filippvizvary/sub-mission/docs/quadchart/quad_chart.pdf

FESTIVAL VEDY A TECHNIKY AMAVET 2026 · ROBOTIKA A INTELIGENTNÉ STROJE | CELOŠTÁTNE KOLO · BRATISLAVA, 16.–17. 11. 2026

# Sub-Mission

Filip Vizváry, Šimon Filus | Gymnázium Milana Rúfusa, Žiar nad Hronom

Vedecká otázka / Ciele

Dá sa stanica na monitorovanie kvality vody napájať výhradne z
kinetickej energie toku — bez batérie na výmenu, bez slnka a bez operátora?
Riešenie: sonda bez kábla, batérie aj slnka — energiu berie z prúdiacej vody, dáta posiela rádiom.
Štátna sieť vzorkuje kvalitu vody približne raz za mesiac; hydrologické stanice chémiu nezachytia.
Budča 26. 7. 2021: 500 m³ digestátu, 37 km Hrona, 27 t rýb (25 druhov); nahlásili to rybári o 6:30, nie meracia sieť.
Ciele: sebestačnosť, 96 meraní denne namiesto 12 za rok, nasadenie bez zásuvky a signálu; kritériá: energia >10×, spojka >2,5×.

Dáta a výsledky

Výpočet (BEM model rotora + MPPT): výkon na hriadeli a z generátora proti rýchlosti toku. Spotreba 0,32 mW je o 2–3 rády nižšia.

Výpočet (magnetostatický
model): sklzový moment
spojky proti vzduchovej
medzere, proti záťaži rotora 0,16 N·m.

Metodológia / Návrh projektu

Bez otvoru pre hriadeľ: moment prenáša magnetická spojka (8 × N52 Ø10×5) cez pevnú 4 mm stenu podu.
Reťaz: BLDC generátor → usmerňovač → 2× superkondenzátor → regulátor 3,3 V.
Meranie: pH, TDS, turbidita, teplota, prietok z otáčok generátora; ESP32 s LoRa 868 MHz, dosah desiatky až stovky metrov bez výkonných antén.
Návrh overený výpočtom: BEM model rotora, model spojky, energetický model (Python, verejné repo).

Interpretácia a závery

Sebestačnosť je dosiahnuteľná: pri 0,5 m/s dáva generátor 25 mW (2 156 J/deň) proti 28 J/deň spotreby — rezerva 77×. Superkondenzátor drží 134 J použiteľnej energie = 4,8 dňa bez toku.
Spojka má pri 4–5 mm stene rezervu 4,9–6,5×, takže pod je utesnený bez pohyblivého tesnenia.
Obmedzenia, pomenované vopred: prototyp je doteraz na USB a generátor nikdy nenapájal dosku; test v rieke neprebehol; dosah LoRa overený len v interiéri; moment zubov nemeraný, rýchlosť rozbehu neznáma; pH je servisná veličina (14–30 dní).
Ďalej: spojenie harvestora s doskou, terénny test toku a dosahu, kalibrácia pH, nasadenie na lokalite.
Grafy a čísla sú výpočtom z modelov vo verejnom repe sub-mission (BEM, MPPT, magnetostatický model); meranie v rieke zatiaľ neprebehlo. | 2026
