filippvizvary/sub-mission/docs/quadchart/charts/energia.png

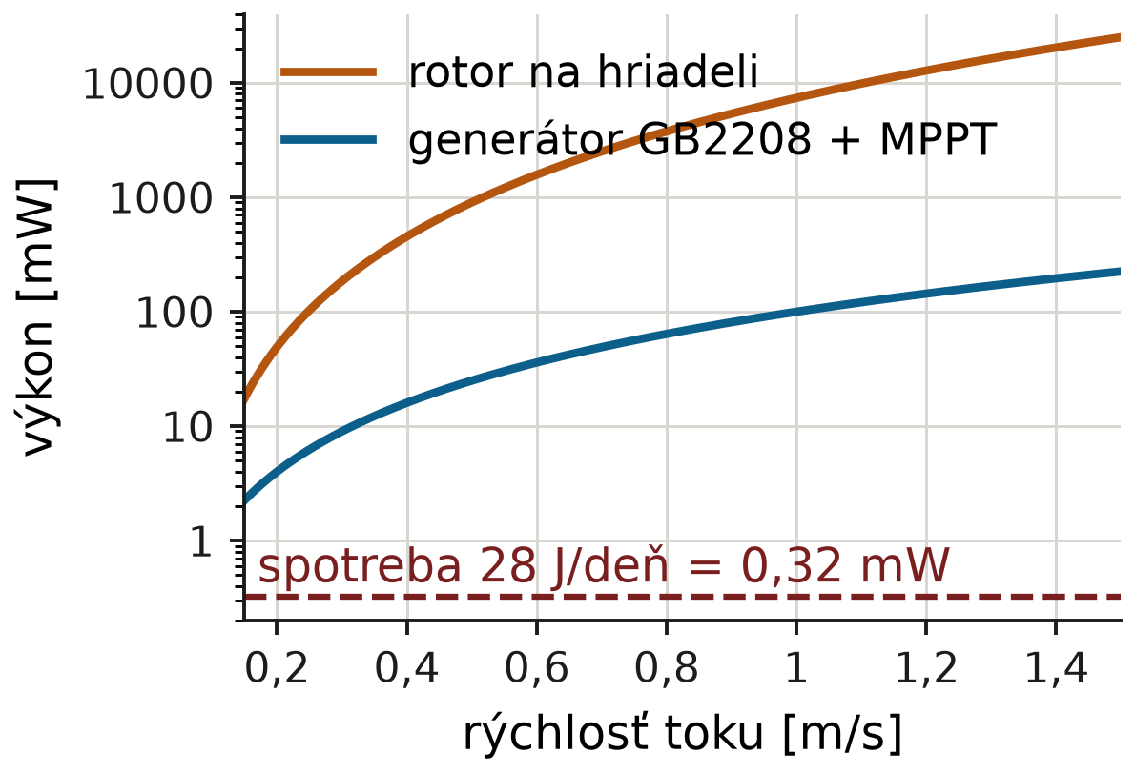
docs/quadchart/charts/energia.png
