filippvizvary/sub-mission/docs/quadchart/charts/schema.png

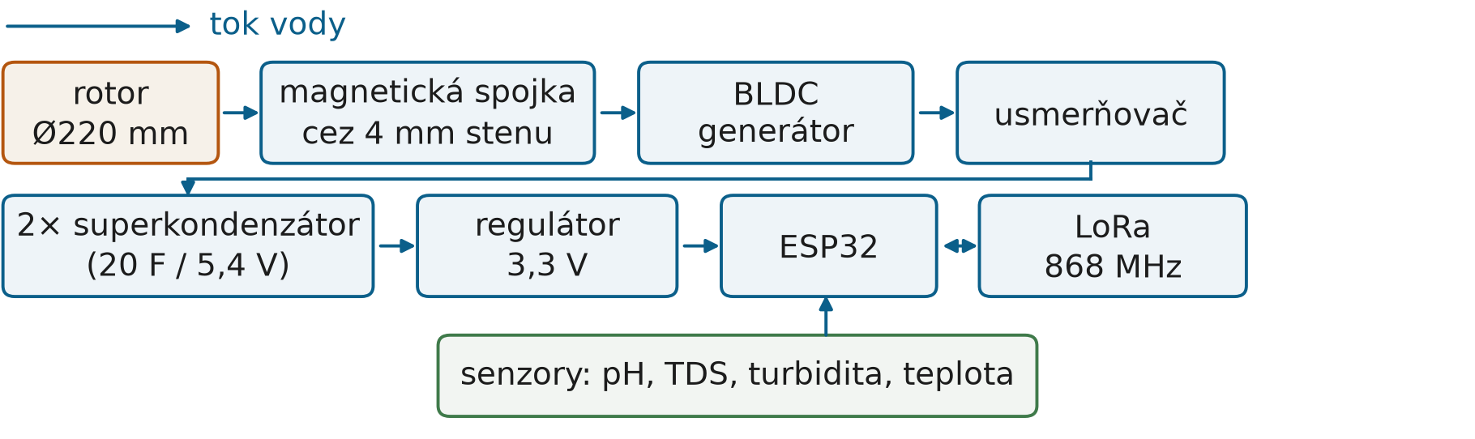
docs/quadchart/charts/schema.png
