filippvizvary/sub-mission/docs/quadchart/charts/spojka.png

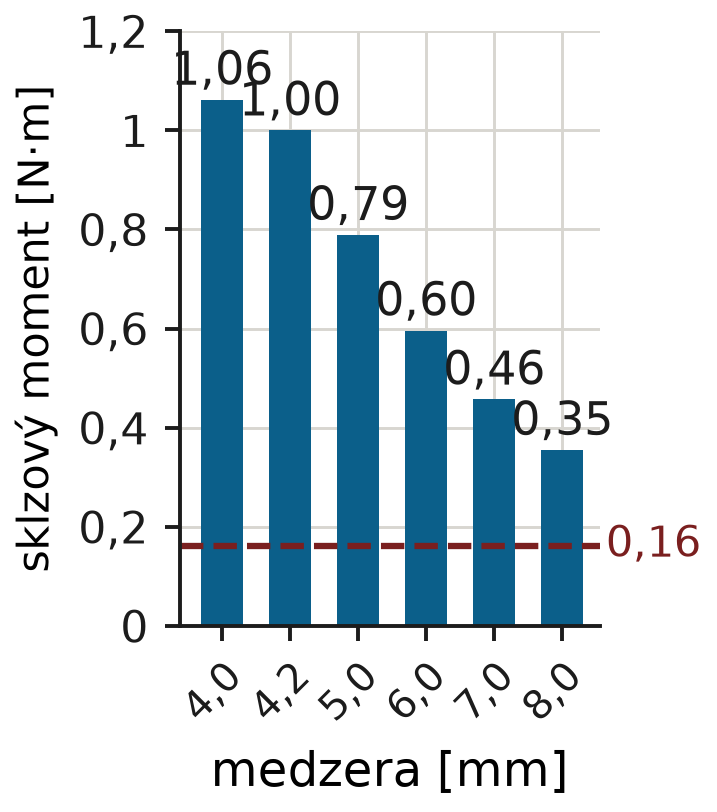
docs/quadchart/charts/spojka.png
