filippvizvary/sub-mission/docs/quadchart/prev2-1.jpg

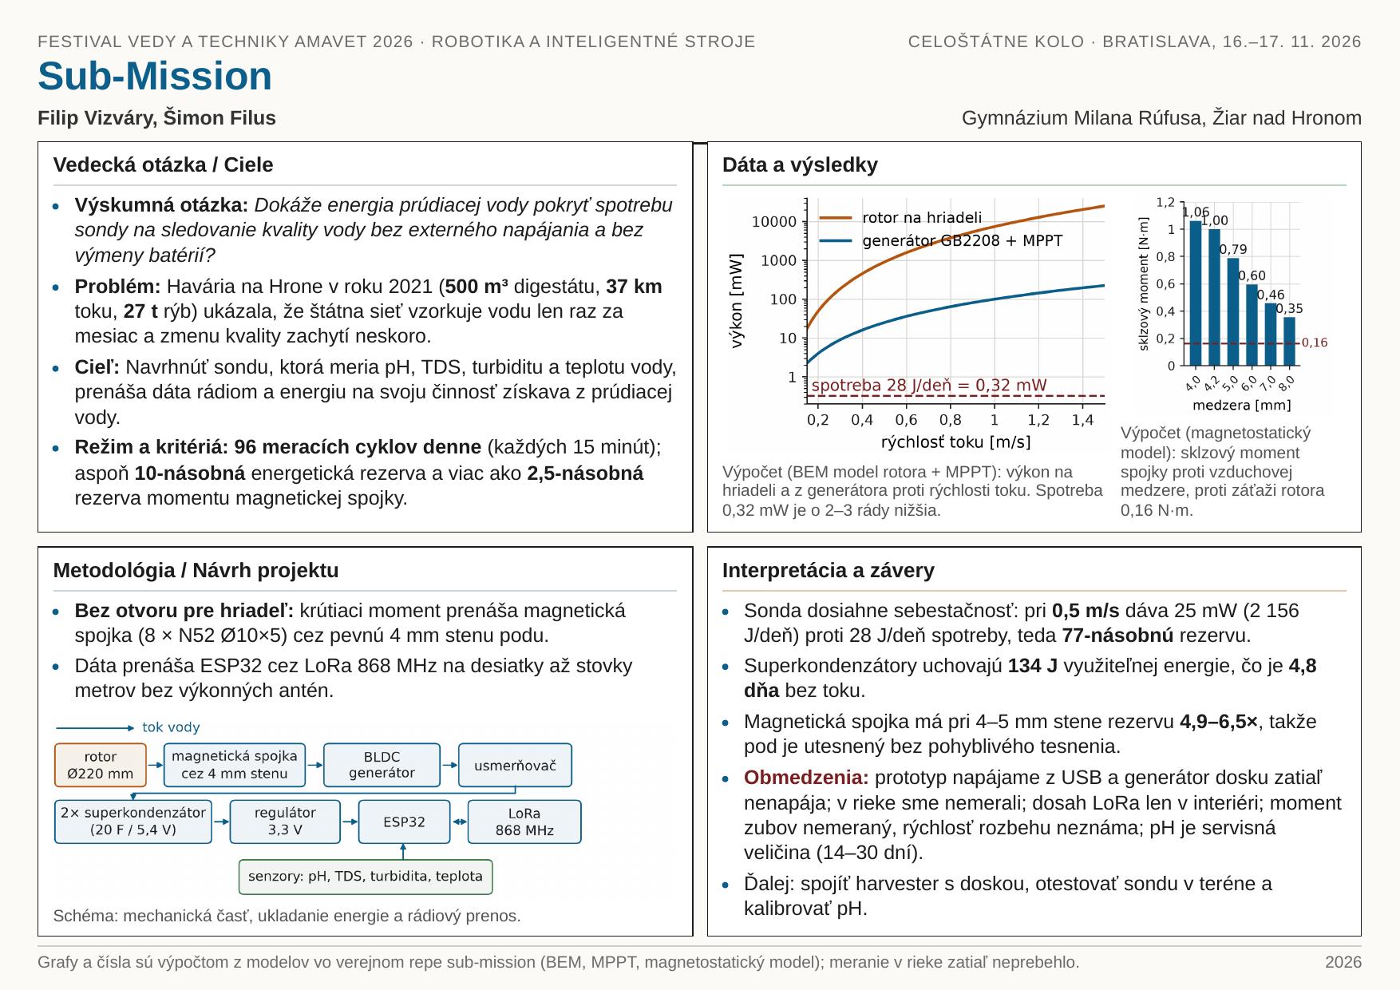
docs/quadchart/prev2-1.jpg
