filippvizvary/sub-mission/docs/PARTS_LIST.csv

id | subsystem | part | spec | qty_probe | qty_site | qty_gateway | source | price_eur | status | notes | phase | owned | link
A01 | rotor | Blade | triple-blade rotor, NACA 4-digit m4% t/c20%, D220, TSR5 alpha5: pitch 38.7->12.6 deg, chords 34.8->8.3 mm, TE 0.5 mm blunt, nose cone integrated | 3 | 0 | 0 | printed in-house | - | printed | t/c 12% gave 44 mm of tip sag at 8 N/blade; 20% gives 9.3 mm and drops the root stress to 7.1 MPa. Blade is the designed fuse - carry 2 spares | 1 | NO
A02 | rotor | Hub | Ø64x46mm, D-bore keyed on the shaft flat; NO inserts, NO set screws | 1 | 0 | 0 | printed in-house | - | printed | keyed by the flat (form drive, 4.2 MPa in ABS) and epoxied to the shaft for axial retention. A screw cannot cross the 29.5 mm wall from the Ø64 OD to the Ø5 shaft, and M4x30 was not available | 1 | NO
A03 | rotor | Wet shaft | 316L Ø5 h9 x 78mm drawn, PLAIN ROUND - no flat | 1 | 0 | 0 | nerezmaterial.cz | 2.6 | verified | The flat is gone: the hub, both cups and the old stop collars all used it and all three are replaced by the two-piece bolted clamps. Nothing to file. The shaft is located and driven by the clamps alone (friction: 0.9 N*m against 0.164). | 1 | NO
A04 | rotor | Wet bearing | igus iglidur J plain bearing JSM-0507-05 5x7x5mm | 2 | 0 | 0 | tme.eu | 1.18 | verified | 83 pcs in stock; JFM-0507-05 flanged 1.48 USD alt | 1 | NO | https://www.tme.eu/sk/details/jsm-0507-05/klzne-loziska/igus/
A05 | rotor | Bearing carrier tube | 316L Ø12xØ8x55mm | 1 | 0 | 0 | nerezmaterial.cz | 1.2 | quote | CUT: superseded - the bearing carrier is the printed spider (wet_carrier) | cut | NO
A06 | rotor | Hub cap screws | M4 x 30 socket head DIN 912, 2 pcs, tip on a 0.5 mm shaft flat | 2 | 0 | 0 | tme.eu | 0.4 | cut | CUT: no set screws anywhere in the drivetrain. Do not order M4x30. | 1 | NO | https://www.tme.eu/sk/katalog/?search=ISO%204029%20M4x8
A07 | rotor | Weed guard ring | Ø250 printed ring + 3 struts 40mm upstream of blade plane | 1 | 0 | 0 | printed in-house | - | printed | CUT: killed by design - replaced by the nose cone D64->D12; a ring on struts upstream is an algae scythe | cut | NO
A08 | rotor | Blade safety retainer | 3mm stainless lanyard + crimp ferrule | 3 | 0 | 0 | tme.eu | 2.0 | verified | CUT: killed by design - a tether on a 110 mm blade is a flail, and the hole is a stress riser at the root | cut | NO
A09 | rotor | Shaft collar Ø5 | Ø5 shaft collar, M3 grub screw, 4mm wide (axial stop between spider boss and wet cup) | 1 | 0 | 0 | local / TME | 1.5 | cut | CUT: the cup's 10 mm boss butts the static spider boss face at 61, so the cup cannot slide upstream. No bought collar. | 1 | NO
A10 | rotor | Dry shaft | 316L Ø5 h9 x 37mm, from the same 3m bar as A03 | 1 | 0 | 0 | nerezmaterial.cz | 0.3 | verified | 85..122 in the assembly: runs through the 695ZZ, gripped by the dry cup clamp at 93..105, and its end sits at the Oldham hub A slot floor | 1 | NO
A11 | rotor | Dry bearing | 695ZZ 5x13x4, 2Z metal shield (never 2RS - rubber seal drag is visible at 100mW) | 1 | 0 | 0 | eshop.valiveloziska.sk / loziskaelm.sk | 5.0 | todo | was missing from this list entirely; presses into the Ø13 H7 seat in the barrel's dry bearing boss | 1 | NO
A12 | coupling | Cup drive pin | Ø2 x 12 dowel pin, 2 pcs (wet cup + dry cup) | 2 | 0 | 0 | local / TME | 0.3 | cut | CUT: the cup is driven by a D-bore on the shaft flat. No Ø2 cross pin, no drilling a Ø2 hole through Ø5 stainless. | 1 | NO
B01 | coupling | Magnet | N52 D10x5 axially magnetised, canned 316L or epoxy potted | 24 | 0 | 0 | supermagnete.cz | 0.55 | verified | 24x N52 D10x5 (S-10-05-N52N, 3.3 kg) - 12 per cup, all of them; Filip has exactly 24 | 1 | NO | https://www.supermagnete.cz/kotoucove-magnety-neodymove/kotoucovy-magnet-10mm-5mm_S-10-05-N52N
B02 | coupling | Magnet cup | D70 x 5.65, 12 pockets D10.2x5.2 from the BACK, printed ASA | 2 | 0 | 0 | printed in-house |  | printed | ONE part for both cups, print twice. 0.45 mm membrane at the face (3 layers, printed on the bed); magnets go in from behind and the cover 14 closes them - no glue relied on | 1 | NO
B03 | coupling | Separation wall | D106 x 4 mm - RECOMMENDED integral with the pod bulkhead (no separate part) | 1 | 0 | 0 | nerezmaterial.cz / printed |  | cut | CUT: the 4mm bulkhead is printed as part of the barrel (cad/probe_cq.py make_pod) - nothing pierces the barrier, so there is no separate wall to seal | 1 | NO
B04 | coupling | Potting compound | 3M Scotch-Weld DP270 black 25ml | 1 | 0 | 0 | techfun.sk | 14.0 | verified | techfun nema DP270; silikonova zalievacia hmota staci na test, epoxid je tuhsi | 1 | NO | https://techfun.sk/produkt/ag-termopasty-priehladna-silikonova-zalievacia-hmota-037-100g/
B05 | coupling | Cup thrust washer (printed) | ABS ring Ø24/Ø8 x 1 mm, printed (r 4..12), sits in a 1 mm recess in the bulkhead's wet face | 1 | 0 | 0 | printed in-house | 0 | printed | printed ABS, 0.4 cm3, 4 min. GREASE IT with Molykote 111 (J05) - it is the same material as the barrel face, so the ring only lowers pressure and speed, the grease is what lowers friction. | 1 | NO
C01 | pod | Pod barrel | Ø110x120mm printed ASA wall 2.4mm + epoxy barrier | 1 | 0 | 0 | printed in-house | - | printed | one print: barrel + 4mm bulkhead + dry bearing boss (Ø13H7 seat for 695ZZ) + 4 spider bosses + O-ring groove + 6 clamp lugs | 1 | NO
C02 | pod | Tail cone | printed integral | 1 | 0 | 0 | printed in-house | - | printed |  | 1 | NO
C03 | pod | Pod O-ring | NBR 70 Ø100x2.5 | 1 | 0 | 0 | tme.eu | 3.0 | verified | NBR70 Ø100x2.5 (mars.sk code 879) seals the adapter joint at the barrel's downstream face | 1 | NO | https://www.tme.eu/sk/katalog/?search=O-krouzek%20100x2.5
C04 | pod | O-ring groove | 2.2mm wide x 1.8mm deep machined/printed into pod rim | 1 | 0 | 0 | in CAD | - | printed | groove is modelled in the barrel's downstream face: r 50.8-53.0, 2.2 x 1.8, printed on a flat top face | 1 | NO
C05 | pod | Pod clamp screws | M4x30 A4 + washers | 1 | 0 | 0 | tme.eu | 3.0 | verified | drzi zadny spoj; integralny bulkhead riesi len prednu stranu | 1 | NO | https://www.tme.eu/sk/katalog/?search=sroub%20M4x30%20A4
C06 | pod | Desiccant | 5g silica gel with indicator | 2 | 0 | 0 | local shop | 2.0 | verified | replace at service | 1 | NO | https://www.hornbach.sk/
C07 | pod | Cable gland wet side | Lapp Skintop MS-M 12x1.5 + Scotchcast 2131 | 1 | 0 | 0 | tme.eu | 12.0 | verified | NOT YET IN MODEL - add boss | 1 | NO | https://www.tme.eu/sk/katalog/?search=Skintop%20M12
C08 | pod | Generator | T-Motor GB2208 KV128 or X-TEAM XTG3506 (24N22P 6ohm w/ AS5048A encoder) | 1 | 0 | 0 | sk.x-teamrc.com / tmotor | 26.0 | verified | TEST BEZ GENERATORA: klietka + senzory stacia, generator je dalsi nakup; XTG3506 preferred: encoder = free RPM/flow | 1 | NO | https://www.x-teamrc.com/product/x-team-3506-gimbal-brushless-motor/
C09 | pod | Generator mount | printed cradle + 4x M3x8 A4 | 1 | 0 | 0 | printed in-house | 1.0 | printed | GB2208 cradle: bolts to the motor's own base bolt circle - measure the pattern on arrival; Oldham hub B on the bell's 4x M3 face | 1 | NO
D01 | sensors | pH electrode | DFRobot SEN0161-V2 Gravity pH kit + E201 BNC probe | 1 | 0 | 0 | techfun.sk | 39.0 | verified | pH kit: 39 EUR, 14-30 dni servis | OPTIONAL per site; 14-30 day service; +-0.1 pH after 2-pt cal | 2 | NO
D02 | sensors | pH spare electrode | E201-C BNC | 2 | 0 | 0 | techfun.sk | 9.0 | verified | pH spare electrodes: 18 EUR | consumable | 2 | NO
D03 | sensors | pH buffer | 2x250ml pH7 + pH10 | 1 | 0 | 0 | techfun.sk | 12.0 | verified | pH buffers: 12 EUR | consumable | 2 | NO
D04 | sensors | Temperature | DS18B20 waterproof 1m cable | 1 | 0 | 0 | techfun.sk | 5.0 | verified | in model as sensor_ntc | 1 | NO | https://techfun.sk/produkt/dfrobot-vodeodolny-senzor-teploty-ds18b20/
D05 | sensors | Level / stage probe | Submersible IP68 316L, 0-1 mH2O, 0.5-4.5V out, 5m cable, permanent immersion rated | 1 | 0 | 0 | TME / sensorsone (quote) | 110.0 | quote | level: 110 EUR, quote; bez varovania pred povodnou | MS5837-30BA REJECTED: gel element must be dried daily, 24h max submersion | 2 | NO
D06 | sensors | EC/TDS | DFRobot SEN0244 Gravity analog TDS module + probe | 1 | 0 | 0 | tme.eu | 14.0 | verified | +-10% FS is the weakest sensor; use as trend indicator, site-calibrate | 1 | NO | https://www.tme.eu/sk/katalog/?search=SEN0244
D07 | sensors | Turbidity | DFRobot SEN0189 (0-4.5V analog) | 1 | 0 | 0 | techfun.sk | 12.45 | verified | 6 in stock; in model as sensor_turb | 1 | NO | https://techfun.sk/produkt/dfrobot-turbidity-senzor-zakalu-vody/
D08 | sensors | Sensor cable | 4x2x0.5mm shielded PUR outdoor | 1 | 0 | 0 | tme.eu | 20.0 | verified | sensor cable 20 EUR - F01 8-zilovy to unesie | | 2 | NO
D09 | sensors | Dissolved oxygen kit | DFRobot SEN0237-A Gravity analog DO, 0-20 mg/L, BNC probe, 2m cable | 1 | 0 | 0 | global-ic.sk / botland.cz | 175.0 | verified | DO: 175 EUR, membrana 1-2 mesiace - prvy kandidat | HIGHEST-VALUE channel (Budca = hypoxia); membrane 1-2 months in muddy water; 0.5M NaOH filling solution NOT shipped by air - source locally | 2 | NO
E01 | cage | Sensor cage | Ø130x150 printed ASA 12 slots | 1 | 0 | 0 | printed in-house | - | printed | in model as cage | 1 | NO
E02 | cage | Cage fasteners | M3x10 A4 + nylok | 1 | 0 | 0 | tme.eu | 6.0 | verified |  | 1 | NO | https://www.tme.eu/sk/katalog/?search=sroub%20M3x10%20A4
E03 | cage | Sensor holders | printed clips for pH/TDS/turbidity/NTC/MS5837 | 5 | 0 | 0 | printed in-house | - | printed | in model as sensor bodies | 1 | NO
F01 | interface | Cable | 8x0.5mm2 PUR jacket submersible 6m | 1 | 0 | 0 | tme.eu | 35.0 | verified |  | 1 | NO | https://www.tme.eu/sk/katalog/?search=kabel%20PUR%208x0.5
F02 | interface | Bulkhead connector | potted gland entry (NOT SubConn) | 1 | 0 | 0 | tme.eu | 12.0 | verified | cost cut from 85 EUR wet-mate | 1 | NO | https://www.tme.eu/sk/katalog/?search=priechodka%20M12%20IP68
G01 | drybox | Enclosure | IP68 ready-made 190x130x80mm | 1 | 0 | 0 | tme.eu | 22.0 | verified | vynechane: vodotesna krabica na brehu - nie je sucastou stavby | in model as site_box | 2 | NO | https://www.tme.eu/sk/katalog/?search=box%20IP68
G02 | drybox | MCU (NOT USED in simple build) | LaskaKit ESP32-S3-DEVKit | 1 | 0 | 0 | laskakit.cz | 0.0 | verified | DROPPED: Wio-E5 mini is the single brain (MCU+LoRa). Bring back only if we need more GPIO/dual-core. | cut | NO
G03 | drybox | MCU + radio (single board) | Seeed XIAO nRF52840 + Wio-SX1262 kit (Meshtastic), SEE336 - nRF52840 + SX1262 | 1 | 0 | 0 | rpishop.cz | 14.00 | verified | 349 Kc, skladom 5+; nahradza Wio-E5, ktory v CZ/SK nie je; antena je v kite | 1 | NO | https://rpishop.cz/694263/seeed-studio-xiao-nrf52840-wio-sx1262-kit-pro-meshtastic/
G04 | drybox | Antenna probe | 868MHz 5dBi SMA-M omni 195mm | 0 | 0 | 1 | techfun.sk | 6.00 | verified | jedna 5 dBi na gateway; sonde staci bicik z kitu | 1 | NO | https://www.tme.eu/sk/katalog/?search=868%20MHz%20antena%20SMA
G05 | drybox | u.FL -> SMA pigtail | u.FL/IPEX female na SMA female bulkhead, 10-15 cm, RG178 | 1 | 0 | 1 | tme.eu | 3.00 | verified | KIT MA U.FL, NIE SMA: bez pigtailu na vacsiu antenu nepripojis; 1x sonda, 1x gateway | 1 | NO | https://www.tme.eu/sk/katalog/?search=u.FL%20SMA%20pigtail
G06 | drybox | Boost harvester | LTC3105EFE MPPT boost | 1 | 0 | 0 | tme.eu | 5.0 | verified | needed when EMF below bus | 1 | NO | https://www.tme.eu/sk/katalog/?search=LTC3105
G07 | drybox | Buck | TPS62A02DRC step-down | 1 | 0 | 0 | tme.eu | 2.5 | verified |  | 1 | NO | https://www.tme.eu/sk/katalog/?search=TPS62A02
G08 | drybox | Rectifier | Nexperia PMEG2010AEB 20V 1A SOD-523 | 6 | 0 | 0 | tme.eu | 0.15 | verified | 452k in stock | 1 | NO | https://www.tme.eu/sk/katalog/?search=PMEG2010AEB
G09 | drybox | Clamp | TL431LIAQ + MJD127T4G + PWR263S 3.3R dump | 1 | 0 | 0 | tme.eu | 4.0 | verified | overvoltage protection | 1 | NO | https://www.tme.eu/sk/katalog/?search=TL431
G10 | drybox | Supercap | Eaton XLR-4R0507 LIC 500F 4.0V | 1 | 0 | 0 | tme.eu | 11.0 | quote | NO coin-cell EDLC (50ohm ESR kills TX) | 1 | NO | https://www.tme.eu/sk/katalog/?search=XLR-4R0507
G11 | drybox | Voltage supervisor | TLV840 nanopower | 1 | 0 | 0 | tme.eu | 1.5 | verified | gates buck at 4.8V | 1 | NO | https://www.tme.eu/sk/katalog/?search=TLV840
G12 | drybox | Load switch | TPS22860 x2 for pH/EC sequencing | 2 | 0 | 0 | tme.eu | 1.0 | verified | removes ground-loop need | 1 | NO | https://www.tme.eu/sk/katalog/?search=TPS22860
G13 | drybox | Barometer | BME280 module outside potting in vented sub-box | 1 | 0 | 0 | laskakit.cz | 6.0 | verified | barometer 6 EUR - level sonda je gauge, netreba | pressure reference for MS5837 | 2 | NO
G14 | drybox | PCB | custom 2-layer 60x80mm | 1 | 0 | 0 | jlcpcb | 3.0 | quote | panel of 10 amortises | 1 | NO | https://jlcpcb.com/
G15 | drybox | Connectors | JST-PH/XH assortment + crimps | 1 | 0 | 0 | laskakit.cz | 10.0 | verified |  | 1 | NO | https://www.laskakit.cz/vyhledavani/?string=JST
G16 | drybox | Protection | Fuse 0.5A + TVS + ESD array | 1 | 0 | 0 | tme.eu | 6.0 | verified | NEMAM - poistka 0.5A + TVS SMBJ5.0A + ESD array (SOT-23-6) | 1 | NO | https://www.tme.eu/sk/katalog/?search=SMBJ5.0A
G17 | drybox | Cable glands | M12 IP68 potted x3 | 3 | 0 | 0 | tme.eu | 3.0 | verified |  | 1 | NO | https://www.tme.eu/sk/katalog/?search=priechodka%20M12%20IP68
H01 | site | Ground screw anchor | M68 x 800mm solar-fence ground screw | 0 | 1 | 0 | hornbach | 25.0 | verified | 1-2kN lateral - covers flood case | 1 | NO | https://www.hornbach.sk/
H02 | site | Pole | scaffold tube Ø48.3x3.2 x 3000mm galvanised | 0 | 1 | 0 | stavebniny | 18.0 | verified | removable mast pinned into receiver | 1 | NO | https://www.hornbach.sk/
H03 | site | Receiver sleeve | Ø52 tube 300mm + pin holes | 0 | 1 | 0 | metal shop | 8.0 | quote | receiver sleeve 8 EUR - pole sa da pripinacit priamo | pinned mast interface | 2 | NO
H04 | site | Arm tube | alu Ø28x1.5 x 1300mm | 0 | 1 | 0 | hornbach | 9.0 | verified |  | 1 | NO | https://www.hornbach.sk/
H05 | site | Drop tube | alu Ø22x1.5 x 900mm | 0 | 1 | 0 | hornbach | 6.0 | verified |  | 1 | NO | https://www.hornbach.sk/
H06 | site | Hinge collar | printed ASA + M8 A4 bolt | 0 | 1 | 0 | printed + tme | 3.0 | printed |  | 1 | NO
H07 | site | Shear pin | M4 316SS pin + 2 spares on pole collar | 0 | 1 | 0 | tme.eu | 1.0 | verified | releases pod on >150N debris hit | 1 | NO
H08 | site | Yaw strut | alu Ø22x600mm + 2 clamps | 0 | 1 | 0 | hornbach | 5.0 | verified | yaw strut 5 EUR - anti-flutter, vydrzi aj bez na test | anti-flutter | 2 | NO
H09 | site | Guy line | 3mm Dyneema 2x4m + turnbuckles | 0 | 1 | 0 | tme.eu | 9.0 | verified | 45deg up/downstream | 1 | NO | https://www.tme.eu/sk/katalog/?search=dyneema%203mm
H10 | site | Guy anchor | 300mm ground screw x2 | 0 | 1 | 0 | hornbach | 10.0 | verified |  | 1 | NO | https://www.hornbach.sk/
H11 | site | Safety cable | 3mm galv wire + ferrules tethering pod to pole | 0 | 1 | 0 | tme.eu | 4.0 | verified | theft/flood retention | 1 | NO | https://www.tme.eu/sk/katalog/?search=wire%20rope%203mm
H12 | site | Security fastener | one-way Torx M5 + steel band for box | 0 | 1 | 0 | tme.eu | 4.0 | verified | security fastener 4 EUR - az pri nasadeni | anti-theft | 2 | NO
H13 | site | Site label | engraved plate with project + contact | 0 | 1 | 0 | local print shop | 3.0 | verified | site label 3 EUR - az pri nasadeni | anti-theft by making it unsellable | 2 | NO
I01 | gateway | Gateway radio (single-channel) | Seeed XIAO nRF52840 + Wio-SX1262 kit (Meshtastic), SEE336 - nRF52840 + SX1262 | 0 | 0 | 1 | rpishop.cz | 14.00 | verified | 349 Kc, skladom 5+; nahradza Wio-E5, ktory v CZ/SK nie je; antena je v kite | 1 | NO | https://rpishop.cz/694263/seeed-studio-xiao-nrf52840-wio-sx1262-kit-pro-meshtastic/
I02 | gateway | Compute | Raspberry Pi 4 4GB + PSU + SD | 0 | 0 | 1 | local | 70.0 | verified | MAM - Raspberry Pi 4, staci mu USB napajanie | 1 | YES
I03 | gateway | Antenna | MikroTik 868_Omni 6.5dBi IP66 862-876MHz + mast kit | 0 | 0 | 1 | i4wifi.cz | 45.0 | quote | gateway antena 45 EUR - pouzijes svoju 868 + pigtail | range-critical: gateway antenna gain + mast height set the link | 2 | NO
I04 | gateway | Enclosure | IP65 box + PoE injector | 0 | 0 | 1 | tme.eu | 35.0 | verified | vynechane: krabica pre gateway na stozieri | | 2 | NO
I05 | gateway | Mast | 3m alu mast + wall bracket | 0 | 0 | 1 | hornbach | 30.0 | verified | 3 m stozier pre gateway - vyskou sa kupuje dosah | 1 | NO | https://www.hornbach.sk/
I06 | gateway | Concentrator upgrade (optional) | RAK2287 SX1302 mini-PCIe MODULE + RAK2287 Pi HAT (module alone is unusable - RPi has no mini-PCIe) | 0 | 0 | 1 | rakwireless reseller | 145.0 | quote | Only for multi-SF / multi-channel / public TTN. Single-channel Wio-E5 gateway is enough for our 20 nodes. | 2 | NO
J01 | consumable | Filament ASA | Prusament ASA 850g | 1 | 0 | 0 | prusa3d.com | 32.0 | verified | ABS z domaceho spoolu, nie ASA; UV je len na brehu | 1 | YES
J02 | consumable | Filament PC Blend | Prusament PC Blend 970g (for wall/structural) | 1 | 0 | 0 | prusa3d.com | 40.0 | verified | PC Blend 40 EUR - ABS staci, mas ho | | 2 | NO
J03 | consumable | Epoxy barrier | West System 105 + 206 | 1 | 0 | 0 | techfun.sk | 18.0 | verified |  | 1 | NO | https://www.hornbach.sk/
J04 | consumable | Conformal coat | Electrolube acrylic 200ml | 1 | 0 | 0 | tme.eu | 14.0 | verified | conformal coat 14 EUR - epoxid na DPS postaci | | 2 | NO
J05 | consumable | Silicone grease | Molykote 111 100g | 1 | 0 | 0 | tme.eu | 9.0 | verified | MAM - doma | 1 | YES
J06 | consumable | Threadlocker | Loctite 243 + 406 | 1 | 0 | 0 | tme.eu | 11.0 | verified | threadlocker 11 EUR - ak mas Loctite, usetri | | 2 | NO
J07 | consumable | Heat-set inserts | M3/M4 brass assortment | 1 | 0 | 0 | tme.eu | 6.0 | verified |  | 1 | NO | https://www.tme.eu/sk/katalog/?search=heat%20set%20insert%20M3
J08 | consumable | O-ring kit | NBR metric assortment | 1 | 0 | 0 | tme.eu | 12.0 | verified | O-ring kit 12 EUR - presny O-kruzok C03 uz v objednavke je | | 2 | NO
K01 | tooling | Vacuum chamber | Bel-Art F42025 + gauge + pump | 1 | 0 | 0 | tme.eu | 85.0 | verified | nastroj, nie suciastka - pozicat alebo kupit neskor | acceptance test rig (one-off) | 2 | NO
K02 | tooling | Torque driver | Wiha 28506 1.2Nm | 1 | 0 | 0 | tme.eu | 40.0 | verified | nastroj, nie diel | one-off | 2 | NO
K03 | tooling | Spring balance | 0-5N for coupling slip jig | 1 | 0 | 0 | local shop | 5.0 | verified | one-off | 1 | NO | https://www.hornbach.sk/
