filippvizvary/sub-mission/docs/sub-mission_parts.ods

Sheet: Order v1 (now)
sub-mission - phase 1 order
Grouped by shop, because that is how the order is placed. No spares added. Shipping is not in the parts list and is estimated at the bottom.
57 lines goods 402.11 EUR shipping est. 25.00 EUR LANDED 427.11 EUR
TME |  |  |  |  | 157.26
ID | Part | Specification / note | Qty | Unit EUR | Total EUR
F01 | Cable (https://www.tme.eu/sk/katalog/?search=kabel%20PUR%208x0.5) | 8x0.5mm2 PUR jacket submersible 6m | 1 | 35.00 | 35.00
D06 | EC/TDS (https://www.tme.eu/sk/katalog/?search=SEN0244) | DFRobot SEN0244 Gravity analog TDS module + probe - +-10% FS is the weakest sensor; use as trend indicator, site-calibrate | 1 | 14.00 | 14.00
C07 | Cable gland wet side (https://www.tme.eu/sk/katalog/?search=Skintop%20M12) | Lapp Skintop MS-M 12x1.5 + Scotchcast 2131 - NOT YET IN MODEL - add boss | 1 | 12.00 | 12.00
F02 | Bulkhead connector (https://www.tme.eu/sk/katalog/?search=priechodka%20M12%20IP68) | potted gland entry (NOT SubConn) - cost cut from 85 EUR wet-mate | 1 | 12.00 | 12.00
G10 | Supercap (https://www.tme.eu/sk/katalog/?search=XLR-4R0507) | Eaton XLR-4R0507 LIC 500F 4.0V - NO coin-cell EDLC (50ohm ESR kills TX) | 1 | 11.00 | 11.00
G17 | Cable glands (https://www.tme.eu/sk/katalog/?search=priechodka%20M12%20IP68) | M12 IP68 potted x3 | 3 | 3.00 | 9.00
H09 | Guy line (https://www.tme.eu/sk/katalog/?search=dyneema%203mm) | 3mm Dyneema 2x4m + turnbuckles - 45deg up/downstream | 1 | 9.00 | 9.00
E02 | Cage fasteners (https://www.tme.eu/sk/katalog/?search=sroub%20M3x10%20A4) | M3x10 A4 + nylok | 1 | 6.00 | 6.00
G05 | u.FL -> SMA pigtail (https://www.tme.eu/sk/katalog/?search=u.FL%20SMA%20pigtail) | u.FL/IPEX female na SMA female bulkhead, 10-15 cm, RG178 - KIT MA U.FL, NIE SMA: bez pigtailu na vacsiu antenu nepripojis; 1x sonda, 1x gateway | 2 | 3.00 | 6.00
G16 | Protection (https://www.tme.eu/sk/katalog/?search=SMBJ5.0A) | Fuse 0.5A + TVS + ESD array - NEMAM - poistka 0.5A + TVS SMBJ5.0A + ESD array (SOT-23-6) | 1 | 6.00 | 6.00
J07 | Heat-set inserts (https://www.tme.eu/sk/katalog/?search=heat%20set%20insert%20M3) | M3/M4 brass assortment | 1 | 6.00 | 6.00
G06 | Boost harvester (https://www.tme.eu/sk/katalog/?search=LTC3105) | LTC3105EFE MPPT boost - needed when EMF below bus | 1 | 5.00 | 5.00
G09 | Clamp (https://www.tme.eu/sk/katalog/?search=TL431) | TL431LIAQ + MJD127T4G + PWR263S 3.3R dump - overvoltage protection | 1 | 4.00 | 4.00
H11 | Safety cable (https://www.tme.eu/sk/katalog/?search=wire%20rope%203mm) | 3mm galv wire + ferrules tethering pod to pole - theft/flood retention | 1 | 4.00 | 4.00
C03 | Pod O-ring (https://www.tme.eu/sk/katalog/?search=O-krouzek%20100x2.5) | NBR 70 Ø100x2.5 - zadny spoj podu - bez neho sa pri ponoreni natecie | 1 | 3.00 | 3.00
C05 | Pod clamp screws (https://www.tme.eu/sk/katalog/?search=sroub%20M4x30%20A4) | M4x30 A4 + washers - drzi zadny spoj; integralny bulkhead riesi len prednu stranu | 1 | 3.00 | 3.00
G07 | Buck (https://www.tme.eu/sk/katalog/?search=TPS62A02) | TPS62A02DRC step-down | 1 | 2.50 | 2.50
A04 | Wet bearing (https://www.tme.eu/sk/details/jsm-0507-05/klzne-loziska/igus/) | igus iglidur J plain bearing JSM-0507-05 5x7x5mm - 83 pcs in stock; JFM-0507-05 flanged 1.48 USD alt | 2 | 1.18 | 2.36
A06 | Set screw (https://www.tme.eu/sk/katalog/?search=ISO%204029%20M4x8) | M4x8 316SS cup point ISO 4029 | 2 | 1.00 | 2.00
G12 | Load switch (https://www.tme.eu/sk/katalog/?search=TPS22860) | TPS22860 x2 for pH/EC sequencing - removes ground-loop need | 2 | 1.00 | 2.00
G11 | Voltage supervisor (https://www.tme.eu/sk/katalog/?search=TLV840) | TLV840 nanopower - gates buck at 4.8V | 1 | 1.50 | 1.50
H07 | Shear pin | M4 316SS pin + 2 spares on pole collar - releases pod on >150N debris hit | 1 | 1.00 | 1.00
G08 | Rectifier (https://www.tme.eu/sk/katalog/?search=PMEG2010AEB) | Nexperia PMEG2010AEB 20V 1A SOD-523 - 452k in stock | 6 | 0.15 | 0.90
J05 | Silicone grease | MAM | Molykote 111 100g - MAM - doma | 1 | 9.00 | 0.00
LOCAL / SHOP |  |  |  |  | 107.00
ID | Part | Specification / note | Qty | Unit EUR | Total EUR
I05 | Mast (https://www.hornbach.sk/) | 3m alu mast + wall bracket - 3 m stozier pre gateway - vyskou sa kupuje dosah | 1 | 30.00 | 30.00
H01 | Ground screw anchor (https://www.hornbach.sk/) | M68 x 800mm solar-fence ground screw - 1-2kN lateral - covers flood case | 1 | 25.00 | 25.00
H02 | Pole (https://www.hornbach.sk/) | scaffold tube Ø48.3x3.2 x 3000mm galvanised - removable mast pinned into receiver | 1 | 18.00 | 18.00
H10 | Guy anchor (https://www.hornbach.sk/) | 300mm ground screw x2 | 1 | 10.00 | 10.00
H04 | Arm tube (https://www.hornbach.sk/) | alu Ø28x1.5 x 1300mm | 1 | 9.00 | 9.00
H05 | Drop tube (https://www.hornbach.sk/) | alu Ø22x1.5 x 900mm | 1 | 6.00 | 6.00
K03 | Spring balance (https://www.hornbach.sk/) | 0-5N for coupling slip jig - one-off | 1 | 5.00 | 5.00
C06 | Desiccant (https://www.hornbach.sk/) | 5g silica gel with indicator - replace at service | 2 | 2.00 | 4.00
C04 | O-ring groove | 2.2mm wide x 1.8mm deep machined/printed into pod rim - NOT YET IN MODEL - add to pod | 1 | 0.00 | 0.00
I02 | Compute | MAM | Raspberry Pi 4 4GB + PSU + SD - MAM - Raspberry Pi 4, staci mu USB napajanie | 1 | 70.00 | 0.00
TECHFUN.SK |  |  |  |  | 55.45
ID | Part | Specification / note | Qty | Unit EUR | Total EUR
J03 | Epoxy barrier (https://www.hornbach.sk/) | West System 105 + 206 | 1 | 18.00 | 18.00
B04 | Potting compound (https://techfun.sk/produkt/ag-termopasty-priehladna-silikonova-zalievacia-hmota-037-100g/) | 3M Scotch-Weld DP270 black 25ml - techfun nema DP270; silikonova zalievacia hmota staci na test, epoxid je tuhsi | 1 | 14.00 | 14.00
D07 | Turbidity (https://techfun.sk/produkt/dfrobot-turbidity-senzor-zakalu-vody/) | DFRobot SEN0189 (0-4.5V analog) - 6 in stock; in model as sensor_turb | 1 | 12.45 | 12.45
G04 | Antenna probe (https://www.tme.eu/sk/katalog/?search=868%20MHz%20antena%20SMA) | 868MHz 5dBi SMA-M omni 195mm - jedna 5 dBi na gateway; sonde staci bicik z kitu | 1 | 6.00 | 6.00
D04 | Temperature (https://techfun.sk/produkt/dfrobot-vodeodolny-senzor-teploty-ds18b20/) | DS18B20 waterproof 1m cable - in model as sensor_ntc | 1 | 5.00 | 5.00
RPISHOP.CZ |  |  |  |  | 28.00
ID | Part | Specification / note | Qty | Unit EUR | Total EUR
G03 | MCU + radio (single board) (https://rpishop.cz/694263/seeed-studio-xiao-nrf52840-wio-sx1262-kit-pro-meshtastic/) | Seeed XIAO nRF52840 + Wio-SX1262 kit (Meshtastic), SEE336 - nRF52840 + SX1262 - 349 Kc, skladom 5+; nahradza Wio-E5, ktory v CZ/SK nie je; antena je v kite | 1 | 14.00 | 14.00
I01 | Gateway radio (single-channel) (https://rpishop.cz/694263/seeed-studio-xiao-nrf52840-wio-sx1262-kit-pro-meshtastic/) | Seeed XIAO nRF52840 + Wio-SX1262 kit (Meshtastic), SEE336 - nRF52840 + SX1262 - 349 Kc, skladom 5+; nahradza Wio-E5, ktory v CZ/SK nie je; antena je v kite | 1 | 14.00 | 14.00
X-TEAMRC.COM |  |  |  |  | 26.00
ID | Part | Specification / note | Qty | Unit EUR | Total EUR
C08 | Generator (https://www.x-teamrc.com/product/x-team-3506-gimbal-brushless-motor/) | T-Motor GB2208 KV128 or X-TEAM XTG3506 (24N22P 6ohm w/ AS5048A encoder) - TEST BEZ GENERATORA: klietka + senzory stacia, generator je dalsi nakup; XTG3506 preferred: encoder = free RPM/flow | 1 | 26.00 | 26.00
LASKAKIT.CZ |  |  |  |  | 10.00
ID | Part | Specification / note | Qty | Unit EUR | Total EUR
G15 | Connectors (https://www.laskakit.cz/vyhledavani/?string=JST) | JST-PH/XH assortment + crimps | 1 | 10.00 | 10.00
SUPERMAGNETICSHOP |  |  |  |  | 8.80
ID | Part | Specification / note | Qty | Unit EUR | Total EUR
B01 | Magnet (https://www.supermagnete.cz/kotoucove-magnety-neodymove/kotoucovy-magnet-10mm-5mm_S-10-05-N52N) | N52 D10x5 axially magnetised, canned 316L or epoxy potted - 16x N52 D10x5 (S-10-05-N52N, 3.3 kg); magsy 10x5 N52 nemá overený | 16 | 0.55 | 8.80
PRINTED IN-HOUSE |  |  |  |  | 4.00
ID | Part | Specification / note | Qty | Unit EUR | Total EUR
H06 | Hinge collar | printed ASA + M8 A4 bolt | 1 | 3.00 | 3.00
C09 | Generator mount | printed cradle + 4x M3x8 A4 | 1 | 1.00 | 1.00
A01 | Blade | triple-blade rotor blade NACA4412 D220mm root pitch 28deg tip 2deg - ASA or ASA-CF; 6 perimeters; epoxy coat; spare blade = fuse for branch strike | 3 | 0.00 | 0.00
A02 | Hub | Ø64x46mm with 2x M4 heat-set inserts and Ø5 H7 shaft bore - brass inserts M4 from TME | 1 | 0.00 | 0.00
B02 | Magnet cup | D70 rim, 8 pockets D10.2x5.2, printed ASA - pockets 10.2 dia (magnet 10 + 0.2 glue), 0.2 mm epoxy recess | 2 | 0.00 | 0.00
C01 | Pod barrel | Ø110x120mm printed ASA wall 2.4mm + epoxy barrier - in model as pod | 1 | 0.00 | 0.00
C02 | Tail cone | printed integral | 1 | 0.00 | 0.00
E01 | Sensor cage | Ø130x150 printed ASA 12 slots - in model as cage | 1 | 0.00 | 0.00
E03 | Sensor holders | printed clips for pH/TDS/turbidity/NTC/MS5837 - in model as sensor bodies | 5 | 0.00 | 0.00
JLCPCB |  |  |  |  | 3.00
ID | Part | Specification / note | Qty | Unit EUR | Total EUR
G14 | PCB (https://jlcpcb.com/) | custom 2-layer 60x80mm - panel of 10 amortises | 1 | 3.00 | 3.00
NEREZMATERIAL.CZ |  |  |  |  | 2.60
ID | Part | Specification / note | Qty | Unit EUR | Total EUR
A03 | Wet shaft | 316L Ø5 h6 x 115mm ground; 2 flats each end - lokalny zeleziar / Hornbach M5 A4 srob - 4. obchod sa nerata, nema postu; 3m bar 63.1 CZK makes ~26 shafts | 1 | 2.60 | 2.60
B03 | Separation wall | D106 x 4 mm - RECOMMENDED integral with the pod bulkhead (no separate part) - 4 mm per CAD, not 5; integral removes O-ring C03 and screws C05 | 1 | 0.00 | 0.00
PRUSA3D |  |  |  |  | 0.00
ID | Part | Specification / note | Qty | Unit EUR | Total EUR
J01 | Filament ASA | MAM | Prusament ASA 850g - ABS z domaceho spoolu, nie ASA; UV je len na brehu | 1 | 32.00 | 0.00
GOODS |  |  |  |  | 402.11
shipping, estimated |  |  |  |  | 25.00
LANDED TOTAL |  |  |  |  | 427.11
NOT IN THIS ORDER
PHASE 2 - BUY LATER
D01 | pH electrode | pH kit: 39 EUR, 14-30 dni servis | OPTIONAL per site; 14-30 day service; +-0.1 pH after 2-pt cal |  | 39.0
D02 | pH spare electrode | pH spare electrodes: 18 EUR | consumable |  | 9.0
D03 | pH buffer | pH buffers: 12 EUR | consumable |  | 12.0
D09 | Dissolved oxygen kit | DO: 175 EUR, membrana 1-2 mesiace - prvy kandidat | HIGHEST-VALUE channel (Budca = hypoxia); membrane 1-2 months in muddy water; 0.5M NaOH filling sol |  | 175.0
D05 | Level / stage probe | level: 110 EUR, quote; bez varovania pred povodnou | MS5837-30BA REJECTED: gel element must be dried daily, 24h max submersion |  | 110.0
D08 | Sensor cable | sensor cable 20 EUR - F01 8-zilovy to unesie | |  | 20.0
G01 | Enclosure | vynechane: vodotesna krabica na brehu - nie je sucastou stavby | in model as site_box |  | 22.0
G13 | Barometer | barometer 6 EUR - level sonda je gauge, netreba | pressure reference for MS5837 |  | 6.0
H03 | Receiver sleeve | receiver sleeve 8 EUR - pole sa da pripinacit priamo | pinned mast interface |  | 8.0
H08 | Yaw strut | yaw strut 5 EUR - anti-flutter, vydrzi aj bez na test | anti-flutter |  | 5.0
H12 | Security fastener | security fastener 4 EUR - az pri nasadeni | anti-theft |  | 4.0
H13 | Site label | site label 3 EUR - az pri nasadeni | anti-theft by making it unsellable |  | 3.0
I03 | Antenna | gateway antena 45 EUR - pouzijes svoju 868 + pigtail | range-critical: gateway antenna gain + mast height set the link |  | 45.0
I04 | Enclosure | vynechane: krabica pre gateway na stozieri | |  | 35.0
I06 | Concentrator upgrade (optional) | Only for multi-SF / multi-channel / public TTN. Single-channel Wio-E5 gateway is enough for our 20 nodes. |  | 145.0
J02 | Filament PC Blend | PC Blend 40 EUR - ABS staci, mas ho | |  | 40.0
J04 | Conformal coat | conformal coat 14 EUR - epoxid na DPS postaci | |  | 14.0
J06 | Threadlocker | threadlocker 11 EUR - ak mas Loctite, usetri | |  | 11.0
J08 | O-ring kit | O-ring kit 12 EUR - presny O-kruzok C03 uz v objednavke je | |  | 12.0
K01 | Vacuum chamber | nastroj, nie suciastka - pozicat alebo kupit neskor | acceptance test rig (one-off) |  | 85.0
K02 | Torque driver | nastroj, nie diel | one-off |  | 40.0
CUT - DEAD LINE, DO NOT BUY
A05 | Bearing carrier tube | CUT: superseded - the bearing carrier is the printed spider (wet_carrier) |  | 1.2
A07 | Weed guard ring | CUT: killed by design - replaced by the nose cone D64->D12; a ring on struts upstream is an algae scythe |  | -
A08 | Blade safety retainer | CUT: killed by design - a tether on a 110 mm blade is a flail, and the hole is a stress riser at the root |  | 2.0
G02 | MCU (NOT USED in simple build) | DROPPED: Wio-E5 mini is the single brain (MCU+LoRa). Bring back only if we need more GPIO/dual-core. |  | 0.0

Sheet: Parts list
sub-mission river probe - parts list (v1)
Prices in EUR incl. VAT where listed. REUSE column: YES = you already own it and it needs no soldering; CHECK = look in your box first; NO = must be bought. Install type 'soldered permanent' = cannot come from inventory once used.
ID | Part | Spec | Qty | Source | Unit EUR | Total EUR | Optional? | Reuse from inventory? | Install type | Status | Notes
1. Rotor & drivetrain (wet side)
A01 | Blade | triple-blade rotor blade NACA4412 D220mm root pitch 28deg tip 2deg | 3 | printed in-house | 0.00 EUR | 0.00 EUR | REQUIRED | NO | printed | printed | blade is the mechanical fuse; carry 2 spares | ASA or ASA-CF; 6 perimeters; epoxy coat; spare blade = fuse for branch strike
A02 | Hub | Ø64x46mm with 2x M4 heat-set inserts and Ø5 H7 shaft bore | 1 | printed in-house | 0.00 EUR | 0.00 EUR | REQUIRED | NO | printed | printed | brass inserts M4 from TME
A03 | Wet shaft | 316L Ø5 h6 x 115mm ground; 2 flats each end | 1 | nerezmaterial.cz | 2.60 EUR | 2.60 EUR | REQUIRED | NO | mechanical | verified | lokalny zeleziar / Hornbach M5 A4 srob - 4. obchod sa nerata, nema postu; 3m bar 63.1 CZK makes ~26 shafts
A04 | Wet bearing | igus iglidur J plain bearing JSM-0507-05 5x7x5mm | 2 | tme.eu | 1.18 EUR | 2.36 EUR | REQUIRED | NO | mechanical | verified | 83 pcs in stock; JFM-0507-05 flanged 1.48 USD alt
A05 | Bearing carrier tube | 316L Ø12xØ8x55mm | 1 | nerezmaterial.cz | 1.20 EUR | 1.20 EUR | REQUIRED | NO | mechanical | quote | CUT: superseded - the bearing carrier is the printed spider (wet_carrier)
A06 | Set screw | M4x8 316SS cup point ISO 4029 | 2 | tme.eu | 1.00 EUR | 2.00 EUR | REQUIRED | NO | mechanical | verified
A07 | Weed guard ring | Ø250 printed ring + 3 struts 40mm upstream of blade plane | 1 | printed in-house | 0.00 EUR | 0.00 EUR | REQUIRED | NO | mechanical | printed | CUT: killed by design - replaced by the nose cone D64->D12; a ring on struts upstream is an algae scythe
A08 | Blade safety retainer | 3mm stainless lanyard + crimp ferrule | 3 | tme.eu | 2.00 EUR | 6.00 EUR | DROP | NO | mechanical | verified | REMOVED: wire lanyard becomes a flail at 250 rpm, and the hole is a stress riser | CUT: killed by design - a tether on a 110 mm blade is a flail, and the hole is a stress riser at the root
subtotal - Rotor & drivetrain (wet side) |  |  |  |  |  | 8.16 EUR
2. Magnetic coupling
B01 | Magnet | N52 D10x5 axially magnetised, canned 316L or epoxy potted | 16 | supermagnete.cz | 0.55 EUR | 8.80 EUR | REQUIRED | NO | permanent (potted) | verified | N52 D10x5, 8 per cup on a D70 cup; must be canned/epoxy - bare N52 corrodes in weeks | 16x N52 D10x5 (S-10-05-N52N, 3.3 kg); magsy 10x5 N52 nemá overený
B02 | Magnet cup | D70 rim, 8 pockets D10.2x5.2, printed ASA | 2 | printed in-house | 0.00 EUR | 0.00 EUR | REQUIRED | NO | mechanical | printed | pockets 10.2 dia (magnet 10 + 0.2 glue), 0.2 mm epoxy recess
B03 | Separation wall | D106 x 4 mm - RECOMMENDED integral with the pod bulkhead (no separate part) | 1 | nerezmaterial.cz / printed | 0.00 EUR | 0.00 EUR | REQUIRED | NO | printed (integral) | quote | 4 mm per CAD, not 5; if printed integral with the pod bulkhead this line carries no hardware | 4 mm per CAD, not 5; integral removes O-ring C03 and screws C05
B04 | Potting compound | 3M Scotch-Weld DP270 black 25ml | 1 | techfun.sk | 14.00 EUR | 14.00 EUR | REQUIRED | NO | mechanical | verified | techfun nema DP270; silikonova zalievacia hmota staci na test, epoxid je tuhsi
subtotal - Magnetic coupling |  |  |  |  |  | 22.80 EUR
3. Generator pod & sealing
C01 | Pod barrel | Ø110x120mm printed ASA wall 2.4mm + epoxy barrier | 1 | printed in-house | 0.00 EUR | 0.00 EUR | REQUIRED | NO | mechanical | printed | in model as pod
C02 | Tail cone | printed integral | 1 | printed in-house | 0.00 EUR | 0.00 EUR | REQUIRED | NO | mechanical | printed
C03 | Pod O-ring | NBR 70 Ø100x2.5 | 1 | tme.eu | 3.00 EUR | 3.00 EUR | REQUIRED | NO | mechanical | verified | zadny spoj podu - bez neho sa pri ponoreni natecie
C04 | O-ring groove | 2.2mm wide x 1.8mm deep machined/printed into pod rim | 1 | in CAD | 0.00 EUR | 0.00 EUR | REQUIRED | NO | mechanical | todo | NOT YET IN MODEL - add to pod
C05 | Pod clamp screws | M4x30 A4 + washers | 1 | tme.eu | 3.00 EUR | 3.00 EUR | REQUIRED | NO | mechanical | verified | drzi zadny spoj; integralny bulkhead riesi len prednu stranu
C06 | Desiccant | 5g silica gel with indicator | 2 | local shop | 2.00 EUR | 4.00 EUR | REQUIRED | NO | mechanical | verified | replace at service
C07 | Cable gland wet side | Lapp Skintop MS-M 12x1.5 + Scotchcast 2131 | 1 | tme.eu | 12.00 EUR | 12.00 EUR | REQUIRED | NO | permanent (potted) | verified | NOT YET IN MODEL - add boss
C08 | Generator | T-Motor GB2208 KV128 or X-TEAM XTG3506 (24N22P 6ohm w/ AS5048A encoder) | 1 | sk.x-teamrc.com / tmotor | 26.00 EUR | 26.00 EUR | REQUIRED | CHECK | mechanical | verified | check your motor box first - v0 used a robot motor | TEST BEZ GENERATORA: klietka + senzory stacia, generator je dalsi nakup; XTG3506 preferred: encoder = free RPM/flow
C09 | Generator mount | printed cradle + 4x M3x8 A4 | 1 | printed in-house | 1.00 EUR | 1.00 EUR | REQUIRED | NO | mechanical | printed
subtotal - Generator pod & sealing |  |  |  |  |  | 49.00 EUR
4. Sensors
D01 | pH electrode | DFRobot SEN0161-V2 Gravity pH kit + E201 BNC probe | 1 | techfun.sk | 39.00 EUR | 39.00 EUR | OPTIONAL | NO | mechanical | verified | pH is the fragile channel: 14-30 day service | pH kit: 39 EUR, 14-30 dni servis | OPTIONAL per site; 14-30 day service; +-0.1 pH after 2-pt cal
D02 | pH spare electrode | E201-C BNC | 2 | techfun.sk | 9.00 EUR | 18.00 EUR | OPTIONAL | NO | consumable | verified | spare electrode | pH spare electrodes: 18 EUR | consumable
D03 | pH buffer | 2x250ml pH7 + pH10 | 1 | techfun.sk | 12.00 EUR | 12.00 EUR | OPTIONAL | NO | consumable | verified | buffers | pH buffers: 12 EUR | consumable
D04 | Temperature | DS18B20 waterproof 1m cable | 1 | techfun.sk | 5.00 EUR | 5.00 EUR | REQUIRED | CHECK | mechanical | verified | you have NTC 10K from v0, not DS18B20 | in model as sensor_ntc
D09 | Dissolved oxygen kit | DFRobot SEN0237-A Gravity analog DO, 0-20 mg/L, BNC probe, 2m cable | 1 | global-ic.sk / botland.cz | 175.00 EUR | 175.00 EUR | RECOMMENDED | NO | mechanical | verified | highest-value channel; but 30-day membrane service | DO: 175 EUR, membrana 1-2 mesiace - prvy kandidat | HIGHEST-VALUE channel (Budca = hypoxia); membrane 1-2 months in muddy water; 0.5M NaOH filling solution NOT shipped by air - source locally
D05 | Level / stage probe | Submersible IP68 316L, 0-1 mH2O, 0.5-4.5V out, 5m cable, permanent immersion rated | 1 | TME / sensorsone (quote) | 110.00 EUR | 110.00 EUR | RECOMMENDED | NO | mechanical | quote | replaces MS5837 (which must dry daily) | level: 110 EUR, quote; bez varovania pred povodnou | MS5837-30BA REJECTED: gel element must be dried daily, 24h max submersion
D06 | EC/TDS | DFRobot SEN0244 Gravity analog TDS module + probe | 1 | tme.eu | 14.00 EUR | 14.00 EUR | REQUIRED | NO | mechanical | verified | weakest accuracy in set (+-10% FS) | +-10% FS is the weakest sensor; use as trend indicator, site-calibrate
D07 | Turbidity | DFRobot SEN0189 (0-4.5V analog) | 1 | techfun.sk | 12.45 EUR | 12.45 EUR | REQUIRED | CHECK | mechanical | verified | v0 already has one - reuse if still working | 6 in stock; in model as sensor_turb
D08 | Sensor cable | 4x2x0.5mm shielded PUR outdoor | 1 | tme.eu | 20.00 EUR | 20.00 EUR | REQUIRED | NO | mechanical | verified | sensor cable 20 EUR - F01 8-zilovy to unesie
subtotal - Sensors |  |  |  |  |  | 405.45 EUR
5. Sensor cage & mounting
E01 | Sensor cage | Ø130x150 printed ASA 12 slots | 1 | printed in-house | 0.00 EUR | 0.00 EUR | REQUIRED | NO | mechanical | printed | in model as cage
E02 | Cage fasteners | M3x10 A4 + nylok | 1 | tme.eu | 6.00 EUR | 6.00 EUR | REQUIRED | NO | mechanical | verified
E03 | Sensor holders | printed clips for pH/TDS/turbidity/NTC/MS5837 | 5 | printed in-house | 0.00 EUR | 0.00 EUR | REQUIRED | NO | mechanical | printed | in model as sensor bodies
subtotal - Sensor cage & mounting |  |  |  |  |  | 6.00 EUR
6. Wet-dry interface (cable)
F01 | Cable | 8x0.5mm2 PUR jacket submersible 6m | 1 | tme.eu | 35.00 EUR | 35.00 EUR | REQUIRED | NO | permanent | verified
F02 | Bulkhead connector | potted gland entry (NOT SubConn) | 1 | tme.eu | 12.00 EUR | 12.00 EUR | REQUIRED | NO | permanent (potted) | verified | cost cut from 85 EUR wet-mate
subtotal - Wet-dry interface (cable) |  |  |  |  |  | 47.00 EUR
7. Electronics (dry box)
G01 | Enclosure | IP68 ready-made 190x130x80mm | 1 | tme.eu | 22.00 EUR | 22.00 EUR | REQUIRED | NO | mechanical | verified | ready-made IP68 box, do not print | vynechane: vodotesna krabica na brehu - nie je sucastou stavby | in model as site_box
G02 | MCU (NOT USED in simple build) | LaskaKit ESP32-S3-DEVKit | 1 | laskakit.cz | 0.00 EUR | 0.00 EUR | DROP | CHECK | socketed reusable | verified | not used: Wio-E5 mini is the single brain (MCU + radio) | DROPPED: Wio-E5 mini is the single brain (MCU+LoRa). Bring back only if we need more GPIO/dual-core.
G03 | MCU + radio (single board) | Seeed XIAO nRF52840 + Wio-SX1262 kit (Meshtastic), SEE336 - nRF52840 + SX1262 | 1 | rpishop.cz | 14.00 EUR | 14.00 EUR | REQUIRED | NO | socketed reusable | verified | 349 Kc, skladom 5+; nahradza Wio-E5, ktory v CZ/SK nie je; antena je v kite
G04 | Antenna probe | 868MHz 5dBi SMA-M omni 195mm | 1 | techfun.sk | 6.00 EUR | 6.00 EUR | REQUIRED | NO | mechanical | verified | jedna 5 dBi na gateway; sonde staci bicik z kitu
G05 | u.FL -> SMA pigtail | u.FL/IPEX female na SMA female bulkhead, 10-15 cm, RG178 | 2 | tme.eu | 3.00 EUR | 6.00 EUR | REQUIRED | NO | socketed reusable | verified | KIT MA U.FL, NIE SMA: bez pigtailu na vacsiu antenu nepripojis; 1x sonda, 1x gateway
G06 | Boost harvester | LTC3105EFE MPPT boost | 1 | tme.eu | 5.00 EUR | 5.00 EUR | REQUIRED | NO | soldered permanent | verified | needed when EMF below bus
G07 | Buck | TPS62A02DRC step-down | 1 | tme.eu | 2.50 EUR | 2.50 EUR | REQUIRED | NO | soldered permanent | verified
G08 | Rectifier | Nexperia PMEG2010AEB 20V 1A SOD-523 | 6 | tme.eu | 0.15 EUR | 0.90 EUR | REQUIRED | NO | soldered permanent | verified | 452k in stock
G09 | Clamp | TL431LIAQ + MJD127T4G + PWR263S 3.3R dump | 1 | tme.eu | 4.00 EUR | 4.00 EUR | REQUIRED | NO | soldered permanent | verified | overvoltage protection
G10 | Supercap | Eaton XLR-4R0507 LIC 500F 4.0V | 1 | tme.eu | 11.00 EUR | 11.00 EUR | REQUIRED | NO | soldered permanent | quote | LIC, not coin-cell EDLC (50 ohm ESR) | NO coin-cell EDLC (50ohm ESR kills TX)
G11 | Voltage supervisor | TLV840 nanopower | 1 | tme.eu | 1.50 EUR | 1.50 EUR | REQUIRED | NO | soldered permanent | verified | gates buck at 4.8V
G12 | Load switch | TPS22860 x2 for pH/EC sequencing | 2 | tme.eu | 1.00 EUR | 2.00 EUR | REQUIRED | NO | soldered permanent | verified | removes ground-loop need
G13 | Barometer | BME280 module outside potting in vented sub-box | 1 | laskakit.cz | 6.00 EUR | 6.00 EUR | REQUIRED | CHECK | socketed reusable | verified | BME280 modules are common in a parts box | barometer 6 EUR - level sonda je gauge, netreba | pressure reference for MS5837
G14 | PCB | custom 2-layer 60x80mm | 1 | jlcpcb | 3.00 EUR | 3.00 EUR | REQUIRED | NO | soldered permanent | quote | panel of 10 amortises | panel of 10 amortises
G15 | Connectors | JST-PH/XH assortment + crimps | 1 | laskakit.cz | 10.00 EUR | 10.00 EUR | REQUIRED | CHECK | mechanical | verified | you likely have JST/dupont assortments
G16 | Protection | Fuse 0.5A + TVS + ESD array | 1 | tme.eu | 6.00 EUR | 6.00 EUR | REQUIRED | NO | soldered permanent | verified | NEMAM - poistka 0.5A + TVS SMBJ5.0A + ESD array (SOT-23-6)
G17 | Cable glands | M12 IP68 potted x3 | 3 | tme.eu | 3.00 EUR | 9.00 EUR | REQUIRED | NO | permanent (potted) | verified
subtotal - Electronics (dry box) |  |  |  |  |  | 108.90 EUR
8. Structure & site
H01 | Ground screw anchor | M68 x 800mm solar-fence ground screw | 1 | hornbach | 25.00 EUR | 25.00 EUR | REQUIRED | NO | mechanical | verified | 1-2 kN lateral: this is what survives floods | 1-2kN lateral - covers flood case
H02 | Pole | scaffold tube Ø48.3x3.2 x 3000mm galvanised | 1 | stavebniny | 18.00 EUR | 18.00 EUR | REQUIRED | CHECK | mechanical | verified | scaffold tube - any builder's merchant | removable mast pinned into receiver
H03 | Receiver sleeve | Ø52 tube 300mm + pin holes | 1 | metal shop | 8.00 EUR | 8.00 EUR | REQUIRED | NO | machined | quote | receiver sleeve 8 EUR - pole sa da pripinacit priamo | pinned mast interface
H04 | Arm tube | alu Ø28x1.5 x 1300mm | 1 | hornbach | 9.00 EUR | 9.00 EUR | REQUIRED | CHECK | mechanical | verified
H05 | Drop tube | alu Ø22x1.5 x 900mm | 1 | hornbach | 6.00 EUR | 6.00 EUR | REQUIRED | CHECK | mechanical | verified
H06 | Hinge collar | printed ASA + M8 A4 bolt | 1 | printed + tme | 3.00 EUR | 3.00 EUR | REQUIRED | NO | printed | printed
H07 | Shear pin | M4 316SS pin + 2 spares on pole collar | 1 | tme.eu | 1.00 EUR | 1.00 EUR | REQUIRED | NO | mechanical | verified | shear pin releases pod on debris hit | releases pod on >150N debris hit
H08 | Yaw strut | alu Ø22x600mm + 2 clamps | 1 | hornbach | 5.00 EUR | 5.00 EUR | RECOMMENDED | NO | mechanical | verified | anti-flutter strut; drop only if arm is very stiff | yaw strut 5 EUR - anti-flutter, vydrzi aj bez na test | anti-flutter
H09 | Guy line | 3mm Dyneema 2x4m + turnbuckles | 1 | tme.eu | 9.00 EUR | 9.00 EUR | REQUIRED | NO | mechanical | verified | 45deg up/downstream
H10 | Guy anchor | 300mm ground screw x2 | 1 | hornbach | 10.00 EUR | 10.00 EUR | REQUIRED | NO | mechanical | verified
H11 | Safety cable | 3mm galv wire + ferrules tethering pod to pole | 1 | tme.eu | 4.00 EUR | 4.00 EUR | REQUIRED | NO | mechanical | verified | anti-theft / anti-loss tether | theft/flood retention
H12 | Security fastener | one-way Torx M5 + steel band for box | 1 | tme.eu | 4.00 EUR | 4.00 EUR | RECOMMENDED | NO | mechanical | verified | anti-theft | security fastener 4 EUR - az pri nasadeni | anti-theft
H13 | Site label | engraved plate with project + contact | 1 | local print shop | 3.00 EUR | 3.00 EUR | RECOMMENDED | NO | mechanical | verified | label makes it unsellable | site label 3 EUR - az pri nasadeni | anti-theft by making it unsellable
subtotal - Structure & site |  |  |  |  |  | 105.00 EUR
9. Gateway (base station)
I01 | Gateway radio (single-channel) | Seeed XIAO nRF52840 + Wio-SX1262 kit (Meshtastic), SEE336 - nRF52840 + SX1262 | 1 | rpishop.cz | 14.00 EUR | 14.00 EUR | REQUIRED | NO | socketed reusable | verified | single-channel Wio-E5 gateway: same radio as the probe, no concentrator needed | 349 Kc, skladom 5+; nahradza Wio-E5, ktory v CZ/SK nie je; antena je v kite
I02 | Compute | Raspberry Pi 4 4GB + PSU + SD | 1 | local | 70.00 EUR | 70.00 EUR | REQUIRED* | YES | socketed reusable | verified | YOU ALREADY HAVE THIS - reuse, zero soldering | MAM - Raspberry Pi 4, staci mu USB napajanie
I03 | Antenna | MikroTik 868_Omni 6.5dBi IP66 862-876MHz + mast kit | 1 | i4wifi.cz | 45.00 EUR | 45.00 EUR | REQUIRED* | NO | mechanical | quote | range-critical part | gateway antena 45 EUR - pouzijes svoju 868 + pigtail | range-critical: gateway antenna gain + mast height set the link
I04 | Enclosure | IP65 box + PoE injector | 1 | tme.eu | 35.00 EUR | 35.00 EUR | REQUIRED* | CHECK | mechanical | verified | vynechane: krabica pre gateway na stozieri
I05 | Mast | 3m alu mast + wall bracket | 1 | hornbach | 30.00 EUR | 30.00 EUR | REQUIRED* | CHECK | mechanical | verified | 3 m stozier pre gateway - vyskou sa kupuje dosah
I06 | Concentrator upgrade (optional) | RAK2287 SX1302 mini-PCIe MODULE + RAK2287 Pi HAT (module alone is unusable - RPi has no mini-PCIe) | 1 | rakwireless reseller | 145.00 EUR | 145.00 EUR | OPTIONAL | NO | socketed reusable | quote | RAK2287 concentrator + Pi HAT, only for multi-SF/public TTN; module alone will not fit a Pi | Only for multi-SF / multi-channel / public TTN. Single-channel Wio-E5 gateway is enough for our 20 nodes.
subtotal - Gateway (base station) |  |  |  |  |  | 339.00 EUR
10. Consumables
J01 | Filament ASA | Prusament ASA 850g | 1 | prusa3d.com | 32.00 EUR | 32.00 EUR | REQUIRED | CHECK | consumable | verified | you may only have PETG/PLA - ASA needed for UV/water | ABS z domaceho spoolu, nie ASA; UV je len na brehu
J02 | Filament PC Blend | Prusament PC Blend 970g (for wall/structural) | 1 | prusa3d.com | 40.00 EUR | 40.00 EUR | REQUIRED | CHECK | consumable | verified | PC Blend 40 EUR - ABS staci, mas ho
J03 | Epoxy barrier | West System 105 + 206 | 1 | techfun.sk | 18.00 EUR | 18.00 EUR | REQUIRED | NO | consumable | verified
J04 | Conformal coat | Electrolube acrylic 200ml | 1 | tme.eu | 14.00 EUR | 14.00 EUR | REQUIRED | NO | consumable | verified | conformal coat 14 EUR - epoxid na DPS postaci
J05 | Silicone grease | Molykote 111 100g | 1 | tme.eu | 9.00 EUR | 9.00 EUR | REQUIRED | CHECK | consumable | verified | MAM - doma
J06 | Threadlocker | Loctite 243 + 406 | 1 | tme.eu | 11.00 EUR | 11.00 EUR | REQUIRED | CHECK | consumable | verified | threadlocker 11 EUR - ak mas Loctite, usetri
J07 | Heat-set inserts | M3/M4 brass assortment | 1 | tme.eu | 6.00 EUR | 6.00 EUR | REQUIRED | CHECK | consumable | verified
J08 | O-ring kit | NBR metric assortment | 1 | tme.eu | 12.00 EUR | 12.00 EUR | REQUIRED | CHECK | consumable | verified | O-ring kit 12 EUR - presny O-kruzok C03 uz v objednavke je
subtotal - Consumables |  |  |  |  |  | 142.00 EUR
11. Tooling (one-off)
K01 | Vacuum chamber | Bel-Art F42025 + gauge + pump | 1 | tme.eu | 85.00 EUR | 85.00 EUR | RECOMMENDED | CHECK | reusable tool | verified | acceptance test rig; borrow if possible | nastroj, nie suciastka - pozicat alebo kupit neskor | acceptance test rig (one-off)
K02 | Torque driver | Wiha 28506 1.2Nm | 1 | tme.eu | 40.00 EUR | 40.00 EUR | RECOMMENDED | CHECK | reusable tool | verified | nastroj, nie diel | one-off
K03 | Spring balance | 0-5N for coupling slip jig | 1 | local shop | 5.00 EUR | 5.00 EUR | RECOMMENDED | CHECK | reusable tool | verified | needed for cogging/slip measurement | one-off
subtotal - Tooling (one-off) |  |  |  |  |  | 130.00 EUR
REQUIRED (everything needed to build and deploy) |  |  |  |  |  | 722.31 EUR
recommended add-ons (DO, level probe, anti-theft, tools) |  |  |  |  |  | 641.00 EUR
TOTAL if you buy everything |  |  |  |  |  | 1,363.31 EUR
saved by reusing what you already own |  |  |  |  |  | -70.00 EUR
net if you reuse your Raspberry Pi etc. |  |  |  |  |  | 1,293.31 EUR

Sheet: Summary
Cost by category
Category | Required EUR | Optional EUR | Items
1. Rotor & drivetrain (wet side) | 8.16 EUR | 0.00 EUR | 8
2. Magnetic coupling | 22.80 EUR | 0.00 EUR | 4
3. Generator pod & sealing | 49.00 EUR | 0.00 EUR | 9
4. Sensors | 51.45 EUR | 354.00 EUR | 9
5. Sensor cage & mounting | 6.00 EUR | 0.00 EUR | 3
6. Wet-dry interface (cable) | 47.00 EUR | 0.00 EUR | 2
7. Electronics (dry box) | 108.90 EUR | 0.00 EUR | 17
8. Structure & site | 93.00 EUR | 12.00 EUR | 13
9. Gateway (base station) | 194.00 EUR | 145.00 EUR | 6
10. Consumables | 142.00 EUR | 0.00 EUR | 8
11. Tooling (one-off) | 0.00 EUR | 130.00 EUR | 3
TOTAL | 722.31 EUR | 641.00 EUR
HOW TO READ
REUSE = YES -> you already own it, no soldering needed (Raspberry Pi 4 for the gateway).
REUSE = CHECK-> look in your parts box before buying (ESP32 devkits, JST, BME280, filament, tools).
Install type 'soldered permanent' -> cannot come from inventory; once built it stays in the board.
OPTIONAL -> pH module only. RECOMMENDED -> DO, level probe, anti-theft, tools.
DROP -> blade lanyard, removed: flail risk plus a stress riser at the blade root.
SENSOR NOTE
DO (SEN0237-A) is the highest-value channel: the 2021 Budca fish kill was oxygen depletion.
It is also the most maintenance-hungry: membrane 1-2 months in muddy water, so 30-day service.
MS5837-30BA was rejected: datasheet requires the element to be dried daily, 24 h max submersion.
TDS/EC is +-10% FS - a trend indicator, not an absolute measurement.
