filippvizvary/sub-mission/docs/final-list.xlsx

Sheet: Finálny zoznam
SUB-MISSION - finálny zoznam na objednanie
Cieľ: prototyp, ktorý sa točí, posiela dáta cez LoRa a drží vo vode. Brána si Web Serial rieši sama, dashboard na tomto zozname nie je.
Ceny a obchody sú zámerne prázdne - vyberáte si sami. Vypnutý je len generátor a rádio (skladom v EÚ, objednať dnes).
# | Súčiastka / špecifikácia | Ks | Poznámka | Cena (EUR) | Odkaz | Kúpiť (x)
1. ROTOR A HRIADEĽ
1 | List rotora - NACA4412, D220 mm, TSR 5, uhol 38,7° na päte -> 12,6° na hrote | 3 | TLAČÍ SA | twist je z sim/rotor_check.py (TSR 5, alpha 5), nie stará tabuľka 28°/2°
2 | Náboj rotora - Ø64x46 mm, 2x zalisovaná vložka M4, diera Ø5 H7 | 1 | TLAČÍ SA | vložky M4 z TME
3 | Mokrá hriadeľ - 316L Ø5 h6 x 115 mm, brúsená, 2 plôšky na koncoch | 1
4 | Mokré ložisko - klzné puzdro igus iglidur J, 5x7x5 mm (JSM-0507-05) | 2
5 | Zaisťovacia skrutka - M4x8, 316SS, hrot s dôlkom (ISO 4029) | 2
2. MAGNETICKÁ SPOJKA
6 | Magnet - N52 Ø10x5, axiálne magnetizovaný, epoxidom zaliate | 16
7 | Magnetová miska - Ø70, 8 puzdier Ø10,2x5,2, tlačená ASA | 2 | TLAČÍ SA | puzdro 10,2 mm = magnet 10 + 0,2 lepidlo
8 | Prepadová stena - Ø106 x 4 mm, súčasť prepážky podu, nie samostatný diel | 1 | integrovať do prepážky - odstráni O-krúžok C03 a 4 skrutky cez stenu
9 | Zalievácia hmota - 3M Scotch-Weld DP270 čierna, 25 ml | 1
10 | Magnety navyše pre verziu s cievkou - N52 Ø10x5, 20 ks na čelo x 2 čelá | 40 | VOLITEĽNÉ - voľná axiálna mašina, 10 pólových párov, 72 Hz pri 434 rpm
3. TELESO PODU
11 | Valec podu - Ø110x120 mm, ASA 2,4 mm + epoxidová bariéra | 1 | TLAČÍ SA
12 | Zadný kužeľ - tlačený, integrálny s valcom | 1 | TLAČÍ SA
13 | O-krúžok podu - NBR 70, Ø100x2,5 | 1
14 | Drážka pre O-krúžok - 2,2 mm šírka x 1,8 mm hĺbka, v okraji podu | 1 | TLAČÍ SA | ZATIAĽ NIE JE V MODELI - doplniť do podu
15 | Skrutky svorníka podu - M4x30 A4 + podložky | 1
16 | Sikativ - 5 g silikagél s indikátorom | 2
17 | Káblová priechodka - mokrá strana - Lapp Skintop MS-M 12x1,5 + Scotchcast 2131 | 1 | ZATIAĽ NIE JE V MODELI - doplniť boss
18 | Generátor - iPower GM3506 gimbal BLDC s encoderom AS5048A - 24N/22P, 5,6 ohm, 72 g, dutá hriadeľ Ø12/8,6, no-load 2149-2375 rpm pri 16 V (KV ~147 rpm/V), 610 mm kábel, dupont konektor (https://iflight-rc.eu/en/products/ipower-gm3506-gimbal-motor-with-encoder) | 1 | Objednať DNES - sklad v Rakúsku, GLS/UPS, 2-5 dní. Pri 434 rpm: E_ll 2,95 V, ~97 mW. Encoder = RPM/prietok zdarma. | 50.90 EUR | iflight-rc.eu -> GM3506 (klikni) (https://iflight-rc.eu/en/products/ipower-gm3506-gimbal-motor-with-encoder)
19 | Držiak generátora - tlačený + 4x M3x8 A4 | 1 | TLAČÍ SA | rozteč dier podľa dielu, ktorý príde
20 | Klietka senzorov - Ø130x150, tlačená ASA, 12 drážok | 1 | TLAČÍ SA
21 | Spojovací materiál klietky - M3x10 A4 + samosvorné matice | 1
22 | Úchytky senzorov - tlačené pre pH / TDS / zákal / teplotu / hladinu | 5 | TLAČÍ SA
23 | Kábel - 8x0,5 mm² PUR, ponorný, 6 m | 1
24 | Priechodka do prepážky - zaliata priechodka (nie SubConn) | 1 | ušetrené 85 EUR oproti mokrému konektoru
4. SENZORY (prototyp: teplota + TDS + zákal)
25 | Teplota vody - DS18B20, vodotesný, 1 m kábel | 1 | v modeli ako sensor_ntc
26 | Vodivosť / TDS - DFRobot SEN0244 Gravity, analógový modul + sonda | 1 | +-10 % rozsahu je najslabší senzor - použiť ako trend, nie ako meranie
27 | Zákal - DFRobot SEN0189, analógový výstup 0-4,5 V | 1 | 2:1 delič 10k/10k POVINNÝ, výstup má 4,5 V
5. ELEKTRONIKA - SUCHÁ SCHRÁNKA
28 | MCU + rádio - Seeed XIAO ESP32S3 + Wio-SX1262 kit (SEE319) - ESP32-S3R8 240 MHz, 9x ADC ale 6 použiteľných (D0-D5), 11x GPIO, SX1262 862-930 MHz, LoRa anténa v balení (https://rpishop.cz/?s=Wio-SX1262&post_type=product) | 1 | 339 Kč, skladom 5+. Riadenie rádiа ide cez zadný B2B konektor, preto D0-D5 zostávajú ako ADC. D8/D9/D10 sú SPI rádiа. | 13.90 EUR | rpishop.cz SEE319 (klikni) (https://rpishop.cz/?s=Wio-SX1262&post_type=product)
29 | Anténa na sondu - 868 MHz 5 dBi, SMA, omni, 195 mm | 1 | VOLITEĽNÉ - kit má LoRa anténu v balení; lepšia patrí na bránu
30 | Pigtail u.FL -> SMA - u.FL (IPEX) -> SMA, 10-15 cm, RG178 | 2 | kit má u.FL, nie SMA - bez pigtailu lepšiu anténu nepripojíš
31 | MPPT boost - LTC3105EFE | 1
32 | Buck - TPS62A02DRC, step-down | 1
33 | Usmerňovač - Nexperia PMEG2010AEB, 20 V 1 A, SOD-523, 6 ks | 6
34 | Clamp - TL431LIAQ + MJD127T4G + PWR263S 3,3R záťaž | 1
35 | Superkondenzátor - Eaton XLR-4R0507 LIC, 500 F, 4,0 V | 1 | NIE gombíkový EDLC (50 ohm ESR zabije TX)
36 | Naprťový supervisor - TLV840, nanoprúdový | 1 | otvára buck až pri 4,8 V na capu
37 | Load switch - TPS22860, 2 ks, spínanie pH/EC | 2 | odstraňuje potrebu galvanického oddelenia
38 | DPS - vlastná 2-vrstvová, 60x80 mm | 1
39 | Konektory - sada JST-PH/XH + krimpy | 1
40 | Ochrany - poistka 0,5 A + TVS + ESD pole | 1
41 | Káblové priechodky - M12 IP68 zaliate, 3 ks | 3
42 | 5 V boost pre senzory - TPS61023, 3,3 V -> 5 V, 0,5 A | 1 | VOLITEĽNÉ: XIAO má 5 V len z USB. V teréne bez tohoto boostu zákal nepobeží.
6. RÁDIO A BRÁNA
43 | Rádio brány - Seeed XIAO ESP32S3 + Wio-SX1262 kit (SEE319) - ten istý kit ako v sonde, aby bol firmware identický (https://rpishop.cz/?s=Wio-SX1262&post_type=product) | 1 | 339 Kč, skladom 5+. Spolu 2 ks (sonda + brána). | 13.90 EUR | rpishop.cz SEE319 (klikni) (https://rpishop.cz/?s=Wio-SX1262&post_type=product)
44 | Výpočtová jednotka - Raspberry Pi 4 4GB + zdroj + SD karta | 1 | MÁŠ DOMA - Raspberry Pi 4
45 | Stožiar brány - 3 m Al stožiar + nástenný držiak | 1 | výškou sa kupuje dosah rádia
7. MATERIÁL A SPOTREBNÝ
46 | Filament ASA - Prusament ASA 850 g | 1 | MÁŠ DOMA - ABS z domáceho spoolu, nie ASA; over UV
47 | Epoxidová bariéra - West System 105 + 206 | 1
48 | Silikónová vazelína - Molykote 111, 100 g | 1 | MÁŠ DOMA
49 | Zalisované vložky - mosadzné M3/M4, sada | 1
50 | Lakovaný drôt 0,5 mm - smaltovaný (CUL/DN2E), 50 m - min. 26 m na 12 cievok | 1 | VOLITEĽNÉ - len ak staviaš verziu s vlastnou cievkou. NIE šperkársky drôt.
8. MERANIE A PRÍPRAVA
51 | Pružinová váha - 0-5 N, na meranie sklzu spojky | 1
9. STAVBA NA BREHU (aby to šlo do vody)
52 | Zemná skrutka - M68 x 800 mm, pre solárne ploty | 1
53 | Stožiar - lešenárska trubka Ø48,3x3,2 x 3000 mm, pozinkovaná | 1 | vyberateľný stožiar, zapichnutý do zemnej skrutky
54 | Rameno - Al Ø28x1,5 x 1300 mm | 1
55 | Závesná trubka - Al Ø22x1,5 x 900 mm | 1
56 | Objímka závesu - tlačená ASA + skrutka M8 A4 | 1 | TLAČÍ SA
57 | Strižný kolík - M4 316SS + 2 náhradné | 1 | povolí pod pri náraze nad ~150 N
58 | Výťažné lano - 3 mm Dyneema 2x4 m + napínaky | 1 | 45° hore/dolu prúdu
59 | Kotva lana - zemná skrutka 300 mm, 2 ks | 1
60 | Bezpečnostné lanko - 3 mm pozinkované + objímky, istí pod proti stožiaru | 1 | proti krádeži a pri povodni
10. FÁZA 2 - NEKUPOVAŤ TERAZ (pH, rozpustený kyslík, hladina, IP68 krabica, anténa)
61 | pH elektróda - DFRobot SEN0161-V2 Gravity pH kit + E201 BNC sonda | 1 | 14-30 dní servis - jediný kanál, ktorý nie je 90-dňový
62 | Náhradná pH elektróda - E201-C BNC, 2 ks | 2
63 | pH pufre - 2x 250 ml pH 7 + pH 10 | 1
64 | Rozpustený kyslík - DFRobot SEN0237-A Gravity, 0-20 mg/l, BNC, 2 m | 1 | 175 EUR, membrána 1-2 mesiace - prvý kandidát na vynechanie
65 | Hladinová sonda - ponorná IP68 316L, 0-1 m H2O, 0,5-4,5 V, 5 m kábel | 1 | 110 EUR, quote; bez varovania pred povodňou nemá zmysel
66 | Kábel senzorov - 4x2x0,5 mm² tienený PUR, vonkajší | 1
67 | Krabica na brehu - IP68 hotová, 190x130x80 mm | 1
68 | Barometer - BME280, mimo zaliatia, v odvetranej komôrke | 1
69 | Anténa brány - MikroTik 868_Omni 6,5 dBi IP66, 862-876 MHz + držiak | 1
70 | Krabica brány - IP65 + PoE injektor | 1
71 | Koncentrátor (voliteľný) - RAK2287 SX1302 mini-PCIe + Pi HAT | 1 | len pre viac SF / kanálov / verejnú TTN - nie pre v1
72 | Filament PC Blend - Prusament PC Blend 970 g | 1
73 | Konformný lak - Electrolube akryl, 200 ml | 1
74 | Závitová poistka - Loctite 243 + 406 | 1
75 | Sada O-krúžkov - NBR metrická sada | 1
76 | Vákuová komora - Bel-Art F42025 + manometer + pumpa | 1 | nástroj, nie súčiastka - požičať alebo kúpiť
77 | Momentový skrutkovač - Wiha 28506, 1,2 Nm | 1 | nástroj, nie diel
78 | Objímka prijímača - Ø52 trubka 300 mm + diery na kolík | 1
79 | Smerová vzpera - Al Ø22x600 mm + 2 objímky | 1
80 | Bezpečnostný spoj - jednosmerný Torx M5 + oceľová páska | 1
81 | Štítok lokality - gravýrovaný, projekt + kontakt | 1
11. ZRUŠENÉ - NEKUPOVAŤ (design ich zabil, uvádzame ich len pre poriadok)
~~-~~ | ~~Nosič ložiska (zrušené) - 316L Ø12xØ8x55 mm~~ | ~~-~~ | ~~nahradené tlačeným nosičom~~
~~-~~ | ~~Kruh proti riasam (zrušené) - Ø250 tlačený prstenec + 3 vzpery~~ | ~~-~~ | ~~nahradené nosovým kužeľom - prstenec je kosa na riasy~~
~~-~~ | ~~Lanko listu (zrušené) - 3 mm nerez + objímka~~ | ~~-~~ | ~~lanko na liste je flail, Filip ho sám zamietol~~
~~-~~ | ~~MCU ESP32-S3 devkit (zrušené) - LaskaKit ESP32-S3-DEVKit - v jednoduchej stavbe sa nepoužije~~ | ~~-~~ | ~~jedna doska XIAO nahradila dve~~

Sheet: Poznámky
Generátor GM3506 na našom rotore (434 rpm pri 1,0 m/s)
v [m/s] | otáčky | E_ll [V] | zbernica [V] | P_elec [mW]
0.3 | 130 | 0.9 | 0.32 | 9
0.5 | 217 | 1.5 | 0.89 | 25
0.8 | 347 | 2.39 | 1.75 | 64
1 | 434 | 2.99 | 2.32 | 97
1.5 | 651 | 4.49 | 3.75 | 225
Denná potreba systému: 15-28 J (deep sleep + 96 reportov) -> rezerva 30-300x.
Live streaming cez Web Serial (~150 mW) generátor neutiahne - demo beží z USB, generátor dobíja cap.
Cogging, voľnobežný odpor a ložiská = zmerať na stole po doručení (gating #1).
Čo sa NEKUPUJE - tlačí sa doma
- 3x list rotora (ASA), náboj Ø64x46
- 2x magnetová miska Ø70 (8 puzdier Ø10,2x5,2)
- valec podu Ø110x120 + kužeľ, prepadová stena Ø106x4 v prepážke
- klietka Ø130x150, úchytky senzorov, držiak generátora
Čo na zozname NIE JE a prečo
- dashboard / web - brána si Web Serial rieši sama
- pH, rozpustený kyslík, hladinová sonda - fáza 2
- Raspberry Pi - máš doma (I02)
- lepšia anténa na bránu - až s fázou 2, kit má stub v balení
