filippvizvary/sub-mission/cad/parts/rotor_edit.step

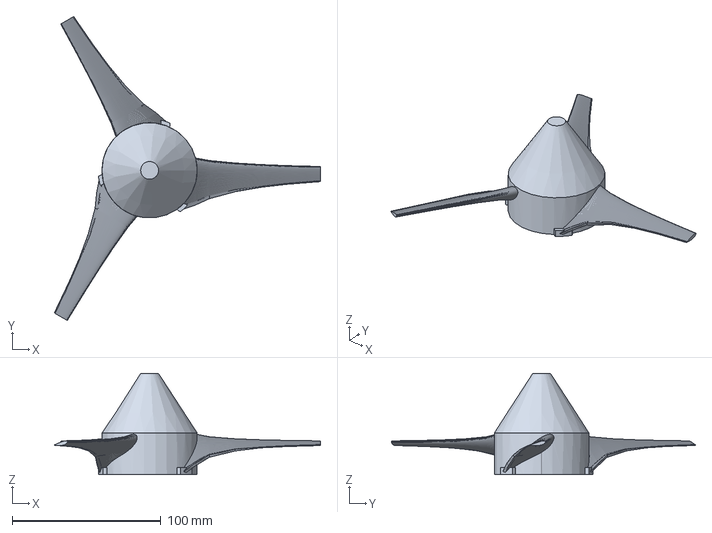
[picture p9: CAD file, 2026-11-11]
cad/parts/rotor_edit.step
179.0 x 204.2 x 68.0 mm
