filippvizvary/sub-mission/archive/freecad/rotor.step

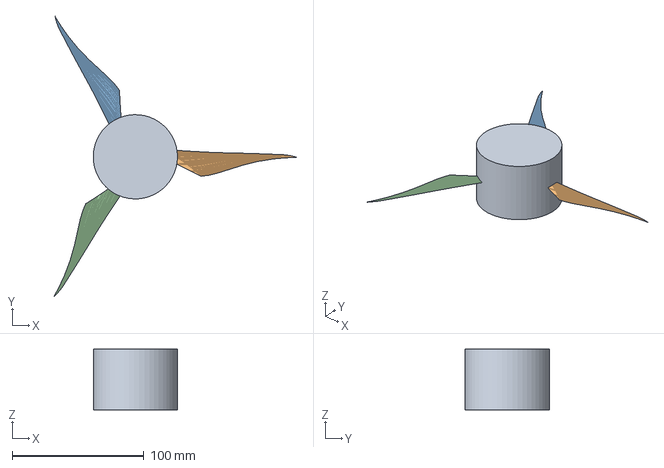
[picture p10: CAD file, 2026-10-18, an earlier design]
archive/freecad/rotor.step
184.5 x 212.6 x 46.0 mm
