filippvizvary/sub-mission/(list of files, cad)

Other CAD files:
cad/parts/rotor.step
cad/probe_v1r1.scad
archive/freecad/rotor.fcstd
archive/probe_v1r1.scad
cad/freecad/rotor.fcstd
cad/parts/rotor.stl
cad/parts/rotor_edit.stl
