filippvizvary/sub-mission/docs/PRINT_GUIDE.txt

sub-mission v1 - parts ready to print
=====================================
Generated from cad/probe_cq.py by tools/export_print_stls.py.
Every STL is watertight, oriented on the build plate (z=0), part axis = Z,
centred on the SHAFT axis (not the bbox centre). Units mm.
This file is copied into print/README.txt on every export.

Files
-----
01_rotor_vrtula.stl                1x   147.1 cm3   170.3 x  194.6 x   68.0
02_barel_pod.stl                   1x   412.1 cm3   136.0 x  140.0 x  134.0
03_pohar.stl                       2x    15.7 cm3    70.0 x   70.0 x    5.7
05_nosic_hriadela_klietka.stl (1x iglidur)      1x    29.4 cm3    95.0 x   94.0 x   24.0
06_podlozka_pohara.stl             1x     0.4 cm3    24.0 x   24.0 x    1.0
07_upinac_vrtule_polovica.stl      2x     6.5 cm3    44.0 x   22.0 x   22.0
08_upinac_pohara_polovica.stl      4x     4.5 cm3    44.0 x   22.0 x   12.3
09_motorova_doska.stl              1x     7.2 cm3    44.0 x   44.0 x    5.5
10_oldham_hub_hriadel.stl          1x     4.6 cm3    28.0 x   28.0 x    8.0
11_oldham_kotuc.stl                1x     2.1 cm3    26.0 x   26.0 x    7.0
12_oldham_hub_zvonec.stl           1x     2.5 cm3    26.0 x   26.0 x    5.5
13_ram_vnutri.stl                  1x   149.0 cm3   136.0 x  136.0 x  105.7
14_kryt_pohara.stl                 2x     8.0 cm3    70.0 x   70.0 x    3.0

832 cm3 total at those quantities.

Orientation (already applied, do not rotate)
---------------------------------------------
01 rotor      flat aft face of the hub on the plate, nose cone UP.
              Tree support ONLY under the blades, never inside the cone.
02 barrel     bulkhead on the plate, O-ring groove up on a smooth layer,
              mount pad to one side. Nothing inside needs support.
03 cup        MAGNET FACE DOWN, twice. The 0.45 mm membrane (3 layers at 0.15)
              is then printed straight onto the plate - solid and flat, no
              bridging. Do not thicken it: every extra layer per side adds
              0.15 mm of magnet gap and costs ~3 % of coupling torque.
14 cover      flat, spigot up.
07/08 clamps  lay flat on the flange, split face vertical.
05 spider     Ø18 boss face on the plate, spokes and ring up; support under
              the spokes.
13 frame      plate face down (the 6x M4 side), bearing boss up at 105 mm.
              Tree support under the long arms.

Slicer
------
material   ABS (ASA only helps with UV, irrelevant underwater)
nozzle     255-265 C, bed 100-110 C, enclosure closed, fan 0-20 %
layer      0.2 mm (rotor 0.15; cup membrane must land on 0.15)
perimeters 4 (rotor 5, barrel bulkhead 5)
infill     25 % gyroid; rotor hub 40 %; the barrel's 4 mm bulkhead 100 %
blades     20 % of chord thickness. At 12 % the tip bent 44 mm at full flow;
           20 % gives 9.3 mm and 7.1 MPa root stress.
after      acetone vapour smooths ABS - outside of 02 only, 20 min, mask the
           O-ring groove. Inside gets epoxy (J03) as a barrier.

What actually has to fit (the numbers check_fits.py asserts)
-------------------------------------------------------------
rotor        Ø5.2 clearance bore in the hub, FOUR M3 holes at r 18.5
             (45/135/225/315), 6 mm deep, tapped. No boss, no heat insert -
             the boss is gone, the clamp is a separate part (07).
shaft        PLAIN ROUND Ø5 h9 x 78. Nothing to file. The flat is gone.
cup          Ø70 x 5.65, pockets 5.2 from the BACK, 0.45 membrane,
             Ø6 bore, Ø30 x 1 recess, four M3 x 5.5 at r 18.5.
clamps       bore Ø4.90 = 0.10 mm UNDER the shaft, so closing the split
             squeezes the shaft instead of just closing the faces.
             Flange 7 mm thick (not 5): an M3 head is Ø6.2 and needs 6.2 mm of
             material, which is why the 5 mm version had its pockets cut open.
             4x M3 x 16 through the flange (+ cover 14 on the cup) into the cup
             or hub; 2x M3 x 25 across the split at x +-6, head pocket and nut
             on the flange's outer edge where the surface is nearly flat.
magnet gap   5.20 mm = 0.45 membrane + 4.00 bulkhead + 0.45 membrane
             + 0.30 running clearance on the dry side.
motor        GB2208: 4x M3 on 16 x 19, 4x M2 on a 9 mm square, threads only
             2.5 mm deep. That is why plate 09 is 5.5 mm and cover 14 is 5.5.

Magnets (24 total, 12 per cup)
------------------------------
Epoxy West 105 + 206 (J03) at 22 C: pot life 20-25 min, gel 2-3 h, handling
10-15 h, full 5-7 days. Below 15 C it barely cures.
 - mix in batches of 3-4, not all 12; thicker layers cure faster
 - thicken with colloidal silica or it runs out of a vertical pocket
 - magnet sits 0.2 mm off the back face; wipe the excess before it gels
 - polarity: hold both cups face to face and drop the magnets into the second
   one - the wrong orientation pushes itself out. Then glue.
 - cover 14 closes the pockets and the clamp's four M3 x 12 pass through it,
   so retention does not depend on the glue at all

Assembly, wet side (front to back)
----------------------------------
 1. press the two iglidur bushings into the spider's Ø7 seats
 2. bolt the spider to the barrel's wet face, 4x M4 x 12
 3. rotor clamp halves around the shaft at 25..47, rotor on top, 4x M3 x 12
 4. slide shaft + rotor in from the front until the clamp butts the first
    bushing at 47
 5. wet cup (magnets in), cover 14, cup clamp halves, 4x M3 x 12 through
    the clamp and the cover into the cup; the sleeve end reaches 61
 6. thrust washer 06 into the bulkhead's recess, greased with Molykote 111

Assembly, dry side (back to front)
----------------------------------
 7. dry cup + cover + clamp on the dry shaft, clamp end at 93
 8. dry shaft through the frame's bearing boss, 695ZZ already pressed in
 9. hub A on the shaft end, disc, hub B on the motor's bell (4x M2)
10. motor bolted to plate 09 (4x M3 x 8), plate onto the frame (4x M3 x 12)
11. frame slides into the barrel, 6x M4 through its plate into the barrel's
    flange nut pockets; the O-ring sits in the groove
12. stuff the electronics box through the Ø94 opening, cables out through
    the two Ø8 glands at r 30

Print order, 13.11.2026 (deadline Saturday evening)
---------------------------------------------------
02 barel   0.3 mm / 3 perimeters / 0.55 width / 10 % gyroid / supports from
           build plate only / brim 8 / multiplier 0.95 (net 0.90). ~15 h.
           It stands on four Ø11 pads (255 mm2): the supports are MANDATORY,
           otherwise the 105 mm bulkhead disc is printed 10 mm in mid-air.
           The flange has a 52 deg conical skirt, so its 13 mm overhang needs
           no support and no 114 mm columns around the barrel.
01 rotor   as sliced: 0.15 / 5 perimeters / supports. 12 h 22 m.
13 frame   0.3 mm / 3 perimeters / 10 % / no supports. ~5.5 h.
05 spider  0.2 / 4 perimeters / 15 % / supports from build plate. ~2 h.
           Flipped: it stands on the ring (1512 mm2), boss up.
06 washer  4 min, can go anywhere.

Order: 02 -> 01 -> 13 -> 05. The rotor goes second so that a failure still
leaves Saturday day for one retry; 13 and 05 are short and can be squeezed
in at the end. Total ~35 h against a ~36 h window - no slack.
