filippvizvary/sub-mission/firmware/sender/src/main.cpp

#include <Arduino.h>
#include <WiFi.h>
#include <esp_now.h>
#include <esp_system.h>
#include <esp_wifi.h>
#include <math.h>

namespace {

constexpr uint32_t kBaudRate = 115200;
constexpr uint8_t kPacketVersion = 2;
constexpr uint32_t kSendIntervalMs = 2000;
constexpr uint8_t kEspNowChannel = 1;

constexpr uint8_t kTempPin = 34;
constexpr uint8_t kPhPin = 35;
constexpr uint8_t kTdsPin = 32;
constexpr uint8_t kTurbidityPin = 33;
constexpr uint8_t kFlowPin = 27;

constexpr float kSeriesResistor = 10000.0f;
// The NTC divider is fed from the devkit's 3V3 rail, which is NOT exactly 3.3 V.
// One-point calibrated against a thermometer reading of 21.0 C on 2026-10-15:
// with analogReadMilliVolts() the pin sits at 1.5493 V at 21.0 C, which only
// resolves to 21.0 C if the divider's supply is 3.40 V. Confirm by metering 3V3.
constexpr float kNtcSupplyVolts = 3.40f;
constexpr float kNominalResistance = 10000.0f;
constexpr float kNominalTempC = 25.0f;
constexpr float kBCoefficient = 3950.0f;
constexpr float kAdcMax = 4095.0f;
constexpr float kVcc = 3.3f;
// YF-style flow sensors are commonly calibrated as frequency / 6.5 ~= L/min.
constexpr float kFlowCalibrationFactor = 6.5f;
constexpr float kPhCalibrationSlope = -5.48f;
// Fitted so a stock PH-4502C trimmed to 2.50 V at pH 7 reads 7: (7 - 20.70) / -5.48 = 2.50 V.
constexpr float kPhCalibrationOffset = 20.70f;
// The electrode's volts-per-pH scales with absolute temperature; the fit is at 25 C.
constexpr float kPhCalibrationTempC = 25.0f;
constexpr float kPhNeutralPh = 7.0f;
// Outside this span the number cannot be a pH measurement at all, so report
// nothing rather than clamping it to a confident-looking 0.00 or 14.00.
// Trim-independent, unlike a fixed voltage threshold.
constexpr float kPhPlausibleMin = -1.0f;
constexpr float kPhPlausibleMax = 15.0f;
// DFRobot turbidity module outputs 0-4.5 V; a 2:1 divider protects the 3.3 V ADC.
constexpr float kTurbidityDividerRatio = 2.0f;
// Turbidity is reported as the PERCENTAGE of the clear-water signal that is gone.
// DFRobot's published NTU curve is a quadratic with its vertex at 2.563 V, so it
// runs backwards below that point: near the vertex a whisker of voltage flipped
// the reading between 500, 0 and 850 while the light was dropping monotonically.
// This module also sits ~19 % off their reference transfer, so an absolute NTU
// figure is indefensible. Signal loss is monotonic by construction and cannot
// fold. Baseline is the module's own clear-water output, measured 2026-10-16 in
// tap water at 3.455 V (pin 1.727 V), reproducible to 0.06 % across re-readings.
// Re-measure and update if the optics, LED or head change.
constexpr float kTurbidityClearVolts = 3.455f;
// TDS boards specify 2 %/C, referenced to 25 C.
constexpr float kTdsTempCoefficient = 0.02f;
constexpr float kTdsReferenceTempC = 25.0f;
constexpr float kPhMin = 0.0f;
constexpr float kPhMax = 14.0f;
constexpr float kTdsMin = 0.0f;
constexpr float kTdsMax = 2000.0f;
constexpr float kTurbidityMin = 0.0f;
constexpr float kTurbidityMax = 100.0f;

// Receiver MAC, read off receiver_ready on 2026-10-15.
// Previous value was E4:65:B8:7A:7C:68 - a different board, same Espressif OUI.
constexpr uint8_t kReceiverMac[6] = {0xE4, 0x65, 0xB8, 0x7A, 0x92, 0xB4};

struct __attribute__((packed)) TelemetryPacket {
  uint8_t version;
  uint32_t sequence;
  float temperature;
  float ph;
  float flow;
  float turbidity;
  float tds;
  uint32_t senderUptimeMs;
  uint16_t tempAdc;
  uint16_t phAdc;
  uint16_t tdsAdc;
  uint16_t turbidityAdc;
  float tempVoltage;
  float phVoltage;
  float tdsVoltage;
  float turbidityVoltage;
  uint32_t flowPulseCount;
  uint32_t flowWindowMs;
};

// Keep sender and receiver packet layouts byte-for-byte identical.
static_assert(sizeof(TelemetryPacket) == 61,
              "TelemetryPacket size mismatch between sender and receiver");

struct AnalogReading {
  uint16_t adc;
  float voltage;
};

struct TemperatureReading {
  float celsius;
  AnalogReading raw;
};

struct PhReading {
  float ph;
  AnalogReading raw;
};

struct TdsReading {
  float ppm;
  AnalogReading raw;
};

struct TurbidityReading {
  float lossPercent;
  AnalogReading raw;
};

struct FlowReading {
  float litersPerMinute;
  uint32_t pulseCount;
  uint32_t windowMs;
};

struct SensorReadings {
  TemperatureReading temperature;
  PhReading ph;
  TdsReading tds;
  TurbidityReading turbidity;
  FlowReading flow;
};

uint32_t g_sequence = 0;
uint32_t g_lastSendMs = 0;
volatile uint32_t g_flowPulseCount = 0;
uint32_t g_lastFlowSampleMs = 0;
float g_flowRate = 0.0f;
uint32_t g_lastFlowWindowPulseCount = 0;
uint32_t g_lastFlowWindowMs = 0;

void IRAM_ATTR onFlowPulse() {
  g_flowPulseCount++;
}

AnalogReading readAnalogPin(uint8_t pin) {
  const uint16_t adc = static_cast<uint16_t>(analogRead(pin));
  // analogReadMilliVolts() applies the chip's eFuse Vref calibration. The naive
  // adc * kVcc / kAdcMax assumed a 3.3 V full-scale, which measured ~7.5 % low on
  // this board against a multimeter - worth about -3 C on the NTC.
  const float voltage = static_cast<float>(analogReadMilliVolts(pin)) / 1000.0f;
  return {adc, voltage};
}

TemperatureReading readTemperatureC() {
  const AnalogReading raw = readAnalogPin(kTempPin);
  const float voltage = raw.voltage;

  if (voltage <= 0.0f || voltage >= kNtcSupplyVolts) {
    return {NAN, raw};
  }

  const float resistance = kSeriesResistor * (kNtcSupplyVolts / voltage - 1.0f);
  float temp = resistance / kNominalResistance;
  temp = log(temp);
  temp /= kBCoefficient;
  temp += 1.0f / (kNominalTempC + 273.15f);
  temp = 1.0f / temp;
  return {temp - 273.15f, raw};
}

PhReading readPh(float temperatureC) {
  const AnalogReading raw = readAnalogPin(kPhPin);

  // Correct the electrode voltage back to its 25 C equivalent, then apply the
  // 25 C fit. Electrode sensitivity is proportional to absolute temperature.
  const float neutralVoltage =
      (kPhNeutralPh - kPhCalibrationOffset) / kPhCalibrationSlope;
  float voltage25 = raw.voltage;
  if (isfinite(temperatureC)) {
    const float tempFactor =
        (temperatureC + 273.15f) / (kPhCalibrationTempC + 273.15f);
    voltage25 = neutralVoltage + (raw.voltage - neutralVoltage) / tempFactor;
  }

  const float calibratedPh =
      kPhCalibrationSlope * voltage25 + kPhCalibrationOffset;

  // Judged on the value, not on the raw ADC count: a disconnected or unpowered
  // module lands far outside pH 0-14, which is a broken chain rather than a
  // measurement. The dashboard renders NAN as "-".
  if (calibratedPh < kPhPlausibleMin || calibratedPh > kPhPlausibleMax) {
    return {NAN, raw};
  }

  const float clampedPh =
      calibratedPh < kPhMin ? kPhMin
                            : (calibratedPh > kPhMax ? kPhMax : calibratedPh);
  return {clampedPh, raw};
}

TdsReading readTds(float temperatureC) {
  const AnalogReading raw = readAnalogPin(kTdsPin);
  const float voltage = raw.voltage;
  float ppm =
      (133.42f * voltage * voltage * voltage - 255.86f * voltage * voltage +
       857.39f * voltage) *
      0.5f;

  // Conductivity rises with temperature; normalise to 25 C.
  // NOTE: 0 V is a legitimate TDS reading (dry probe in air), so unlike pH there
  // is no rail check here - a disconnected input is indistinguishable from clean
  // water on this channel, which is a real limitation worth stating out loud.
  if (isfinite(temperatureC)) {
    ppm /= 1.0f + kTdsTempCoefficient * (temperatureC - kTdsReferenceTempC);
  }

  const float clampedPpm = ppm < kTdsMin ? kTdsMin : (ppm > kTdsMax ? kTdsMax : ppm);
  return {clampedPpm, raw};
}

TurbidityReading readTurbidity() {
  const AnalogReading raw = readAnalogPin(kTurbidityPin);

  // A pin at the HIGH rail cannot come from the module through a working 2:1
  // divider - that needs 6.6 V - so it means the divider is not dividing.
  // A pin at the LOW end is a real reading: almost no light is reaching the
  // detector, which is the top of the turbidity range, not a fault.
  if (raw.adc >= static_cast<uint16_t>(kAdcMax)) {
    return {NAN, raw};
  }

  // Undo the 2:1 divider so this is the module's own output voltage.
  const float sensorVoltage = raw.voltage * kTurbidityDividerRatio;
  const float lossPercent =
      100.0f * (kTurbidityClearVolts - sensorVoltage) / kTurbidityClearVolts;
  const float clampedPercent =
      lossPercent < kTurbidityMin ? kTurbidityMin
                                  : (lossPercent > kTurbidityMax ? kTurbidityMax
                                                                 : lossPercent);
  return {clampedPercent, raw};
}

FlowReading updateAndReadFlowRate() {
  const uint32_t now = millis();
  if (g_lastFlowSampleMs == 0) {
    g_lastFlowSampleMs = now;
    return {g_flowRate, g_lastFlowWindowPulseCount, g_lastFlowWindowMs};
  }

  const uint32_t elapsed = now - g_lastFlowSampleMs;
  if (elapsed < kSendIntervalMs) {
    return {g_flowRate, g_lastFlowWindowPulseCount, g_lastFlowWindowMs};
  }

  noInterrupts();
  const uint32_t pulseCount = g_flowPulseCount;
  g_flowPulseCount = 0;
  interrupts();

  g_lastFlowWindowPulseCount = pulseCount;
  g_lastFlowWindowMs = elapsed;
  g_flowRate = ((1000.0f / static_cast<float>(elapsed)) *
                static_cast<float>(pulseCount)) /
               kFlowCalibrationFactor;
  g_lastFlowSampleMs = now;
  return {g_flowRate, g_lastFlowWindowPulseCount, g_lastFlowWindowMs};
}

// Runs in the WiFi task, NOT the Arduino loop. It must not touch Serial:
// printing from here interleaves with the packet line and corrupts the NDJSON.
// Record the outcome and let loop() emit it.
volatile uint32_t g_sendResultSequence = 0;
volatile bool g_sendResultOk = false;
volatile bool g_sendResultPending = false;

void onDataSent(const uint8_t *macAddr, esp_now_send_status_t status) {
  if (macAddr == nullptr) {
    return;
  }

  g_sendResultSequence = g_sequence;
  g_sendResultOk = (status == ESP_NOW_SEND_SUCCESS);
  g_sendResultPending = true;
}

bool initEspNowSender() {
  WiFi.mode(WIFI_STA);
  WiFi.disconnect();

  if (esp_wifi_set_channel(kEspNowChannel, WIFI_SECOND_CHAN_NONE) != ESP_OK) {
    Serial.println("{\"type\":\"error\",\"message\":\"esp_wifi_set_channel_failed\"}");
    return false;
  }

  if (esp_now_init() != ESP_OK) {
    Serial.println("{\"type\":\"error\",\"message\":\"esp_now_init_failed\"}");
    return false;
  }

  esp_now_register_send_cb(onDataSent);

  Serial.printf(
      "{\"type\":\"sender_peer_target\",\"receiverMac\":\"%02X:%02X:%02X:%02X:%02X:%02X\"}\n",
      kReceiverMac[0], kReceiverMac[1], kReceiverMac[2], kReceiverMac[3],
      kReceiverMac[4], kReceiverMac[5]);

  esp_now_peer_info_t peerInfo{};
  memcpy(peerInfo.peer_addr, kReceiverMac, sizeof(kReceiverMac));
  peerInfo.channel = kEspNowChannel;
  peerInfo.encrypt = false;

  if (esp_now_add_peer(&peerInfo) != ESP_OK) {
    Serial.println("{\"type\":\"error\",\"message\":\"esp_now_add_peer_failed\"}");
    return false;
  }

  Serial.println("{\"type\":\"sender_peer_added\",\"status\":\"ok\"}");

  return true;
}

SensorReadings readSensors() {
  SensorReadings readings{};
  readings.temperature = readTemperatureC();
  const float temperatureC = readings.temperature.celsius;
  readings.ph = readPh(temperatureC);
  readings.flow = updateAndReadFlowRate();
  readings.turbidity = readTurbidity();
  readings.tds = readTds(temperatureC);

  if (!isfinite(readings.temperature.celsius)) {
    Serial.printf(
        "{\"type\":\"error\",\"message\":\"temperature_sensor_fault\",\"tempAdc\":%u,\"tempVoltage\":%.3f}\n",
        static_cast<unsigned int>(readings.temperature.raw.adc),
        readings.temperature.raw.voltage);
  }

  if (readings.ph.raw.adc == 0 || readings.ph.raw.adc >= static_cast<uint16_t>(kAdcMax)) {
    Serial.printf(
        "{\"type\":\"warn\",\"message\":\"ph_signal_rail\",\"phAdc\":%u,\"phVoltage\":%.3f}\n",
        static_cast<unsigned int>(readings.ph.raw.adc), readings.ph.raw.voltage);
  }

  return readings;
}

TelemetryPacket buildSensorPacket(const SensorReadings &readings) {
  TelemetryPacket packet{};
  packet.version = kPacketVersion;
  packet.sequence = ++g_sequence;
  packet.temperature = readings.temperature.celsius;
  packet.ph = readings.ph.ph;
  packet.flow = readings.flow.litersPerMinute;
  packet.turbidity = readings.turbidity.lossPercent;
  packet.tds = readings.tds.ppm;
  packet.senderUptimeMs = millis();
  packet.tempAdc = readings.temperature.raw.adc;
  packet.phAdc = readings.ph.raw.adc;
  packet.tdsAdc = readings.tds.raw.adc;
  packet.turbidityAdc = readings.turbidity.raw.adc;
  packet.tempVoltage = readings.temperature.raw.voltage;
  packet.phVoltage = readings.ph.raw.voltage;
  packet.tdsVoltage = readings.tds.raw.voltage;
  packet.turbidityVoltage = readings.turbidity.raw.voltage;
  packet.flowPulseCount = readings.flow.pulseCount;
  packet.flowWindowMs = readings.flow.windowMs;
  return packet;
}

void formatJsonFloat(char *out, size_t outSize, float value) {
  if (isfinite(value)) {
    snprintf(out, outSize, "%.3f", value);
  } else {
    snprintf(out, outSize, "null");
  }
}

void sendTelemetry() {
  const SensorReadings readings = readSensors();
  const TelemetryPacket packet = buildSensorPacket(readings);
  const esp_err_t sendResult =
      esp_now_send(kReceiverMac, reinterpret_cast<const uint8_t *>(&packet),
                   sizeof(packet));

  if (sendResult != ESP_OK) {
    Serial.printf(
        "{\"type\":\"error\",\"message\":\"esp_now_send_failed\",\"code\":%d}\n",
        static_cast<int>(sendResult));
    return;
  }

  // Built into one buffer and written once. Ten separate Serial.print calls
  // let a concurrent writer land in the middle of the line.
  char line[256];
  char t[16];
  char ph[16];
  char fl[16];
  char tu[16];
  char td[16];
  formatJsonFloat(t, sizeof(t), packet.temperature);
  formatJsonFloat(ph, sizeof(ph), packet.ph);
  formatJsonFloat(fl, sizeof(fl), packet.flow);
  formatJsonFloat(tu, sizeof(tu), packet.turbidity);
  formatJsonFloat(td, sizeof(td), packet.tds);

  snprintf(line, sizeof(line),
           "{\"type\":\"sender_packet\",\"sequence\":%lu,\"temperature\":%s,"
           "\"ph\":%s,\"flow\":%s,\"turbidity\":%s,\"tds\":%s,"
           "\"ph_adc\":%u,\"ph_v\":%.3f}",
           static_cast<unsigned long>(packet.sequence), t, ph, fl, tu, td,
           static_cast<unsigned int>(packet.phAdc), packet.phVoltage);
  Serial.println(line);
}

}  // namespace

void setup() {
  Serial.begin(kBaudRate);

  uint32_t waitStart = millis();
  while (!Serial && (millis() - waitStart) < 1500) {
    delay(10);
  }

  pinMode(kFlowPin, INPUT_PULLUP);
  attachInterrupt(digitalPinToInterrupt(kFlowPin), onFlowPulse, RISING);

  if (!initEspNowSender()) {
    return;
  }

  Serial.println("{\"type\":\"sender_ready\",\"packetVersion\":2,\"intervalMs\":2000}");
}

void loop() {
  // All Serial output happens here, in one context.
  if (g_sendResultPending) {
    g_sendResultPending = false;
    Serial.printf("{\"type\":\"sender_send\",\"sequence\":%lu,\"status\":\"%s\"}\n",
                  static_cast<unsigned long>(g_sendResultSequence),
                  g_sendResultOk ? "ok" : "fail");
  }

  const uint32_t now = millis();
  if (now - g_lastSendMs >= kSendIntervalMs) {
    sendTelemetry();
    g_lastSendMs = now;
  }

  delay(5);
}
