filippvizvary/sub-mission/tools/export_print_stls.py

#!/usr/bin/env python3
"""Export the print-ready parts from the assembly into print/.

cad/probe_cq.py exports every part in the ASSEMBLY frame (rotated 90 deg about Y
then Z, translated to the arm tip), which no slicer wants: the part arrives
1.2 m off the origin with its axis along Y. This script undoes that transform,
optionally flips a part so its print face is down, then stands it on z=0 and
centres it on the SHAFT AXIS (not on the bounding-box centre - a three-blade
rotor's bbox centre sits well off the axis, and centring on it puts the bore
eccentric on the plate).

    python3 tools/export_print_stls.py

Run it after every rebuild of cad/probe_cq.py. It refuses to export a part that
is not watertight, and it prints volume + footprint so the slicer numbers can
be sanity-checked against the model.
"""
import os
import sys

import numpy as np
import trimesh

ROOT = os.path.dirname(os.path.dirname(os.path.abspath(__file__)))
CQ = os.path.join(ROOT, "cad", "cq")
OUT = os.path.join(ROOT, "print")

# assembly placement applied in probe_cq.py
T = np.array([1200.0, -142.0, -420.0])


def _ry(a):
    c, s = np.cos(a), np.sin(a)
    return np.array([[c, 0, s], [0, 1, 0], [-s, 0, c]])


def _rz(a):
    c, s = np.cos(a), np.sin(a)
    return np.array([[c, -s, 0], [s, c, 0], [0, 0, 1]])


BACK = _ry(-np.pi / 2) @ _rz(-np.pi / 2)

# source part -> (file name, flip 180 deg about X so the print face is down)
PARTS = [
    ("rotor", "01_rotor_vrtula.stl", True),          # aft face down, cone up
    ("pod", "02_barel_pod.stl", False),              # bulkhead down, O-ring up
    # ONE cup part. The wet and the dry cup are the same solid - same volume, same
    # bounds - so there is no second file to keep in sync. Print it twice, both times
    # magnet face DOWN so the 0.45 membrane lands on the build plate.
    ("magcup_wet", "03_pohar.stl", True),
    # flipped: ears + ring on the bed (Ø96 ring = 7000 mm2 of footprint) instead of
    # standing on the Ø18 boss with three arms overhanging 46 mm in mid-air.
    ("wet_carrier", "05_nosic_hriadela_klietka.stl", True),  # ring down, boss up
    ("cup_washer", "06_podlozka_pohara.stl", False),         # flat ring, print flat
    # the clamp is one geometry in two versions, because the two halves do different
    # jobs: 07a has ROUND Ø6.4 x 2.2 pockets for the screw heads, 07b has HEX 5.8 AF x
    # 2.6 pockets for the nuts. Three clamps in the pod, so print 3 of each.
    ("rotor_clamp", "07a_upinac_hlava.stl", True),
    ("cup_clamp_wet", "07b_upinac_matica.stl", True),
    ("cup_cover_wet", "14_kryt_pohara.stl", True),   # print 2: one per cup
    ("motor_plate", "09_motorova_doska.stl", True),           # print 1: test the pattern
    ("oldham_hub_a", "10_oldham_hub_hriadel.stl", False),
    ("oldham_disc", "11_oldham_kotuc.stl", False),
    ("oldham_hub_b", "12_oldham_hub_zvonec.stl", True),
    ("engine_block", "13_ram_vnutri.stl", False),   # print plate down, 105 is the top
]


# Orientation note for the cups: they are printed MAGNET FACE DOWN. That puts the
# face that has to be flat and hold the 0.2 mm magnet recess on the build plate,
# and it turns the boss/body junction from a 64 mm overhang into a simple step up
# from the plate. Printed face up, the body's whole underside starts on a Ø14
# column, which is the "drží to na jednej vrstve" Filip saw.


def drop_junk(m, src):
    """OCC occasionally leaves a ZERO-VOLUME sliver component behind a union (the
    rotor: 2 non-manifold edges at r 56, 0.00 cm3). Drop components that carry no
    volume and refuse anything that carries some - a real second body means the
    part is two parts."""
    comps = m.split(only_watertight=False)
    if len(comps) == 1:
        return m
    keep = max(comps, key=lambda c: abs(c.volume))
    dropped = [c for c in comps if c is not keep]
    junk = [c for c in dropped if abs(c.volume) > 0.01]
    if junk:
        raise SystemExit(f"{src}: {len(junk)} extra body/bodies with real volume - not one part")
    print(f"  {src}: dropped {len(dropped)} zero-volume sliver(s) from the union")
    return keep


def export():
    os.makedirs(OUT, exist_ok=True)
    bad = []
    for src, dst, flip in PARTS:
        m = trimesh.load(os.path.join(CQ, src + ".stl"))
        m = drop_junk(m, src)
        m.vertices = (m.vertices - T) @ BACK.T
        if flip:
            m.apply_transform(trimesh.transformations.rotation_matrix(np.pi, [1, 0, 0]))
        m.apply_translation([0, 0, -m.bounds[0][2]])
        v = m.vertices
        bed = v[np.abs(v[:, 2]) < 0.05]
        if len(bed) < 3:
            raise SystemExit(f"{src}: nothing lies on z=0, cannot orient it")
        axis_x, axis_y = bed[:, 0].mean(), bed[:, 1].mean()
        m.apply_translation([-axis_x, -axis_y, 0])
        if not m.is_watertight:
            bad.append(src)
        m.export(os.path.join(OUT, dst))
        b = m.bounds
        print(f"{dst:34s} {abs(m.volume)/1000:7.1f} cm3  "
              f"{b[1][0]-b[0][0]:6.1f} x {b[1][1]-b[0][1]:6.1f} x {b[1][2]-b[0][2]:6.1f}")
    guide = os.path.join(ROOT, "docs", "PRINT_GUIDE.txt")
    if os.path.exists(guide):
        import shutil
        shutil.copyfile(guide, os.path.join(OUT, "README.txt"))
        print("README.txt <- docs/PRINT_GUIDE.txt")
    if bad:
        sys.exit("NOT watertight, not printable: " + ", ".join(bad))


if __name__ == "__main__":
    export()
