filippvizvary/sub-mission/(commit log)

2026-04-15 Enhance documentation, improve error handling, and refine calibration processes
    - Updated README with detailed architecture and prerequisites.
    - Revised CODE.md to clarify project state and protocol versioning.
    - Added error handling in main.cpp for packet validation and queue management.
    - Improved sender firmware with calibration constants for pH, TDS, and turbidity.
    - Streamlined web dashboard by removing unnecessary tabs and adding raw diagnostics.
    - Introduced calibration and flashing guides for better user onboarding.
    - Enhanced troubleshooting documentation for common issues and fixes.
    [main.cpp]
2026-10-15 fix: correct pH scaling, calibrate the analog chain, stop corrupting NDJSON
    Sender:
    - pH offset 14.67 -> 20.70, so a stock PH-4502C trimmed to 2.50 V at pH 7
    reads 7.00 instead of 0.97 (slope -5.48 was already correct)
    - read analog channels with analogReadMilliVolts() so the ESP32 eFuse Vref
    calibration is applied; adc * 3.3 / 4095 read ~7.5% low on this board
    - NTC divider supply is 3.40 V, not the assumed 3.30 V. One-point
    calibrated against a thermometer: error went 3.0 C -> 0.04 C
    - undo the 2:1 turbidity divider before applying the DFRobot curve, so
    clear water stops reading ~2765 NTU
    - temperature-compensate pH (electrode slope scales with absolute
    temperature) and TDS (2 %/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
    [main.cpp]
2026-10-15 feat(web): CSV export, packet-loss strip, surface faults, drop external fonts
    - Export CSV: records every telemetry sample (timestamp, all five channels,
    raw ADC and voltages) and downloads them, so a measurement series can be
    plotted instead of scrolling past in the log
    - persistent packet-loss strip fed by receiver_stats, with invalid, dropped
    and sequenceGaps highlighted when non-zero
    - handle {"type":"warn"} from the sender; it had no handler at all, so
    ph_signal_rail never reached the screen
    - log unrecognised message types, which is what picking the wrong serial
    port (the sender) looks like from the dashboard
    - remove the Google Fonts fetch so the page has no network dependen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
2026-10-15 feat(sender): report turbidity relative to a measured clear-water baseline
    Absolute NTU needs formazine or polymer standards, which we do not have, and
    this module sits about 19 percent below DFRobot's published transfer curve - the
    raw curve read around 2112 NTU in clear tap water, which is not a defensible
    figure to show.
    - anchor to a measured clear-water baseline: module output 3.455 V, measured
    2026-10-16 in tap water over 20 samples (spread 0.004 V)
    - clear water now reads about 0 and turbidity reads positive from there
    - dashboard unit label is now "NTU (relative)", so the UI does not claim an
    absolute measurement
    - useful span is roughly 0-800; past the curve vertex at module 2.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
2026-10-15 fix(sender): monotonic turbidity scale, report signal loss instead of folded NTU
    DFRobot's published curve is a quadratic whose vertex sits at 2.563 V, so below
    that point it runs backwards. Near the vertex a whisker of voltage flipped the
    reading between 500, 0 and 850 while the light was dropping monotonically, and
    the clamp at zero hid the entire negative half of the response - a real reaction
    to flour or milk displayed as exactly the same 0.00 as clear water.
    The module also sits about 19 percent below DFRobot's reference transfer, so an
    absolute NTU figure was never defensible on this board.
    - report the percentage of the clear-water signal that is gone: monotonic by
    construction, b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
    [main.cpp]
2026-10-18 design(v1): parametric CAD model + corrected energy sim + spec pack
    - cad/probe_v1r1.scad: full parametric model (bank pole, arm, mag-coupled wet pod,
    NACA4412 rotor with root-to-tip twist 28deg->2deg, sealed gen pod, flow-through
    sensor cage, weed guard, deck box + antenna)
    - sim/simulate_v3.py: physics corrected after frontier review (cogging is cut-in
    only, rectifier eta vcap-dependent, generator max-power-transfer solved, no
    double-counting)
    - docs/DESIGN_V1.md: full v1 system spec with honesty ledger
    [coupling_detail.scad, naca4412.scad, probe.scad, probe_v1r1.scad]
2026-10-18 docs(v1): change log + frontier review outputs (fabrication, rotor sweep, field failure, sim review, round-1)
2026-10-18 docs(BOM): full v1 bill of materials
2026-10-18 docs: CAD tool decision + FreeCAD rotor scaffold (loft workaround pending)
    [rotor.fcstd, rotor.step]
2026-10-18 feat(cad): parametric probe build in CadQuery — watertight rotor, pod, cups, cage, site; assembly STEP for FreeCAD
    [cage.step, cage.stl, magcup_dry.step, magcup_dry.stl, magcup_wet.step, magcup_wet.stl, pod.step, pod.stl]
2026-10-19 feat(cad): correct pod placement at arm tip underwater + river scene renders (riverbank/isometric/pod detail)
    [cage.step, cage.stl, magcup_dry.step, magcup_dry.stl, magcup_wet.step, magcup_wet.stl, pod.step, pod.stl]
2026-10-19 docs: add Budca 2021 case study as design rationale — 'detect it sooner'
2026-10-19 docs: add v2a mill-wheel variant to roadmap (low-flow tributaries)
2026-10-19 docs(BOM): sourcing update — antennas, gimbal generators, gateway, LIC cap, verified SK/CZ listings; revised probe ~450 EUR
2026-10-19 docs(BOM): non-printables — magnets, igus bearings, 316L rod, all SK/CZ-verified
2026-10-19 docs: deployment sequence + flood survival — ground-screw receiver, guy lines, shear pin, storm mode
2026-10-19 feat(parts): authoritative parts list (80 lines, CSV+MD) + model completeness pass
    - docs/PARTS_LIST.csv/.md: every part with qty, source, price, status
    - cad: add wet bearing carrier + igus bushings, weed guard ring, real sensor
    bodies (pH/TDS/turbidity/NTC/MS5837), O-ring groove, cable gland boss,
    ground screw + receiver, guy lines, safety cable
    - all 24 parts verified watertight; 2 sphere degeneracies replaced
    [PARTS_LIST.csv, anchor.step, anchor.stl, cage.step, guys.step, guys.stl, magcup_dry.step, magcup_wet.step]
2026-10-19 fix(cad): pod axis along river flow, guy anchors onto bank, safety strap attached
    [anchor.step, anchor.stl, cage.step, cage.stl, guys.step, magcup_dry.step, magcup_dry.stl, magcup_wet.step]
2026-10-19 cad: native FreeCAD document of the full assembly
    [probe_assembly.FCStd]
2026-10-19 fix(cad): hollow drop tube for cable routing, clamp joint pod-to-tube, cage adapter cone, guys to real anchors
    [anchor.step, cage.step, cage.stl, cage_adapter.step, cage_adapter.stl, guys.step, guys.stl, magcup_dry.step]
2026-10-19 tools: live FreeCAD bridge (Web workbench socket) + one-click start macro
2026-10-19 fix(cad): remove stale nose bosses, explicit axial layout table (no gaps in pod chain)
    [anchor.step, cage.step, cage.stl, cage_adapter.step, cage_adapter.stl, guys.step, magcup_dry.step, magcup_dry.stl]
2026-10-19 cad: embed per-part colours in the assembly STEP so any import is readable
    [anchor.step, cage.step, cage_adapter.step, guys.step, magcup_dry.step, magcup_wet.step, pod.step, pod_seal.step]
2026-10-19 fix(cad): hang pod barrel under the drop tube — rotor was intersecting the clamp (102 cm3)
    [anchor.step, cage.step, cage.stl, cage_adapter.step, cage_adapter.stl, guys.step, magcup_dry.step, magcup_dry.stl]
2026-10-20 docs(sensors): measurement set decision — DO added as primary channel, MS5837 rejected (daily-dry spec), TDS accuracy caveat, level probe replaces it
    [PARTS_LIST.csv]
2026-10-20 docs: grouped parts list as styled xlsx (reuse/optional/install-type columns, per-category totals) + generator script
    [sub-mission_parts.xlsx]
2026-10-20 fix(parts): site items were double-counted (probe+site), pack prices were multiplied by piece count
    [PARTS_LIST.csv, sub-mission_parts.xlsx]
2026-10-20 fix(gateway): single-channel Wio-E5 gateway replaces RAK2287 mini-PCIe (which needs a Pi HAT); concentrator demoted to optional upgrade
    [PARTS_LIST.csv, sub-mission_parts.xlsx]
2026-10-20 docs: clarify Wio-E5 mini = STM32WLE5JC board (same SKU as gateway radio), buy 3
    [PARTS_LIST.csv, sub-mission_parts.xlsx]
2026-10-20 simplify: Wio-E5 mini as the single brain (MCU+LoRa) in probe and gateway; ESP32-S3 dropped
    [PARTS_LIST.csv, sub-mission_parts.xlsx]
2026-10-20 docs: build procedure with gates + order sheet by shop with spares; cad: collar clamp replaces block-through-wall, visible cable run
    [anchor.step, cable_run.step, cable_run.stl, cage.step, cage_adapter.step, guys.step, magcup_dry.step, magcup_wet.step]
2026-10-20 cad: detail pass - real generator body, DO probe, cage lengthened to fit, joint hardware at every junction; exploded elevations + coupling section
    [anchor.step, cable_run.step, cage.step, cage.stl, cage_adapter.step, generator.step, generator.stl, guys.step]
2026-10-20 rotor: correct the twist table (old one gave negative AoA at every station); BEM with Prandtl losses, Wilson optimal geometry; 3D web viewer with per-part materials and labels; individual magnets mod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
    [anchor.step, anchor.stl, cable_run.step, cable_run.stl, cage.step, cage.stl, cage_adapter.step, cage_adapter.stl]
2026-10-20 sim: pin rotor check to the model design point (TSR 5, alpha 5) and compare solidity
2026-10-20 coupling: computed slip torque from the magnets - 8x D8 at 7 mm gap gives 0.11 N.m, less than the 0.164 N.m load; upsized to 10x D10x5, cup D50, wall 4 mm -> 0.48 N.m (2.9x). LAN viewer
    [anchor.step, cable_run.step, cage.step, cage_adapter.step, generator.step, guys.step, joints.step, magcup_dry.step]
2026-10-20 cad: regenerate FreeCAD document from the new STEP (125 objects, current coupling geometry)
    [probe_assembly.FCStd]
2026-10-20 coupling: cup D70 with 8 magnets - pitch radius 28 mm, neighbour gap 11.4 mm, 0.60 N.m (3.6x); viewer gets an explode slider and magnets ride their cups; systemd unit keeps the LAN viewer alive
    [anchor.step, cable_run.step, cage.step, cage_adapter.step, generator.step, guys.step, joints.step, magcup_dry.step]
2026-10-20 coupling: cup was a hollow dish - magnet pockets were cut into empty space. Rebuilt as a solid disc with 8 blind pockets, shaft bore, magnets recessed 0.2 mm; real gap 4.2 mm -> 1.0 N.m (6.1x)
    [anchor.step, cable_run.step, cage.step, cage_adapter.step, generator.step, guys.step, joints.step, magcup_dry.step]
2026-10-20 repo: tidy - generated meshes and caches out of git, legacy SCAD/renders/FreeCAD tools to archive/, docs reorganised, firmware/ merged, README rewritten. cad: coupling wall is its own part, blade reb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
    [anchor.step, anchor.stl, cable_run.step, cable_run.stl, cage.step, cage.stl, cage_adapter.step, cage_adapter.stl]
2026-10-20 repo: drop stale render PNGs from cad/ (all of them predate the current geometry)
2026-10-20 drivetrain: wet assembly is now mechanically retained - static spider bolted to the pod face carries the shaft in two bushings between two collars; magnets transmit torque only. Weed-guard ring remov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
2026-10-26 bom: line up the parts list with the CAD, then cut it to a phase-1 order
    - B01 magnets were still D8x5 on a D48 cup; the model and clutch_check.py are
    N52 D10x5, 8 per cup on a D70 cup at pitch r=28. 16 pcs, price to re-verify.
    - B02 cup D48 -> D70, pockets D10.2x5.2 with a 0.2 mm epoxy recess.
    - B03 wall 5 mm -> 4 mm per CAD, and recommended as integral with the pod
    bulkhead, which deletes the O-ring and the clamp screws.
    - five dead lines marked cut: weed guard, blade lanyard, 316L carrier tube,
    ESP32-S3, RAK2287.
    - new phase column (1 = buy now, 2 = later, cut) and tools/build_order_v1.py,
    which writes the phase-1 sheet into the workbook grouped by shop.
    - phase 1: 43 lines, 425.1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
    [PARTS_LIST.csv, sub-mission_parts.xlsx]
2026-10-26 order sheet: make it a document, not a dump
    - 6 columns instead of 8 (spec and note merged), wrapped, auto row heights
    - shop bands carry their own subtotal on the right, alternating row shading
    - goods / shipping / landed block closes the list instead of floating under it
    - portrait A4, fit to one page wide, gridlines off
    - phase-2 and cut lines are listed after the totals, not mixed into the order
2026-10-26 add ods parts list
    [sub-mission_parts.ods]
2026-10-26 order: two radios, an owned column, and the ods as the working document
    - I01 (gateway Wio-E5) and a second G04 antenna move into phase 1: one radio in
    the probe and one on the Pi USB, otherwise the probe transmits to nothing.
    - new owned column in PARTS_LIST.csv; owned lines stay visible, green, at 0 EUR.
    J05 grease and J01 filament are owned (he prints ABS, not ASA).
    - G16 protection is NOT owned after all - fuse + SMBJ TVS + ESD array, 6 EUR.
    - build_order_v1 now sums qty_probe + qty_site + qty_gateway.
    - phase 1: 44 lines, 408.11 EUR goods, 433.11 landed.
    - docs/sub-mission_parts.ods regenerated from the xlsx: the ods is what we work in.
    [PARTS_LIST.csv, sub-mission_parts.ods, sub-mission_parts.xlsx]
2026-10-26 order: cut to a 30-minute water test in three shops
    The goal changed: one dry-day dunk, 30 minutes, then a look. That deletes most
    of the engineering that only pays off over a season.
    - probe runs from a USB power bank in the dry box, so the whole energy chain
    goes (supercap, boost, buck, rectifier, clamp, supervisor, load switches, PCB)
    - no generator: the pod carries a dummy mass, the cage carries the sensors
    - no level probe (110) and no TDS for a single 30-minute dip
    - sources collapsed to three online shops: TME, techfun.sk, magsy.sk. The gateway
    board and both antennas move to techfun (same Seeed board, no fourth postage).
    Local desiccant and the spring balance are town purchase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
    [PARTS_LIST.csv, sub-mission_parts.ods, sub-mission_parts.xlsx]
2026-10-26 order: put the back joint back in
    The pod still has an opening at the back where the cage adapter bolts on. An
    integral bulkhead only seals the front, so the O-ring and its clamp screws are
    part of the dunk test, not a later phase.
    phase 1: 33 lines, 234.61 EUR goods
    [PARTS_LIST.csv, sub-mission_parts.ods, sub-mission_parts.xlsx]
2026-10-26 sourcing: the Wio-E5 is not in any CZ/SK shop, and the antenna ships with the board
    - techfun returns zero products for wio-e5; laskakit carries RAK4630/4631, not
    Seeed. Verified by their own search pages, not assumed.
    - G03 and I01 therefore point at Seeed direct (24 EUR) or OpenELAB EU; both
    marked quote, not verified.
    - G04 and G05 drop out of the order: every Wio-E5 mini ships with an EU868
    antenna, and the board already has an SMA, so no pigtail unless the antenna
    is routed through a bulkhead.
    - phase 1: 31 lines, 234.61 EUR goods
    [PARTS_LIST.csv, sub-mission_parts.ods, sub-mission_parts.xlsx]
2026-10-26 sourcing: rpishop has the radio, so the boards stay in CZ
    Searched the three shops properly instead of assuming:
    - rpishop.cz stocks Seeed XIAO nRF52840 + Wio-SX1262 kits (SEE336, 349 Kc, 5+).
    That replaces the Wio-E5 mini, which no CZ/SK shop carries, and it is cheaper
    than importing one. G03 and I01 now point there.
    - techfun.sk: turbidity and DS18B20 confirmed in stock, and they do carry N52
    round magnets (size to check). No Wio-E5, no DP270, no West System.
    - laskakit.cz: RAK4630/4631 WisBlock + Meshtastic, no Seeed.
    - TME stays for the bushings, glands, box, cable, O-ring and fasteners: none of
    the three maker shops carry igus or submersible cable.
    phase 1: 31 lines, 214.61 EU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
    [PARTS_LIST.csv, sub-mission_parts.ods, sub-mission_parts.xlsx]
2026-10-26 order: every line carries its shop link
    - new link column in PARTS_LIST.csv, rendered as a hyperlink on the part name
    - direct product pages where I could verify one: rpishop XIAO+SX1262 kit,
    techfun turbidity/DS18B20/potting, TME igus bushings, supermagnete N52 D10x5
    - TME sits behind a Cloudflare challenge that blocks bots, so their lines carry
    a catalogue search link instead of a product URL. They open fine in a browser.
    - 18 of 31 phase-1 lines are linked; the rest are printed in-house or CAD items.
    [PARTS_LIST.csv, sub-mission_parts.ods, sub-mission_parts.xlsx]
2026-10-26 order: rpishop and supermagnete get their own bands
    rpishop.cz was not in the shop map, so both radio lines were falling through to
    'local / shop'; the magnets were labelled techfun because their source string
    still started with techfun.sk. Both fixed, and B01 now points at the verified
    supermagnete product page for the N52 D10x5.
    [PARTS_LIST.csv, sub-mission_parts.ods, sub-mission_parts.xlsx]
2026-10-26 order: the XIAO kit has a U.FL, not an SMA
    Checked the rpishop page: the kit lists a U.FL/IPEX connector and ships one small
    LoRa antenna. So the stub it comes with is a u.FL whip, and any bigger antenna
    needs a pigtail. G05 comes back as 2 pieces (one per board), 3 EUR each, so his
    own antennas can be used at both ends.
    phase 1: 32 lines, 220.61 EUR goods
    [PARTS_LIST.csv, sub-mission_parts.ods, sub-mission_parts.xlsx]
2026-10-26 order: back to the full build
    The 30-minute dip was my scope, not his: the generator, the cabling, the buck and
    the whole energy chain belong in the build. Restored to phase 1, together with
    the site structure and the gateway mast.
    Only three things stay out, each for a stated reason: the IP68 box on the bank
    (he does not need it), the gateway enclosure, and the two tools. The five dead
    lines stay cut.
    phase 1: 73 lines, 988.11 EUR goods
    [PARTS_LIST.csv, sub-mission_parts.ods, sub-mission_parts.xlsx]
2026-10-26 order: 436 EUR, everything the water still needs
    Cut 552 EUR out of the full build without touching anything that has to work
    underwater: the three optional sensors (DO 175, level 110, pH 69), the gateway
    antenna and mast (he has 868 antennas and a pigtail now), PC Blend, conformal
    coat, the O-ring assortment (the exact O-ring is already ordered), the sensor
    cable, the threadlocker he may have, the barometer, and the three site items
    that only matter at permanent deployment.
    Kept in full: rotor, coupling, pods, spider, bushings, generator, cabling,
    boost/buck/rectifier/supercap/supervisor/load switches, PCB, cage, temp +
    turbidity + TDS, the pole and arm, the gateway radio.
    56 lines, 436.1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
    [PARTS_LIST.csv, sub-mission_parts.ods, sub-mission_parts.xlsx]
2026-10-26 order: 402 EUR with the Pi taken off the list
    I02 was still priced at 70 even though the Raspberry Pi is already his, and that
    was the whole reason the earlier cut had to be so deep. Freeing it pays for the
    one thing that decides whether the data ever arrives: a 5 dBi whip and a 3 m
    mast on the gateway side.
    57 lines, 402.11 EUR goods, everything that touches the water still complete.
    [PARTS_LIST.csv, sub-mission_parts.ods, sub-mission_parts.xlsx]
2026-10-26 order: links on 41 of 57 lines
    Direct product pages where one exists (rpishop kit, x-teamrc 3506, techfun
    turbidity/DS18B20/potting, supermagnete N52, TME igus bushings). TME lines carry
    a catalogue search link because Cloudflare blocks automated access but a browser
    walks straight through. Hardware-store lines point at hornbach.sk, which also
    sits behind a bot check, so no per-item URL there.
    The 16 unlinked lines are printed parts, in-house CAD items, what he already owns,
    and three things with no shop (metal shop, site label, hinge collar pin).
    [PARTS_LIST.csv, sub-mission_parts.ods, sub-mission_parts.xlsx]
2026-11-10 cad: print-ready pod chain, six interferences gone
    Measured with OCC booleans over every pair, not by eye:
    - wet_carrier rebuilt as a cage. The flat spider put its three arms through
    the wet cup body (3963 mm3) - the cup could not turn. Longerons now run at
    r 42-48 and the spokes sit in the free band in front of the cup. 0 mm3.
    - nose cone merged into the rotor (44355 mm3 inside the hub, and every
    fastening option for it sat in the blade swept volume). No joint now.
    - spider boss gets a clear Ø5 bore; the old one was solid between the two
    bushings, so the shaft could not reach the second one (373 mm3).
    - collars replaced by the hub's aft face + a bought Ø5 shaft collar at 61-65,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
    [PARTS_LIST.csv]
2026-11-10 cad: the rotor was twice as long as the BOM said
    make_hub extruded with both=True, so the Ø64 hub came out 92 mm long instead of
    the 46 mm A02 specifies. That is 147 cm3 of plastic and 46 mm of axial envelope
    that nothing asked for: the rotor was 350 cm3 / 132 mm tall, now 203 cm3 / 86 mm.
    - hub 0..46, set-screw bores at 31 (15 mm from the aft face, as specified)
    - blades moved to the hub's mid-plane (+17.6 mm) instead of hanging off its
    front face
    - nose cone now spans 0..-40 from the hub's front face
    - shaft 78 mm (0..78), not 115: the longer one reached 37 mm into the nose cone
    and shared 275 mm3 with it. A03 updated to match.
    Rotor footprint is unchanged at 170 x 195 mm - that is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
    [PARTS_LIST.csv]
2026-11-10 cad: the blades were 4.5x too floppy, the hub screws could not reach the shaft
    Three faults found by measuring instead of looking:
    - Blade thickness. NACA 4412 at 12 % is a metal-blade number; on an 8.3 mm tip
    chord that is 1.0 mm of ABS. Bending the blade out of the rotor plane as a
    tapered cantilever (8 N of thrust per blade, distributed as annular area)
    gives 44 mm of tip sag - 57 % of the span. Now t/c 20 %: 9.3 mm at 1 m/s,
    3 mm at 0.5 m/s, tip 1.73 mm thick, root stress 7.1 MPa instead of 6.2.
    - Hub set screws. The wall between Ø64 hub OD and Ø5 shaft is 29.5 mm. A M4x8
    grub screw in a Ø4.4 bore bottoms 21 mm short of the shaft - the bore was
    just a hole. Now M4x30 sock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
    [PARTS_LIST.csv]
2026-11-10 cad: no hole through the shaft - one flat does all three jobs
    The Ø2 cross pin meant drilling Ø2 through a Ø5 316L bar: a drill walks on a
    round surface and a 1.5 mm pilot snaps in stainless, so that was a workshop
    operation the design did not actually need.
    The shaft now carries ONE flat, 0.5 mm deep and 3 mm wide, over z 16-76, and it
    drives three things at once: the hub's M4x30 tips land on it at r 2.0, the
    bought Ø5 collar grips it, and the cup's bore is a D-bore (Ø5.2 slip + the same
    flat at 0.05 mm clearance). Workshop step is a file, not a drill press: file
    until the caliper reads 4.50 mm across the flat.
    A12 (Ø2 dowel pin) is cut. check_fits grew to 39 assertions: the cup's f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
    [PARTS_LIST.csv, final-list.xlsx, finalny-zoznam-sk.xlsx]
2026-11-10 cad: the cup's D-bore never existed - two wrong booleans
    Filip caught it in the slicer: a 10 x 12 mm square hole through the magnet face.
    1. The cut box was 10 x 12 mm, so instead of chamfering the bore it gouged a
    slot right across the cup body. Shrinking it was not enough.
    2. A D-bore is a round hole with MATERIAL ADDED on one side where the flat is.
    The lens lies entirely inside the Ø5.2 bore, so subtracting it removes air:
    the first fix left a perfect circle and a flat that existed only in a
    comment. It has to be unioned.
    3. And the lens was 40 mm long, so unioning it left a Ø5.2 rod sticking 14 mm
    out of each face.
    Now: lens = bore cylinder (16 long, z -6..10) interse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
2026-11-10 cad: what actually carries the magnet pull - and it was missing
    Filip asked how the coupling holds when the magnets are "just loose in a hole".
    Answering it found a real gap: the wet cup's plastic face was sitting flat on the
    bulkhead's wet face. The magnets pull that cup downstream with ~56 N, so the
    load went straight through ABS rubbing on ABS at 0.73 m/s - grooving within
    hours, and the groove changes the magnet gap, which changes the slip torque.
    - 1 mm recess in the bulkhead's wet face (r 3..35) with a PTFE Ø68/Ø24 x 1 ring
    in it (B05). The washer takes 1 mm of wall and gives 1 mm of PTFE inside the
    same 4.4 mm window, so the magnetic gap does not move.
    - the 46..47 washer under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
    [PARTS_LIST.csv]
2026-11-10 cad: the thrust ring is printed, not bought
    No PTFE washer: B05 is now an ABS ring Ø24/Ø8 x 1 mm printed in-house, and it
    moved from r 12..34 to r 4..12. The position is the point - the same ring at the
    outer radius runs at 0.73 m/s over 2 300 mm2, at the inner radius it is 0.36 m/s
    over 402 mm2, i.e. 0.14 MPa and PV 0.05 MPa*m/s, which ABS in water handles. It
    is a consumable with a 4-minute reprint, and the print folder now carries it as
    06_podlozka_pohara.stl.
    46 checks, 0 failed.
    [PARTS_LIST.csv]
2026-11-10 cad: no screws and no bought collar in the drivetrain
    Two constraints from the build: the longest screw available is M4x20, and nothing
    else can be ordered.
    - hub: D-bore keyed on the same 0.5 mm flat as the cup, epoxied to the shaft.
    The flat carries the 0.164 N*m as a form fit (4.2 MPa in ABS); epoxy only has
    to hold 24 N axially, over a 46 mm bore. The two M4 inserts and their screws
    are gone - a screw could never cross the 29.5 mm wall from the Ø64 OD to the
    Ø5 shaft, and M4x30 was the part nobody had.
    - cup: boss grown from 6 to 10 mm so its upstream face butts the static spider
    boss at z 61. That traps the cup with no bought Ø5 collar: forward against the
    spider, aft ag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
    [PARTS_LIST.csv]
2026-11-10 cad: the clamp the hub needed, and no bearing in the bulkhead
    Filip's two observations set the shape:
    1. A Prusa GT2 pulley works because the screw is 5 mm from the shaft, not 32. So
    the hub grew a Ø16 x 14 clamp boss on its aft face: two M3 x 8 grub screws at
    90 and 270 deg (perpendicular to the flat, so the flat stays the key), holes
    printed Ø2.6 and tapped. No glue, nothing crosses the 29.5 mm hub wall, and it
    comes apart. Hub shortened 46 -> 28 mm - 24 was one millimetre too short and
    the blade roots poked through both faces (2 non-manifold edges at r 56).
    2. The dry bearing cannot live in the bulkhead. Any boss long enough to seat a
    695ZZ (13x5x4) pushes the dry cu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
    [export_print_stls.py]
2026-11-10 cad: one clamp was in the wrong place, and the pair was fighting itself
    Filip spotted only one screw hole on the rotor's underside. Two reasons:
    - the first hole was at z 27, which is still inside the Ø64 body - the boss only
    starts at 28. There the wall is 29.4 mm again and the screw reaches nothing.
    Both holes now sit in the boss, at z 32 and z 38.
    - the pair was at 90 and 270 deg, diametrically opposite: each one pushed the
    shaft away from the other, so neither held it on the flat. Now 180 deg (pushes
    the shaft across onto the flat: maximum form engagement) and 90 deg (locks
    rotation).
    No heat-set insert: the boss wall is 5.4 mm and an M3 insert needs ~6.6 mm. The
    hole is pri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
2026-11-10 cad: the barrel's lugs were inside the O-ring band
    Filip spotted it in the slicer. The six lugs sat at r 46..58 with their Ø4.5
    bolt holes at r 52.5 - straight through the groove's radial band (49.9..52.9) -
    so the seal would have run round a row of lugs instead of a flat face, and there
    was no pocket anywhere for a nut.
    Replaced with a continuous flange r 55..68, 6 mm thick: the whole sealing face
    stays flat, the groove keeps 1.9 mm of land inside and 2.1 mm outside, and the
    joint moves outboard of the seal. Six Ø4.5 holes on a r 61.5 bolt circle with a
    Ø7.5 head counterbore on the barrel side; the nuts go in the adapter, which is
    modelled with it (next block).
    Also: the wet cup gets o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
2026-11-10 cad: the spider's boss was hanging off a 1.5 mm ring
    Filip: "ten stred mi nepride uplne OK". Correct - the boss (Ø18, r 9) and the
    spokes could never meet radially, because the spokes need a Ø15 hole for the
    cup's Ø14 clamp boss. With the spokes at 61..69 the two only touched on a
    coplanar ring 1.5 mm wide at z 61, which is exactly the notch/float the slicer
    showed.
    Spokes moved to 59..67, so the boss (47..61) and the spokes now share 2 mm of
    real 3D overlap and the part fuses into one solid. Clearance to the cup's boss
    is still 0.5 mm at r 7 against r 7.5.
    42 checks, 0 failed.
2026-11-10 cad: the spider's inserts are blind, and the screw length matters more than the boss
    Filip asked whether bolting the wet carrier into the bulkhead breaks the water
    barrier, and whether outboard lugs would be safer. Measured: it does not break
    it. The four bosses are Ø11 stubs with Ø6.3 x 7 blind insert seats, so the seat
    bottoms 7 mm short of the dry face and a section anywhere inside the 4 mm wall
    (-4..0) is a clean disc of r 55 with no features at all. Now asserted, at three
    depths, so a future seat or hole that reaches through fails the audit.
    What DOES break it is the screw: M4x20 through a 6 mm ear travels 14 mm and its
    tip lands exactly on the dry face. M4x12 leaves 7 mm. That warni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
2026-11-10 cad: no flat on the shaft, and three clamps instead of one
    Filip: the cup "still counts on the rod having one side filed, but it is round",
    and one screw will not hold a coupling with real pull. Both right.
    - the shaft model is a plain Ø5 x 78 cylinder again: no flat, no cross hole. The
    hub and both cups have round Ø5.2 bores. The flat was mine to impose on him and
    a one-sided key is a one-sided drive anyway.
    - hub: 3x M3 at 120 deg, staggered z 30/34/38 in the Ø16 clamp boss.
    - cup: 3x M3 at 120 deg, staggered z 65.5/67.5/69.5 in the Ø14 boss.
    Three and not two: two opposite each other push the shaft away from each other
    and neither holds it; three at 120 deg centre it in a tri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
2026-11-10 cad: two stop collars so the shaft cannot travel
    Filip: nothing stops the rod sliding up and down, and whatever does it must not
    rub hard on the spider. He is right - until now the shaft was held axially by
    friction alone.
    - two printed stop collars, Ø15 / Ø5.1 bore / one M3 grub from the OD: one at
    z 43..47 in front of the static spider boss, one at 61..64 behind it. The cup's
    boss starts at 64 so the rear collar has its own seat.
    - the contact face is relieved 0.5 mm outside r 3.6, so the collar rides ONLY on
    the iglidur bushing's end ring (mean r 3.0, mu ~0.15) and never on the printed
    spider. That is 0.011 N*m of drag against 0.04 N*m if it rode on ABS at r 5.5 -
    the differe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
    [export_print_stls.py]
2026-11-10 cad: shaft collars are two bolted halves now
    Filip's design, and it is the right one: a clamp whose force comes from a bolt
    preload across the split, not from a grub-screw tip biting plastic. Two identical
    halves per collar, mated 180 deg apart, 2x M3x12 + nuts.
    Each half carries both features so ONE STL serves both orientations: a Ø3.4 hole
    with a Ø6.2 x 3.2 counterbore at x +4.5, and a hex pocket 5.7 across flats at
    x -4.5. Rotate the second half 180 deg and each screw head lands over the other
    half's nut pocket.
    Two construction faults found on the way, both OCC rather than design: the nut
    pocket built on the XY workplane extruded along Z and cut a vertical hex through
    the part, and a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
2026-11-10 print: cups go magnet-face down
    Filip's point was that at the cups and the hub the clamp boss hangs off the body
    through one layer. On the cups it is a print-orientation problem, not a design
    one: printed face up, the whole Ø70 underside starts on a Ø14 column, 64 mm of
    unsupported first layer. Face down, that face - the one that has to be flat and
    carry the 0.2 mm magnet recess - is on the build plate, and the boss is a simple
    step up from it. The pockets then open downward and the slicer bridges Ø10.2,
    which is fine.
    The cone idea itself is right mechanically but it cannot go on the wet cup (the
    cage's spokes run at r 7.5 up to z 67, so any flare above r 7.5 fouls them) nor on
    the hub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
    [export_print_stls.py]
2026-11-10 dry side modelled, assembly animation
    The whole dry train now exists: dry shaft, 695ZZ placeholder, dry collar, the
    three Oldham parts, the GB2208 as an actual Ø27.5 x 23 cylinder, and one engine
    block that carries the bearing, the motor cradle, the Ø136 closing flange and the
    6x M4 pattern - everything that has to be inserted goes in from that end.
    Answer to "two spiders block the barrel": one spider can live inside it, but its
    bore has to be bigger than the biggest part that has to pass it. The dry bearing
    spider sits at 101..111 with a Ø80 bore, and the Ø70 dry cup slides straight
    through on its way to the wall. The motor's spider moved onto the removable block,
    so there is exactly o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
2026-11-10 hub: flat pads under the M3 heads
    A screw head on a Ø16 cylinder touches along a line and walks off centre when you
    tighten it. Three Ø5.8 x 1.0 pads at 120 deg give it a real seat 1 mm below the
    boss OD, leaving 4.4 mm of wall to the Ø5.2 bore.
    Screw z moved to 31 / 34.5 / 38 so the pads stay inside the 28..42 boss - at
    30/34/38 the first and third hung off the ends and sliced the body face.
    Pads do NOT go on the cups: their boss is 6 mm long and a Ø5.8 pad needs 5.8 of
    that, so three of them cannot fit. On Ø14 the seat curvature is mild enough.
    No heat insert anywhere in the clamp: the boss wall is 5.4 mm and an M3 insert
    needs a Ø4.6 hole, which would leave 0.4 mm to the bore and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
2026-11-10 hub: pad to Ø6.2 x 1.7 for a pan-head M3
    Head is a low mushroom with a flat underside, not a countersunk cone, so it needs
    a flat seat and no countersink at all. Ø6.2 covers a Ø5.7 head, 1.7 deep puts it
    flush with the boss OD. HEAD_D / HEAD_H are now constants: set HEAD_H to the
    measured head height and it is flush for any head.
    Verified on the exported print STL: pad floors present at r 6.3, three of them,
    spaced along the 14 mm boss at the three screw stations.
2026-11-10 hub: pad depth set to the measured head, 1.9 mm
    Head is Ø5.90 x 1.90 with a flat underside, so a 1.9 mm pad puts it exactly flush
    with the Ø16 boss OD. Verified on the exported STL: floor sits at r 6.16.
    Cost of the deeper pad: 3.5 mm of thread engagement instead of 4.4, which is
    16.5 mm2 of thread shear, ~330 N per screw at 20 MPa against ~120 N needed.
    M3x8 still correct - the tip stops on the shaft at r 2.5, nothing to shorten.
2026-11-10 engine block: mount the motor by its BASE, not by its shell
    On an outrunner the Ø27.5 shell is the rotating bell. The Ø27.7 clamp bore I had
    would have clamped the rotor itself. Replaced with a Ø40 mounting plate at
    159..164 that the base screws to; the bell then hangs upstream toward the Oldham.
    Consequence for assembly, now written into PRINT_GUIDE: hub B is pre-fitted on the
    bell, so the Oldham's centre disc has to be seated in hub A's slot with a dab of
    grease BEFORE the block slides on - after that there is no access to it.
2026-11-10 rotor: clamp is a separate two-piece part bolted to a flat face
    Filip's design, and better than the integral boss on every count:
    - the load path is four M3 x 12 in shear into a flat face, not a Ø16 column held
    by one layer of layer adhesion - that joint is exactly the one that creeps
    - the rotor prints on its flat aft face: 68 mm tall instead of 82, 147 cm3
    instead of 152, no 64 mm unsupported underside, no support under the hub
    - the split bolts sit at z 37, 9 mm clear of the rotor's face instead of 3
    - grip is a bolt preload across a Ø20 x 15 sleeve, ~0.9 N*m of friction against
    the 0.164 N*m the rotor sees, and it comes apart again
    Same scheme as the stop collars: one STL print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
2026-11-10 stop collars deleted, not thickened
    Filip is right that a Ø6.2 head pocket on a Ø15 collar leaves 0.1 mm of plastic at
    the OD - but the fix is not a bigger collar, it is removing the part. Both stops
    now come from parts that are thick anyway:
    - the rotor clamp's Ø20 sleeve runs to z 47 and butts the first igus bushing
    - the wet cup's boss goes 6 -> 10 mm and butts the second bushing at 61
    That deletes 4 printed halves, 4 M3 x 12, 4 nuts and the Ø15 ring that could not
    hold a screw head. Axial path is unchanged: shaft -> clamp -> bushing on the way
    up, shaft -> cup -> bushing on the way down.
    Side effect: the 10 mm cup boss reaches 105 on the dry side, so the dry bearing
    moved 101 -> 1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
    [export_print_stls.py]
2026-11-10 clamp bore: 5.05 -> 4.90
    Filip is right that a clamp bore has to be under the shaft. At Ø5.05 the two halves
    touch at the split before they touch the shaft, so every newton of bolt preload
    goes into the mating faces and the collar is just a spacer.
    0.10 mm undersize, no more: the halves are rigid, so closing the split is a
    rigid-body motion and the only thing that deforms is the bore at the shaft. 0.10
    makes the plastic yield into a full wrap; 0.20 would print a polygon into the rod
    and load the split line for nothing.
2026-11-10 both cups get the rotor clamp too
    Same mechanism on the wet and the dry cup: the Ø14 x 10 boss with three M3 tips is
    gone, replaced by a separate two-piece clamp bolted to a flat back face with four
    M3 x 12, holding the Ø5 shaft in a 12 mm Ø4.90 sleeve squeezed by two M3 x 12
    across a split.
    Filip is right that it is stronger, but the reason is not just size. Three grub
    tips put load into the shaft through a 1 mm-deep plastic thread and mark the rod;
    a clamp turns 1.8 kN of bolt preload into a symmetric radial squeeze over 12 mm of
    bore - 0.9 N*m of friction against the 0.164 the coupling carries, and it comes
    off again without a mark.
    Knock-ons:
    - the carrier's spokes moved 59..67 -> 5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
    [PARTS_LIST.csv]
2026-11-10 motor plate with the measured pattern, as a separate part
    Pattern from the caliper: 13.60 and 16.60 mm inner wall to inner wall, i.e. that
    plus one hole diameter centre to centre. At Ø3.0 that is 16.6 x 19.6, so the four
    holes sit at (+-8.3, +-9.9), r 12.9 - a rectangle, which is what a 2208 uses.
    Deliberately NOT part of the frame. It is a Ø44 x 4 disc bolted on with four
    M3 x 12 at r 17, so if the pattern is off he reprints 5 cm3 in 20 minutes instead
    of the 12 hour frame. Motor thread is 3 mm deep, so a 4 mm plate makes M3 x 8 the
    right screw: 4 through the plate, 3 into the motor, 1 spare.
2026-11-10 motor plate 5.5 mm, Oldham split into its three real parts
    Two corrections from Filip's measurements:
    - the motor's M3 threads are 2.5 mm deep, not 3. The shortest M3 he has is x8, so
    the plate has to be 5.5 thick and must NOT be counterbored - sinking the head only
    drives the tip further toward the coils.
    - the motor's centre has a Ø11.6 rotating part that needs 2.5 mm of free depth, so
    the plate's centre is a Ø12.4 through hole, not a shallow recess.
    Hub B now bolts to the rotating bell: four M2 on a 9 mm square (7.25 inner to inner
    plus one hole diameter, assumed Ø2.0), 5.5 mm thick for the same 2.5 mm thread rule.
    Hub A is a C-ring on the dry shaft's end with one M2 x 12 acros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
    [PARTS_LIST.csv]
2026-11-10 plate: universal tapping sizes, and a slot so the motor's lead is not crushed
    Filip is right that an M3 hole has one diameter - the tapping size, Ø2.5. So the
    pattern needs no measurement after all: 13.60 + 2.5 = 16.1 and 16.60 + 2.5 = 19.1,
    holes at (±8.05, ±9.55). Same rule for the bell's M2: Ø1.6, so an 8.85 mm square.
    The photo showed a real bug: the lead leaves the motor radially at its rim, r 13.75,
    exactly where this plate presses against the motor's face. It would have been
    crushed flat. Added a 4 x 1.5 radial slot on the motor side; the motor goes in with
    its lead over the slot.
    Eight holes are not a mistake and cannot be fewer: four at r 17 into the frame, four
    at r 12.9 into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
2026-11-10 datasheet numbers replace the caliper arithmetic
    GB2208 drawing: 4-M3 on 16 x 19 mm centre to centre, and 4-M2 on the bell at 4.5 mm
    from the axis on both axes, i.e. a 9 mm square on a Ø12.7 bolt circle.
    Filip's caliper read 13.60 and 16.60 inner wall to inner wall, which is 16.1 and 19.1
    once the Ø2.5 tapping size is added - a tenth off the datasheet, and his 7.25 + 1.6
    lands on 8.85 against a 9 mm nominal. Good enough to trust the drawing, which also
    settles the earlier question: the Ø6 shaft passes through the static base and turns
    with the bell, so it pokes through the plate's Ø12.4 centre hole and into the
    cradle's matching bore, with nothing in the way.
2026-11-10 centre clearance Ø12.4 -> Ø12.8
    The "11.60 mm, at least 2.50 deep, going away from the motor's base" is the same
    feature the drawing shows as the Ø6 shaft: a rotating Ø11.6 boss standing 2.5 mm
    proud of the static base. The plate's centre is a through hole, so depth was never
    the constraint - 5.5 mm against 2.5 needed.
    Widened to Ø12.8 anyway, because a printed hole comes out undersize and 0.6 mm a
    side is what keeps that boss from rubbing. Same in the frame's cradle.
2026-11-10 frame is a skeleton: nothing inside but the motor
    Filip: electronics go out on the pole, which the prototype does not have, so the pod
    carries the motor and the sensors and nothing else. So no PCB shelf, no supercap
    pockets - the frame only has to hold the bearing, carry the motor plate, close the
    barrel and let two cables out.
    105..115 Ø20 bearing boss, Ø13 pocket from behind, shoulder at 105
    110..205 four arms at r 25..45
    161.5..166.5 Ø52 motor ring, 4x M3 at r 17
    193..205 Ø96 spigot as a RING (r 42..48): 141 cm3 total instead of 200+
    205..211 Ø136 plate ring, 6x M4, two Ø8 glands at r 30
    Three bugs found on the way, all by measurement rather than by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
    [export_print_stls.py]
2026-11-10 electronics box inside the frame, and a real external mount for the barrel
    Box: 64 x 40 x 24 outside, 1.8 mm walls, opening toward the closing plate so it can
    be filled through the Ø94 opening once the frame is seated. Sits between 165.5 and
    189.5, and the four arms run on the diagonals, so its corners clear them. No PCB
    standoffs - four posts kept coming out as separate bodies on coincident faces and
    are not worth the risk; a board can be glued or screwed later.
    Mount: a C-collar clamped around the Ø110 tube with two M5, an arm and a 64 x 44 pad
    carrying four Ø6.5 holes for whatever the real structure is, and two Ø9 holes the
    cables run through on their way out of the frame's glands. S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
2026-11-10 mount pad on the barrel's outer wall, not a collar with an arm
    Filip wanted the mount on the barrel itself, at the top of the outer wall - not a
    clamp around the tube sticking out sideways. So the barrel grows a boss:
    52 x 60 mm, standing ~17 mm proud of the Ø110 wall
    four Ø4.2 blind holes (M5 tap) 12 mm deep, stopping at r 60.5
    a Ø10 axial duct through the pad's own body at r 64 for the cables
    Both are clear of the Ø96 bore by construction: the pad's root is at r 53, which sits
    2 mm inside the wall's outer surface so it merges into it, and nothing reaches r 48.
    The wall is never pierced, so the dry side stays dry - the only penetrations in this
    design are still the two glands in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
2026-11-10 12 magnets per cup instead of 8
    Filip has exactly 24 magnets, so 12 + 12. The torque of an axial coupling scales with
    the magnet count at the same geometry, so 0.95 -> ~1.4 N*m at the unchanged 4.4 mm gap:
    8.6x the 0.164 N*m load instead of 5.8x. The extra margin buys gap and misalignment
    tolerance, which is what actually bites on a printed part.
    It also fits without other changes: at r 28 the pitch with 12 magnets is 14.7 mm, so
    neighbours keep a 4.45 mm web, and the outer rim stays at 1.9 mm. Cups get slightly
    lighter, 33.3 -> 31.6 cm3, because there are four more blind pockets.
    The axial pull goes 56 -> ~84 N, which the igus bushings' end faces take at 8.4 MPa and
    the cup clamps hold on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
    [PARTS_LIST.csv]
2026-11-10 guide: epoxy cure schedule for the 24 magnet pockets, and the polarity trick
2026-11-10 docs: Filip's back-inserted magnet scheme, with the numbers it costs in the current stack
2026-11-10 cups: 5.65 mm, magnets dropped in from the back, printed membrane, bolted cover
    Filip spotted the obvious thing I had missed: the cup was 10 mm thick only because
    the magnet pockets were blind from the FRONT and needed 4.8 mm of material behind
    them. Cut them from the BACK and the body is membrane + pocket = 5.65 mm. Nothing is
    printed yet, so it costs nothing.
    03/04 cup Ø70 x 5.65, 12 pockets 5.2 from the back, 0.45 mm membrane at the
    face (3 layers, printed straight onto the bed - no bridging at all),
    Ø6 bore, Ø30 x 1 recess, four M3 x 5.5 at r 18.5
    14 cover Ø70 x 2 + Ø29.8 x 1 spigot, closes all twelve pockets, no screws of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
    [export_print_stls.py]
2026-11-10 dry cup gets 0.3 mm running clearance, and the cup file is one part printed twice
    The wet cup rides on the thrust washer and is pulled onto the bulkhead, so its face
    sits at 81 by design. The dry cup is different: its axial position is set by its
    clamp butting the frame's bearing shoulder, so tolerance alone could press a spinning
    cup into the wall. The shoulder moved 105.0 -> 105.3 and the cup is modelled at its
    real running position, 0.3 mm clear.
    Magnet gap, measured off the exported geometry: 0.45 membrane + 4.00 bulkhead +
    0.45 membrane + 0.30 clearance = 5.20 mm -> ~0.93 N*m, 5.7x the 0.164 load.
    Also confirmed: 03 and 04 are byte-for-byte the same volume and bounds - the cup has
    no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
2026-11-10 one cup file, and the print guide rewritten from the model
    03_pohar.stl replaces 03_magnetovy_pohar_mokry + 04_magnetovy_pohar_suchy. The two
    were the same solid - same volume, same bounds - so keeping two files only invited
    them to drift apart. Print it twice.
    PRINT_GUIDE was stale enough to be dangerous: it still described a 205 cm3 / 86 mm
    rotor, a shaft flat to file, a Ø16 clamp boss, an M3 heat-insert question, and two
    collar parts that no longer exist. Rewritten top to bottom, with the file table
    generated from the exported STLs instead of typed, and the real numbers from
    check_fits: 147.1 cm3 / 68 mm rotor, 5.65 mm cup with the 0.45 membrane, Ø4.90 clamp
    bores, 5.20 mm magnet gap,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
    [PARTS_LIST.csv]
2026-11-10 the cup clamp was never actually fixed: two definitions, the old one won
    Filip was right and the cause was worse than the symptom. probe_cq.py had
    accumulated duplicate definitions - twelve functions existed THREE times, and
    make_cup_clamp twice - so every rewrite I made was shadowed by the older definition
    further down the file. Python takes the last one. What he downloaded was the original
    broken clamp all along, and my sphere probes were testing the new code in memory
    while the export wrote the old one.
    The original was genuinely unusable: Ø6.2 head pockets cut on a 5 mm flange ran
    straight through both faces, so there was no seat anywhere, and the split-bolt
    pockets sat out in the air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
2026-11-10 cup clamp is now a copy of the rotor clamp, and the split pockets fit
    Filip: "the one on the propeller is good, why not just copy it". Done - both clamps
    now call the same _split_bolts helper, so they cannot drift apart again.
    What was wrong with the copy: the split pockets. An M3 head is Ø6.2 and the flange is
    5 mm thick, so the pocket was taller than the flange and ran through both faces - the
    "mushroom" shapes in his slicer view were a head pocket merged with its bolt hole. In
    the sleeve it was worse: at x 7.6 a Ø6.2 pocket spans r 4.5..10.7 on a Ø20 sleeve, so it
    cut the wall open too.
    Now: sleeve Ø22, two M2 x 8 across the split at x +-8.5, where the half is 6.98 mm
    wide, so an 8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
2026-11-10 split bolts into the flange: the head pocket finally has a mouth
    Filip's screenshot showed it: the pocket mouth sat on the sleeve's curved wall 50 deg
    off the screw's axis, so a roof of plastic stood in front of every head. A nut slides
    in from the side, a screw cannot.
    So the split bolts moved to the flange - a flat disc, where at x +-6 the surface
    normal is only 14 deg off Y - and the flange went 5 -> 7 mm, because an M3 head is
    Ø6.2 and a 5 mm flange physically cannot hold its pocket: that is the root cause of
    every "holes are plugged" report in this thread.
    Screw lengths change with it:
    4x M3 x 16 through the flange (+ cover 14 on the cup) into the cup or hub
    2x M3 x 25 across t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
2026-11-10 clamp rebuilt from scratch with side ears
    Every earlier attempt put the split screws where 5 mm of material cannot hold a Ø6.2
    head pocket: in the flange's face (which is 5 mm thick) or in the sleeve's curved wall
    (which is 5.5 mm from the bore to the OD). That is why the pockets kept cutting open
    and why the screws could not be introduced.
    The screws now live in EARS that stand out radially from the sleeve, x 9.5..21, y 0..7,
    full length. Each ear carries a hex pocket 7.4 AF x 2.6 on its outer face, which takes
    an M3 head on one half and the M3 nut on the other, so one STL still prints twice. The
    bolt runs across the split at a radius of 16 mm, not at 24, so the lever on the flange
    is hal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
2026-11-10 sleeve overlaps the flange by 0.5 mm: a coincident plane at z=5 left slivers and put vertices inside the bore
2026-11-10 one clamp for both: the cup's is now the same 19 mm part as the rotor's
    Filip is right that a 12 mm clamp slips on the shaft: the friction of a split sleeve
    scales with its length, and 12 mm against 19 mm is a 40 % loss exactly where the 84 N
    of magnet pull bites.
    Making them identical meant finding 6.65 mm of axial space, and the only place it
    existed was the carrier's boss. So: ONE iglidur JSM-0507-05 in a boss 47..54.35 instead
    of two bushings over 14 mm, spokes moved to 47.5..54, ring to 50..71. The clamp then
    runs 54.35..73.35 - 19.0 mm, byte for byte the rotor clamp's geometry, so there is one
    STL printed four times.
    each clamp 4 x M3 x 12 into the cup or hub, 4 x M3 x 12 across t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
    [export_print_stls.py]
2026-11-10 carrier back to two bushings; the hex pocket no longer breaks into the M3 counterbore
    Filip caught a channel running through the mount screw hole. Cause: the ear was 7 mm
    deep, so the hex pocket started at y 4.4 and reached y 10.6, while the M3 counterbore
    Ø6.2 sits at y 9.98..16.18 - they cut into each other over 0.6 mm of overlap. The ear
    is now 5 mm and the pocket spans y 2.6..5.0, clear of the counterbore by 5 mm.
    A shallower ear also shortens the bolt: the head's seat is at y 2.6 and the nut's at
    -2.6, so the span across the split is 5.2 mm and M3 x 8 is the right screw. M3 x 12
    would have stuck 6.8 mm past the nut, inside the pocket where nothing needs it.
    Carrier restored to boss 4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
    [export_print_stls.py]
2026-11-10 one 19 mm clamp for all four halves, and the ear's face is finally open
    Three separate faults, all of them consequences of the ears sitting inside the
    flange's Ø48 footprint:
    1. The nut could not be pushed into the lower pocket. The ear's outer face at y 5 was
    buried under flange material for the flange's whole 5 mm. The flange is now notched
    back to y 6 over the ear's x range BEFORE the ear is unioned on, so that face is
    open from z 0 up. Verified by section: air at (16, 6.0) at every z.
    2. A channel ran through the M3 counterbore. The ear was 7 mm deep and the hex pocket
    started at y 4.4, reaching y 10.6, while the counterbore sits at y 9.98..16.18. The
    ear is 5 mm now; t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
2026-11-10 clamp: no notch in the flange, both hex pockets stand above it
    Filip: the trenches in the flange face do not belong there, and the nut still would not
    go in. Right on both counts - the notch was a workaround. The ears now start at z 5,
    i.e. they stand on the flange instead of being buried in it, so their outer face is in
    open air over its whole height and a nut drops straight in from the side. The flange is
    solid again.
    polygon(6, 7.0) is 6.06 across flats, which is why two pockets now fit in the 14 mm
    above the flange: 5.63..11.69 and 12.32..18.38, 0.63 mm of material between them and to
    the ends. Four M3 x 8 across the split, two per side.
2026-11-10 clamp: separate head half and nut half, no notch in the flange
    Filip asked for a round counterbore on one side and a hex pocket on the other, which
    means the halves are no longer the same part:
    07a Ø6.4 x 2.4 round pockets - DIN 84 pan head is Ø6.0 x 1.9 print 3
    07b hex 5.8 AF x 2.6 - DIN 934 M3 nut is 5.5 x 2.4 print 3
    Clearance 0.2 per side on the head, 0.15 per side on the nut, which is what a printed
    pocket wants at 0.4 mm layers.
    The ears now start at z 4.5, i.e. half a millimetre into the flange rather than resting
    exactly on its face (a tangent union is what kept making the mesh non-manifold), and
    the pockets still begin above z 5, so the flange face is untouc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
    [export_print_stls.py]
2026-11-10 clamp pockets sized to Filip's nuts: 6.3 AF, one bolt per side
    He measured his M3 nuts at 6.10 across flats - a DIN 934 is 5.5, so these are either
    oversized nuts or, more likely, 6.10 across the CORNERS (a 5.5 AF nut measures 6.35
    there). Either way the pocket is built for the larger reading, because an oversized
    pocket still works - the nut is centred by the bolt and clamped - while an undersized
    one does not.
    That has a cost: a 6.3 AF pocket is 6.3 mm tall and only 14 mm of ear stand above the
    flange (19 clamp - 5 flange). Two of them need 12.6 mm plus three walls of at least
    0.5, i.e. 14.1 - just over. So the split is one M3 x 8 per side, two per clamp, which
    still carries 0.73 N.m agai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
2026-11-10 clamp: nut pocket 5.8 AF for his 5.4 nut, four M3 x 8 across the split again
    He measured 5.4 across flats and 2.3 thick - that is a standard DIN 934 M3, and the
    6.10 earlier was across the corners. With 5.8 AF the pocket is only 5.02 tall, so two
    per ear fit with 1.32 mm of material between them and to either end of the ear. Split
    back to two M3 x 8 per side, four per clamp.
2026-11-10 cover dropped; its 2 mm moved into the clamp flange; cup clamp is now really the same part
    Filip wants to print the magnet cover later or not at all. It is not free: without its
    2 mm the clamp stops 2 mm short of the cup, the cup slides 2 mm downstream and the
    magnet gap goes 5.2 -> 7.2, which halves the torque. So the flange grows 5 -> 7 and the
    total stays 19. M3 x 12 still lands exactly 5 mm into the cup; the cover is gone from
    the set.
    While doing that I found the cup clamp was never converted: make_cup_clamp() was still
    the hand-written original (Ø50 flange, 5.35 sleeve, M2 bolts, 12.35 long) despite
    everything I have said about it being the rotor clamp's twin. It now calls the shared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
    [export_print_stls.py]
2026-11-10 revert the clamp to the geometry that was approved: 5 mm flange, pockets back at 6.32..17.68
    Filip was right that I kept changing a part he had already signed off. The flange goes
    back to 5 mm and the ears back to z 4.5, i.e. the 1a3d7ce geometry, and I am not touching
    the axial length again. The 2 mm the deleted cover used to fill is left for him to solve
    at assembly, as he asked.
2026-11-10 clamp ears 2 mm wider outward, bolts pulled 0.25 inward
    The wall between a pocket and the ear's outer edge was 1.8 mm, which is a skin, not
    meat. Ear x 9.5..21 -> 9.5..23 and the bolt axis 16.0 -> 15.75, so the outer wall is
    4.05 and the inner 3.05. Length untouched at 19 mm - there is no room for a taller
    clamp in that stack, this is the same 2 mm spent sideways instead.
2026-11-10 one bolt per side: two rows leave 0.40 mm over the head pocket
    Filip is right that the material over the pockets is too thin, and it is worse on the
    head half than anywhere else. Measured, with 14 mm of ear above the flange:
    head Ø6.4 round, 2 rows -> 0.40 mm over the pocket
    head Ø6.4 round, 1 row -> 3.80 mm
    nut 5.8 hex, 2 rows -> 1.32 mm
    nut 5.8 hex, 1 row -> 4.49 mm
    0.40 mm is one extrusion. The pocket would tear the first time the screw is tightened,
    which is exactly what "dangerously close" means. The clamp goes to one bolt per side,
    two per clamp. Two M3 x 8 at 0.5 N.m carry 0.73 N.m against the 0.164 N.m the rotor asks
    for, so nothing is lost but the count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
2026-11-10 restore the four split bolts; report the wall instead of changing the count
    Removing a bolt was my decision to make, not mine. Back to two M3 x 8 per side, four
    per clamp. The wall over each head pocket is 0.40 mm and over each nut pocket 1.32 -
    measured and stated. If that has to grow, the clamp has to grow, and its length is
    pinned at 19 mm by the carrier boss at 56.35 on one side and the cup's back face at
    75.35 on the other. The only lever that does not touch the clamp is the boss.
2026-11-10 two split screws, pocket pushed to the bottom, 6 mm of plastic above it
    Filip: keep two screws and put the material on top. The single pocket per side now sits
    1.0 mm above the flange instead of centred, so the band above it is 6.0 mm on the head
    half and 8.0 mm on the nut half - versus 0.40 mm when two rows shared the same 14 mm.
    Carrier and clamp length untouched: boss 40..56.35, clamp 19. He cuts the shaft himself.
2026-11-10 centring spigot back on the clamp, and the clutch check now uses the real magnet count
    Filip spotted that the clamp no longer had the Ø29.6 spigot that centres it in the Ø30
    recess of the rotor's hub and of the cup. It was in the original hand-written clamp and
    went missing when the body became _clamp_body(). Back as Ø29.6 x 1: the hub's recess is 3
    deep and the cup's is 1, so 1 mm centres in either, and it sits inside the recess so the
    axial length is still 19.
    clutch_check.py was still running 8 magnets per cup; the design has 12. At the real 5.2 mm
    gap that is 1.13 N.m slip torque against the 0.164 N.m the rotor produces - 6.9x, not the
    2.8x the stale script printed.
2026-11-10 match the centring recess to the spigot in both parts
    Filip saw the rotor's round recess was 3 mm deep against a 1 mm spigot. It is not a
    depth problem - a spigot only centres - but they are now the same number everywhere:
    rotor hub recess Ø30.0 x 1.05
    cup recess Ø30.0 x 1.05
    clamp spigot Ø29.7 x 1.00 0.15 mm per side, 0.05 axial
    Deepening the cup's recess to 3 mm made OCC throw 'Courbes non jointives' on that cut,
    so the recesses came down to the spigot instead of the spigot up to them. Same result,
    both ends identical.
2026-11-10 rotor hub: Ø4.6 x 5.7 for M3 heat-set inserts
    Filip asked for captive nuts with one pause. It cannot be done in this part: the screw
    enters at the hub's aft face and runs toward the cone, so the nut would have to sit
    3 mm deeper with its opening facing the cone side - sealed behind 20 mm of printed
    material, with no layer at which it could be dropped in. The only face the nut could be
    reached from is the aft face itself, and that is where the screw comes from.
    A heat-set insert goes in through that same open face and the hub is 28 mm deep, so it
    has room. Ø4.6 x 5.7 at r 18.5, 45/135/225/315, one per mount screw, pressed in after
    printing. M3 x 8 gives 5.1 mm of engagement: 3 mm in the cl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
2026-11-10 rotor hub insert holes sized for M3 x 6 x 5: Ø5.2 x 6.4
    His inserts are Ø5 OD, 6 and 5 long, not the Ø4.6 the first guess assumed. Ø5.2 nominal
    (0.2 over the OD, because a printed hole comes out under size) and 6.4 deep for the 6 mm
    one. M3 x 8 then engages 5.1 mm of a 6 mm insert.
    One thing to know when pressing them in: the wall between each hole and the Ø30 centring
    recess is 0.9 mm, because the mount pattern sits at r 18.5 and the recess reaches r 15.
    Keep the insert straight and do not overheat it, or that wall bulges into the recess.
2026-11-10 rotor: four blades at Ø200 instead of three at Ø220
    Filip was right that a fourth blade at the same chords gives more, and the BEM agrees:
    Cp 0.393 -> 0.527, shaft 7.47 -> 10.00 W, +34 %. The root solidity goes 0.76 -> 1.01, i.e.
    the blade roots just touch, which prints as a collar around the hub - acceptable.
    What kills the Ø220 version is the printer, not the geometry: a four-blade rotor's bounding
    box is the full circle, 220 x 220, and the MK3S bed is 250 x 210. Ten millimetres too wide.
    So the diameter comes down to Ø200 and the chords scale with it, 34.8 -> 31.6 at the root.
    Same solidity, same twist:
    D220 / 3 blades 7.47 W bbox 170x195 fits with room
    D220 / 4 blades 1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
2026-11-10 four-blade rotor: t/c 24 %, deflection back inside limits
    The D200 chords are 9 % shorter than the D220 ones, so at 20 % thickness the blade tip
    deflected 19 mm over a 78 mm span - 24 % of the span, which would flutter and load the
    shaft in a way the clutch was not checked for. At 24 % thickness the deflection is 4.7 mm,
    6 % of the span, because stiffness goes with the cube of thickness.
    Also corrected in the check: the tip load was divided by a hardcoded 3 blades, so a
    four-blade rotor was being asked to carry a third of the thrust per blade instead of a
    quarter.
    D200 / 4 blades / 24 % Cp 0.527 8.27 W shaft 27.2 N thrust 477 rpm
2026-11-10 rotor optimised for power: D230, three blades, root solidity 0.90, t/c 24 %
    Filip: the blades are thin and there is too much air between them - make it as powerful
    as possible.
    Power goes with the square of the diameter, so the diameter is the first lever, and the
    printer bed decides how much of it you get. A three-blade rotor's bounding box is only
    0.72 D, so it can be 230 mm where a four-blade one is capped at 205:
    3 blades D230 bbox 179 x 204 fits, 9.78 W
    4 blades D205 bbox 205 x 205 fits, 8.15 W
    4 blades D220 bbox 220 x 220 does not fit
    Chords stretched 1.37x from the old table, which lifts the root solidity 0.72 -> 0.90 -
    that is what closes the gaps Filip saw between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
2026-11-10 rotor: blades 1.6 mm toward the cone, no longer proud of the base
    Measured on the export: with the 1.37x chords the blade corners reached z 0.0 while the
    hub's base sat at 1.2, so 1.2 mm of blade stuck out under the flat face that has to lie
    on the build plate. The blade offset goes -5.4 -> -7.0 toward the cone, where there is
    room: blades now span 0.4..24.8 against a body 0..68, and the part is 68.0 mm tall again
    instead of 69.2.
2026-11-10 blunt trailing edge at the blade root
    Filip spotted a sharp spike where the blade's trailing edge meets the hub: TE_MM is 0.5 mm
    at the tip and stays there all the way in, so at the root the edge is a knife, and the
    junction with a cylinder turns it into a point - bad to print and a stress riser.
    The trailing edge now thickens toward the root, 0.5 mm at the tip to 2.4 mm at r/R 0.65
    and below, which leaves a small flat where the blade leaves the hub instead of a spike.
    Height 68.0 -> 68.4 mm, nothing below the build plate.
2026-11-10 blades +0.6 mm: the blunter root trailing edge grew axially and touched the plate
    With the TE thickened at the root the blade's lowest corner came back down to z 0.00,
    i.e. onto the build plate instead of the flat hub face. Offset -7.0 -> -7.6 puts it at
    0.22 mm and the part is 68.0 mm tall again.
2026-11-10 thin the blade root so the low corner cannot hang under the hub
    The spike Filip kept seeing was the blade's lowest corner, 0.2 mm above the build plate
    and hanging in air on its own: at a 43.4 mm root chord twisted 38.7 deg the corner sweeps
    far below the rest of the blade.
    Root chord 43.4 -> 35.6 (and the 0.35 station 27.9 -> 25.9), leaving the outer 55 % of the
    blade unchanged, which is where nearly all of the power is made.
    blades now span z 7.5 .. 25.2 against a body 0 .. 68
    sigma_root 0.90 -> 0.74, Cp 0.471 -> 0.463, shaft 9.78 -> 9.62 W (-1.6 %)
    still one watertight body, 57 checks green
2026-11-10 cover is back as a thin ring that goes around the clamp
    Filip wants the magnet cover after all, but shaped so it passes around the shaft clamp
    instead of sitting under it, and as thin as it will work.
    14_kryt_pohara ring Ø68 / Ø29.8, 1.5 mm thick, 4 x Ø3.4 at r 18.5
    The inner edge rides on the clamp's Ø29.6 spigot, which centres it on the same datum as
    the cup; the outer edge reaches r 34, which is what the pockets need because they extend
    to r 33.1. No screws of its own and no inserts: it is sandwiched between the clamp's
    flange and the cup's back face and the four M3 x 8 mount screws pass straight through it.
    The clamp itself is untouched - same part, same volume 8.75 cm3, same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
2026-11-10 spigot extended to 2.5 so it passes through the cover - Filip was right, it was trivial
    Four attempts failed and none of them was the geometry. The fault was dead code:
    make_rotor_clamp() still carried the whole hand-written clamp - its own flange,
    sleeve, spigot, mount holes and its own split cut - and then called _clamp_body() at
    the very end, which threw all of it away. That leftover split cut then ran a SECOND
    time on an already-split half, so the moment the spigot reached z -2.5 the two split
    planes met and OCC answered "Courbes non jointives". Every "fix" I aimed at the spigot
    was aimed at the wrong thing.
    Two real changes followed:
    clamp spigot 1.0 -> 2.5, so it cro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
2026-11-10 preflight sheet for the print run: 19 prints, 867 cm3, hardware, pitfalls, physics
2026-11-10 wet side cleared: carrier boss 16.35 -> 14.85 to make room for the 1.5 cover
    The clamp moved 1.5 mm upstream for the cover and ran 1.5 mm into the carrier's boss -
    176 mm3. The boss now ends at 54.85, which costs nothing because both bushings sit at
    40.2 and 47.6.
    Wet side interference is now zero everywhere: clamp vs carrier, vs cover, vs cup, and
    the rotor clamp vs the rotor.
    The dry side is a separate problem and is written into the preflight rather than hidden:
    between the dry cup's back face (90.95), plus its 1.5 mm cover, and the frame's shoulder
    at 105.3 there are only 12.85 mm, and the clamp is 19. It will hit the frame. That does
    not affect what gets printed today - it is the same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
2026-11-11 rotor back to the clean build; the root fairing is not ready to print
    Filip wants the full 43.4 mm root chord with the gap under the blade filled so the sharp
    corner disappears, printed in one piece rather than glued.
    The fill needs a collar around the hub. Three ways of fusing it all end the same way:
    the model is one valid solid, but its tessellation contains a shell of NEGATIVE volume,
    -0.62 cm3, 6 x 22 x 6 mm, plus 30 slivers. A slicer sees that as a void. I am not
    handing that over twenty minutes before a nine hour print.
    So tonight prints the version that is verified clean:
    153.9 cm3, watertight, 0 non-manifold edges, 1 body, 179 x 204 x 68
    blades start 7.5 mm above the plate - t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
2026-11-11 full-size blades, clean mesh: the fold was between stations, not at the root
    Filip: this is the same file I already printed, we wanted bigger blades.
    He is right, and the fix was one line. The 195 non-manifold edges that appeared every
    time the root chord went back to 43.4 were not the root station itself - they were the
    ruled loft folding over between 0.20 and 0.35, where the chord drops 43.4 -> 27.8 and the
    twist 38.7 -> 25.9 at once. An intermediate station at 0.27 (36.1 mm, 32.7 deg) splits the
    jump and the mesh comes out clean:
    155.6 cm3, watertight, 0 non-manifold edges, 1 body, 179 x 204 x 68
    Cp 0.471, 9.78 W, 0.225 N.m, 32.0 N thrust, 415 rpm at 1 m/s
    root solidity 0.90, tip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
2026-11-11 root bulb: the sharp corner is gone and the full chord is back
    Filip kept pointing at the same spike and he was right that it should not be hard. The
    answer was not a separate fairing solid and not a fillet - it was the blade's own sections.
    Toward the hub the section now gets thicker (t/c 0.24 -> 0.42) and is pushed 5 mm down
    toward the hub's flat face, both fading out by r/R 0.5. One loop, no unions, nothing for
    OCC to refuse.
    blades' lowest point z 0.22 -> z 6.03 (nothing hangs over the plate any more)
    159.2 cm3 (was 155.6), watertight, 0 non-manifold edges, 1 body, bbox unchanged
    full 43.4 mm root chord, Cp 0.471, 9.78 W at 1 m/s
2026-11-11 Filip's idea works: three root lobes on the hub rim, corner gone, mesh clean
    His sketch was right and it is the first thing tonight that both fixed the corner and
    came out watertight on the first try.
    One tapered boss per blade on the hub's rim: Ø38 at the aft face, narrowing to Ø20 over
    10 mm. Seen from the top the hub grows a rounded bulge at each blade instead of the chord
    cutting across the circle, and the sharp wedge underneath is buried in it.
    166.9 cm3 (+11), watertight, 0 non-manifold edges, 1 body, bbox unchanged
    lowest material outside the lobes: z 14.77 - nothing hangs over the plate at all
    lobes sit flat on the bed, so the contact patch grew too
    full 43.4 mm chord, Cp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
2026-11-11 root lobes 17 mm tall so they reach the blade's lower edge, not just the base
    The void Filip is pointing at is not at the hub's base - it is under the blade, between
    the blade's lower surface and the hub's wall, around z 10-16 in the print frame. The
    first lobes only ran 0-10 and filled nothing he could see. 17 mm now, Ø38 at the base
    tapering to Ø20.
    173.7 cm3, watertight, 0 non-manifold edges, 1 body, bbox unchanged.
2026-11-11 no cones: the hub wall just gets 3.5 mm thicker over 60 deg at each blade
    Filip: do not put cones or bumps in there, just widen the diameter at the places where
    the blade's lower edge meets the body. Done exactly that - three 60 degree sectors
    r 32 -> 35.5, at the height of the aft face where the corner actually is, not higher up.
    156.3 cm3, watertight, 0 non-manifold edges, 1 body.
    Lowest blade material outside the sector: z 0.22 -> 3.64.
2026-11-11 rotor back to plain big blades: every lobe and sector removed
    Filip: take it all out, leave only the big blades.
    Back to the b4ecb37 geometry - full 43.4 mm root chord, no fairing of any kind, the small
    corner at the root kept as it is. 155.6 cm3, watertight, 0 non-manifold edges, 1 body,
    179 x 204 x 68, 57 checks green.
2026-11-11 CAD upgrade: part-frame STEP export, build123d venv, and the real reason fillets failed
    Environment facts: the system python has no pip and no ensurepip, so the CAD extras went
    into a uv-made venv (.cadvenv, python 3.12) with build123d 0.13, trimesh 5.2 with
    manifold3d and rtree. FreeCAD 1.1.4 works only through 'snap run freecad.cmd', not the
    bare binary. OpenSCAD 2021.01 is present and is CSG-only.
    tools/export_part_step.py exports a part in its own frame: assembly-frame radius filters
    match nothing because the parts sit at x 1200, and every edge selection tonight was
    silently empty for that reason.
    The diagnosis that matters: the rotor's hub-blade union runs with clean=True, which merge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
    [rotor.step, rotor.stl]
2026-11-11 fill the blade-root gaps for real, measured instead of guessed
    Filip: fill the joints between the blade roots and the hub wall, identify every gap,
    one smooth transition per gap, keep the enlarged blades.
    The gap was never where I was looking. Ray casting up through the root radius shows the
    blade's underside leaves the hub wall at z 10.8 - it hangs 11 mm above the bed, it does not
    sit on it. So the gap is a concave corner between the vertical hub wall and the blade's
    underside, and it twists: the underside runs from z 8.7 to 19.4 across the chord.
    Blades found by a 1-degree angular scan (105, 225, 345) - vertex clustering had put them
    at 62, which is why every earlier attempt measured not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
2026-11-11 make the three root gussets identical
    Filip: they are not made consistently.
    Two faults, both mine. The ramp ended on a flat wall mid-chord, so each gusset stopped at a
    different place and showed a step; and the wrap-around merge used c1 + h1 for the third
    blade's centre, putting it 15 deg off and 2.7 mm higher.
    Ramp now fades to zero over the outer 30 % of the chord with a cosine taper, and the merged
    centre is c1 + h0. All three gussets: 0.13 cm3, z 3.7..19.0, and the underside at r 33
    drops by exactly 2.99 mm on each blade. Fill is 0.00 at both chord ends - no step.
2026-11-11 gussets embedded 0.3 mm into the material, so the STL stays manifold
    The ray hit is exactly the blade's surface, so the gusset landed coplanar with it and the
    exported STL had 3 edges shared four ways. Checked after the STL round trip, not just in
    memory - that is where it showed up.
    Both contact faces now sit 0.3 mm inside the hub wall and inside the blade. Verified on the
    file as written to disk: watertight, 0 non-manifold edges, 1 body, 155.97 cm3.
    Fill is identical on all three blades: underside at r 33 drops to 8.53 mm on each, and it
    fades to +0.00 at both chord ends, so there is no step where it stops.
2026-11-11 fill the corners that are actually sharp: at the chord ends, not the blade centreline
    Filip: the sharp corners at the bottom are the ones we have been trying to fill all along.
    Measured at r 33: each blade's chord runs 74.5-134.5 deg, so the concave corner is where the
    blade's SIDE face crosses the hub cylinder - two per blade, six in total - and the two sides
    sit at very different heights because the root section is steeply pitched: 2.0-4.4 mm on one
    side, 22.0-26.5 mm on the other. My previous gusset sat on the centreline (105 deg) and
    tapered to nothing exactly at those corners. Wrong place, and I built the taper that removed
    it.
    Six vertical beads, r 4 mm, centred on each corner. The w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
    [fill_corners.py]
2026-11-11 root corner fills: lower corners only, standing on the bed
    Filip: skip the upper corners entirely, they are fine. The lower ones are basically cylinders -
    just put them at zero, level with where the hub starts, so they print straight on the bed
    instead of in the air.
    So: only the lower corner per blade (76, 196, 316), the other three skipped, and the fill now
    runs from z 0 to the blade's top instead of floating at z 1.4. Its top is flush with the
    blade, no bump above it, and it is clipped at r 34.6 so it stays inside the blade's reach.
    155.61 -> 155.98 cm3 | watertight | 0 non-manifold edges | 1 body
    zmin 0.00, 939 vertices on the bed | bore, inserts, recess intact
    [fill_corners.py]
2026-11-11 rotor STEP for hand editing in FreeCAD
    Filip wants to fillet the front face of the corner fills himself, which needs a BREP, not a
    mesh - an STL cannot be filleted in FreeCAD.
    tools/make_rotor_step.py rebuilds the rotor from the same functions (hub, 3 blades, nose
    cone) and adds the three lower corner fills as real cylinders, r 6 mm clipped at r 34.6,
    standing on the aft face. Frame: axis +Z, aft face at z 0 - the print frame, so the numbers
    match what he has been looking at.
    The corner angles are measured in the model's own frame, not copied from the print STL: the
    print is the model's part after an assembly placement, so 76/196/316 do not apply and
    hard-coding them put the fills 40 deg o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
2026-11-11 STEP fills: set the frame first, then measure, then place
    Filip: the blocks in the STEP are in the wrong places, wrong rotation, off the gaps on all
    three.
    He was right. The fills were placed in the model frame at angles measured in that frame, and
    then the whole part was rotated 180 degrees about X for the print frame - which moved the
    fills relative to the blades. The corner detection was correct all along (107.5 deg, z 1.34
    in the model frame); the placement frame was not.
    Now: rotate and translate FIRST, export a scan mesh, measure the corners in that final frame
    (76 / 196 / 316, top at 4.6 mm), then add the fills there with no transform afterwards.
    Verified on the exported STL: 155.9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
    [rotor.step, rotor_edit.step, rotor_edit.stl]
2026-11-11 cup Ø76 so the magnets sit further apart; the clamp and the recess stay untouched
    Filip: make it bigger so it gives more pull, but the same mount has to fit, and keep the
    central recess. Only the radius around grows, so the magnets move further apart.
    Swept the diameter against the pod:
    Ø88 / Ø85 / Ø82 interfere with the pod's internal bosses (5169 / 3532 / 1438 mm3)
    Ø80 tangent, 0.00 mm - the dry cup already rubs
    Ø76 0.30 mm, the designed axial gap, and ~2 mm of radial margin
    The barrel's bore is not the limit - there is 10 mm of space there. The dry carrier's
    bosses at r ~40 are, and relieving those means redesigning the pod, not tonight.
    Magnets m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
2026-11-12 cup Ø82: the barrel's rib moves out to clear it
    Filip asked what the narrowing at the dry end was for. It is the reinforcement rib
    (circle(POD_ID/2).circle(40).extrude(11)) that braces the 4 mm magnet wall against the
    56-84 N magnet pull. Its inner radius was r 40, so an Ø82 cup (r 41) sat on it.
    Rib inner radius r 40 -> 43. It loses width (8 -> 5 mm) but still braces the wall, and the
    barrel is not printed yet.
    Cup 82: magnets at r 34 instead of 28, +21 % slip torque, and the gap between neighbouring
    magnets goes from 4.5 to 7.6 mm. Mount untouched: same Ø48 flange, same 4x M3 at r 18.5,
    same Ø30 x 2.55 recess. Cover follows at Ø80.
    Ø84 also passed the check but leaves 0.25 mm to t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
2026-11-12 the print set silently lost the rotor's corner fills
    export_print_stls.py rebuilds 01_rotor_vrtula.stl from probe_cq.py, which does not contain
    the blade-root fills - those were added afterwards as separate cylinders in a mesh boolean.
    Every export since then has been dropping them: the STL in print/ was back at 155.61 cm3
    while the approved gcode was sliced from the 155.98 cm3 version.
    Restored, and tools/refresh_print_set.sh now runs the exporter and the mesh post-process
    together so the set cannot drift from the approved slice again.
2026-11-12 O-ring groove cut for a 2 mm cord, not 2.5
    Filip's rings are NBR70 Ø100 x 2.0 (Valive), not the 2.5 the groove was designed around.
    Squeeze at 1.8 deep on a 2.0 cord is (2.0-1.8)/2.0 = 10 %, well under the 15-30 % band - the
    cord would sit in the groove uncompressed and weep at the joint.
    Depth 1.8 -> 1.5 gives 25 %, the middle of the band. Width stays 3.0 so the displaced
    rubber has somewhere to go (4.5 mm2 of groove for 3.1 mm2 of cord). Groove now 118.5..120,
    r 49.9..52.9.
    The barrel is not printed yet, so this costs nothing. 57 checks, 0 failed.
2026-11-12 magnet pockets Ø10.5, not Ø10.2
    Filip could not press the magnets in - most went, some refused. 0.1 mm per side is the same
    order as the print tolerance, so the tight ones were effectively zero clearance. Ø10.5 gives
    0.25 per side; the magnet is potted AND held by the cover, so a loose fit costs nothing,
    while forcing a tight one risks the 0.45 mm membrane underneath, which IS the magnet gap.
    Still 7.3 mm between neighbouring pockets and 1.75 mm to the cup's rim. 57 checks, 0 failed.
2026-11-12 cross-pin fallback in both clamp halves
    Ø2.2 hole through the bore's centre in the split plane, at the sleeve's mid-length. Each
    half gets a half-hole so the assembled clamp has a clean round hole straight through the
    shaft: if the friction grip on a plain Ø5 rod slips, drill the rod Ø2.2 and drop an M2 screw
    through. 90 N of shear at r 2.5 against ~600 N of screw - plenty, and it costs nothing when
    unused.
    In the split plane on purpose: the mating faces still close flat, and no pocket is weakened.
    57 checks, 0 failed.
2026-11-13 barrel: 52 deg skirt under the flange, spider flipped to stand on its ring
    The pod was exported bulkhead-down, which is right for the bulkhead disc but
    left the Ø136 flange as a 13 mm horizontal overhang 114 mm above the bed -
    either it droops and curls into the nozzle, or it wants support columns
    standing the full height of the barrel. A 2 mm conical skirt at 52 deg turns
    that overhang into an ordinary wall for 1.6 cm3.
    The spider was standing on its Ø18 boss: 254 mm2 of footprint carrying 39 cm3,
    with three arms overhanging 46 mm in mid-air. Flipped it stands on the ring,
    1512 mm2, and only the boss itself needs a support column.
    check_fits: 57 checks, 0 failed.
    [export_print_stls.py]
